GarinLev/Theseus_Maze/Firmware-rpi/YOLOmazeMINSK/test/images/photoMINSK2_20_jpg.rf.ec6164137c1f17c64afc8318696b5939.jpg

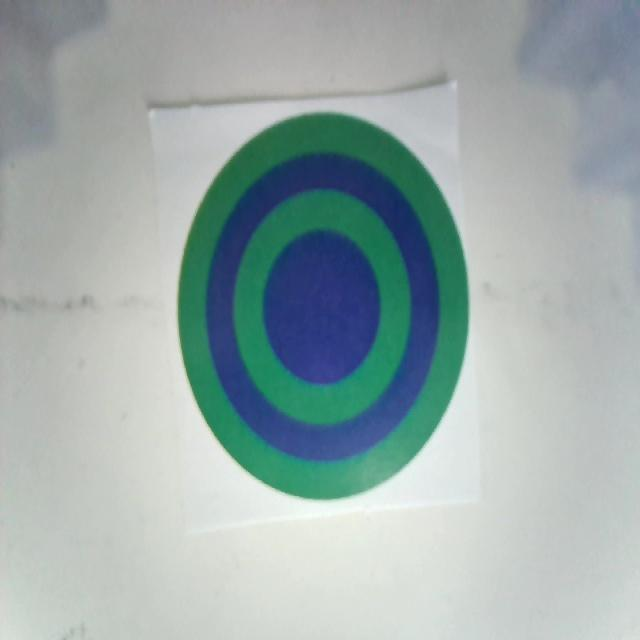
Firmware-rpi/YOLOmazeMINSK/test/images/photoMINSK2_20_jpg.rf.ec6164137c1f17c64afc8318696b5939.jpg
