GarinLev/Theseus_Maze/Firmware-rpi/YOLOmazeMINSK/test/images/photoMINSK2_60_jpg.rf.fc768a8888b5f13d683e1431a5816689.jpg

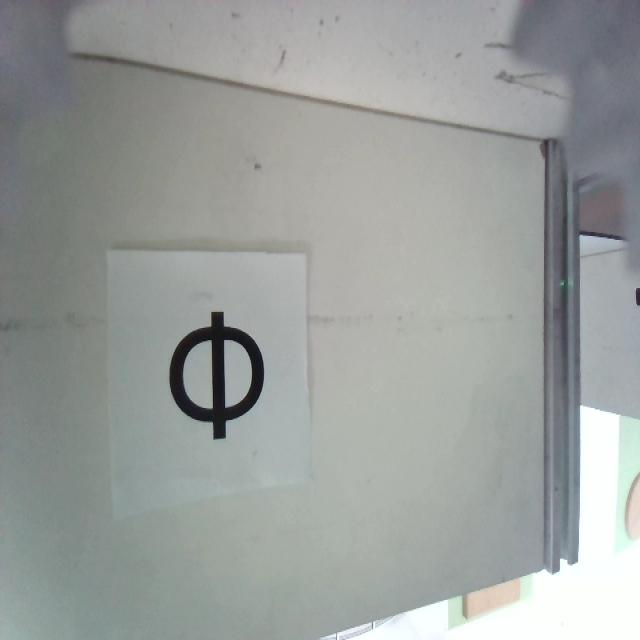
Firmware-rpi/YOLOmazeMINSK/test/images/photoMINSK2_60_jpg.rf.fc768a8888b5f13d683e1431a5816689.jpg
