GarinLev/Theseus_Maze/Documention/maze_konf.pdf.pptx

## Создание робота для исследования лабиринта с препятствиями и маркерами

Команда “Тесей”
RoboCup Runior rescue maze

## Актуальность – роботы для спасания людей

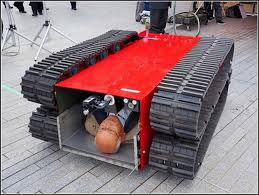
[picture p3: figure]
Марш спасателей: ТОП-10 роботов, которые спешат на помощь
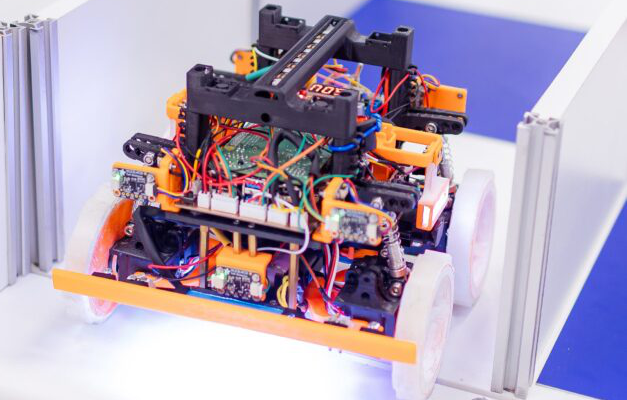
[picture p4: figure]
RCJ Rescue Maze - RoboCupJunior

спасение людей с помощью
роботов это актуальная тема
современного мира

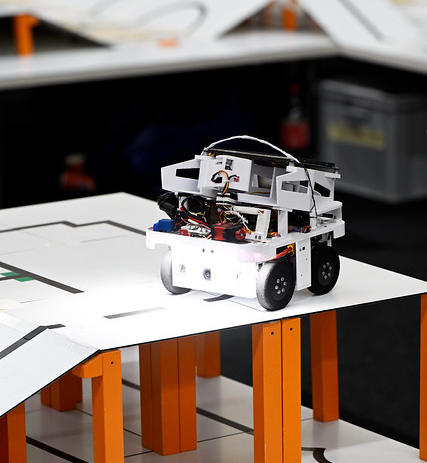
[picture p5: figure]
Rescue Leagues - RoboCupJunior
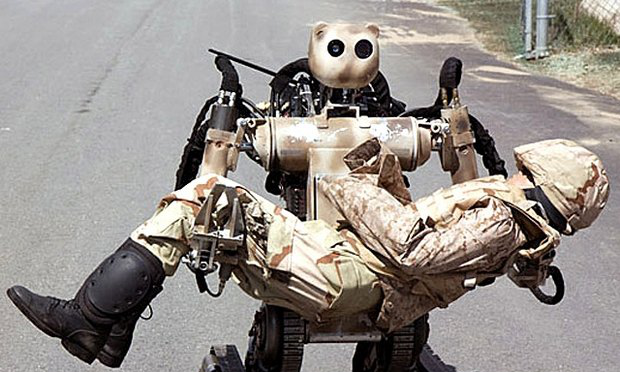
[picture p6: figure]
Как роботы спасают людей / Хабр

## Схожесть с реальной ситуацией

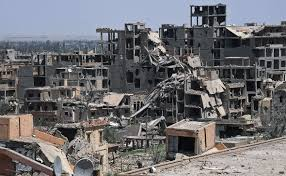
[picture p7: figure]
Силы тигра» разблокировали Дейр-эз-Зор :: Политика :: Газета РБК
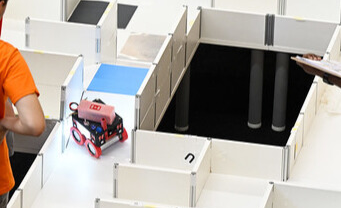
[picture p8: figure]
Rescue Leagues - RoboCupJunior
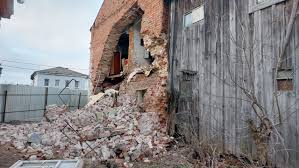
[picture p9: figure]
Если здание рухнет, то заделанные окна никак не помогут»: жительница Судогды рассказала про разрушенный дом | 31.01.2025 | Владимир - БезФормата
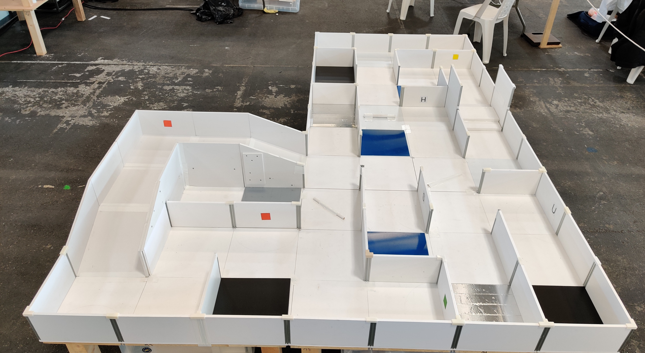
[picture p10: figure]
Competition Fields | 2023 Maze Competition

## Slide 4

Цель - создать робота, для прохождения лабиринта

Анализ аналогов

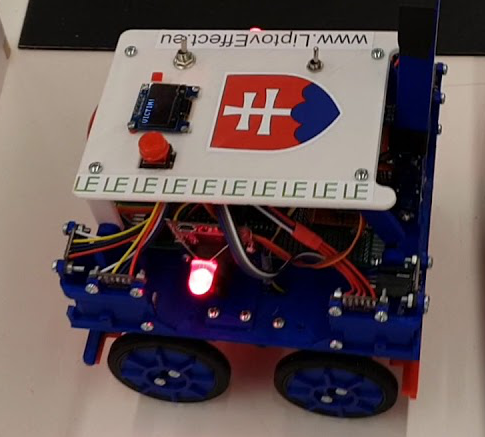
[picture p11: figure]
Robocup Junior 2018 Montreal Rescue Maze | Team liptoveffect.eu
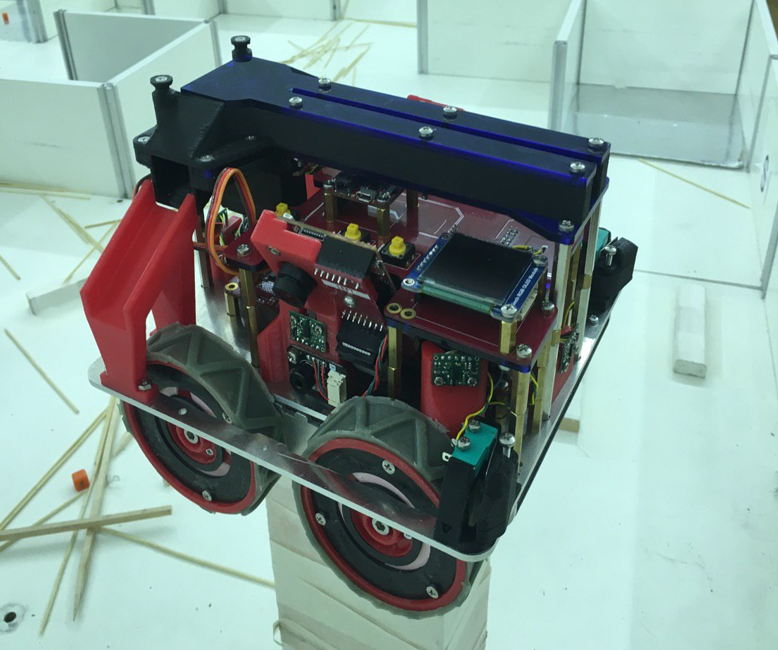
[picture p12: figure]
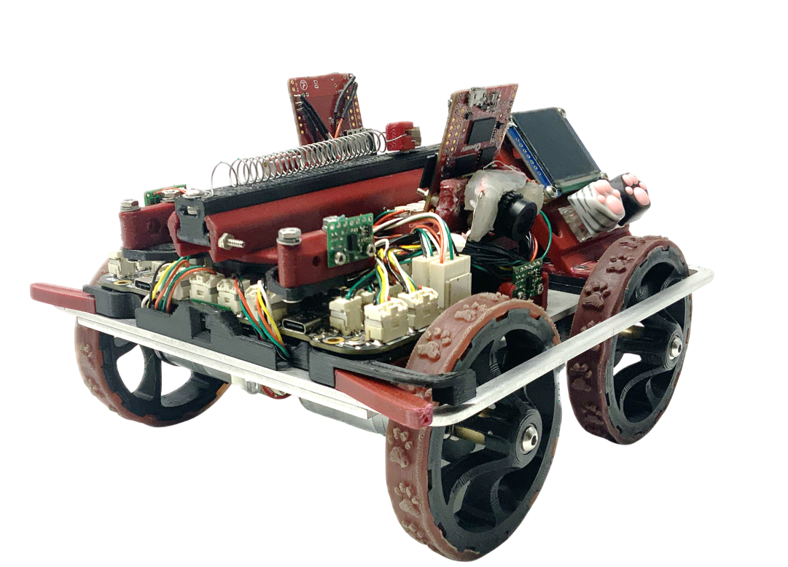
[picture p13: figure]
Изображение выглядит как колесо, автокомпонент, шина, Масштабная модель Контент, сгенерированный ИИ, может содержать ошибки.

Создание концепции своего робота

## Задача

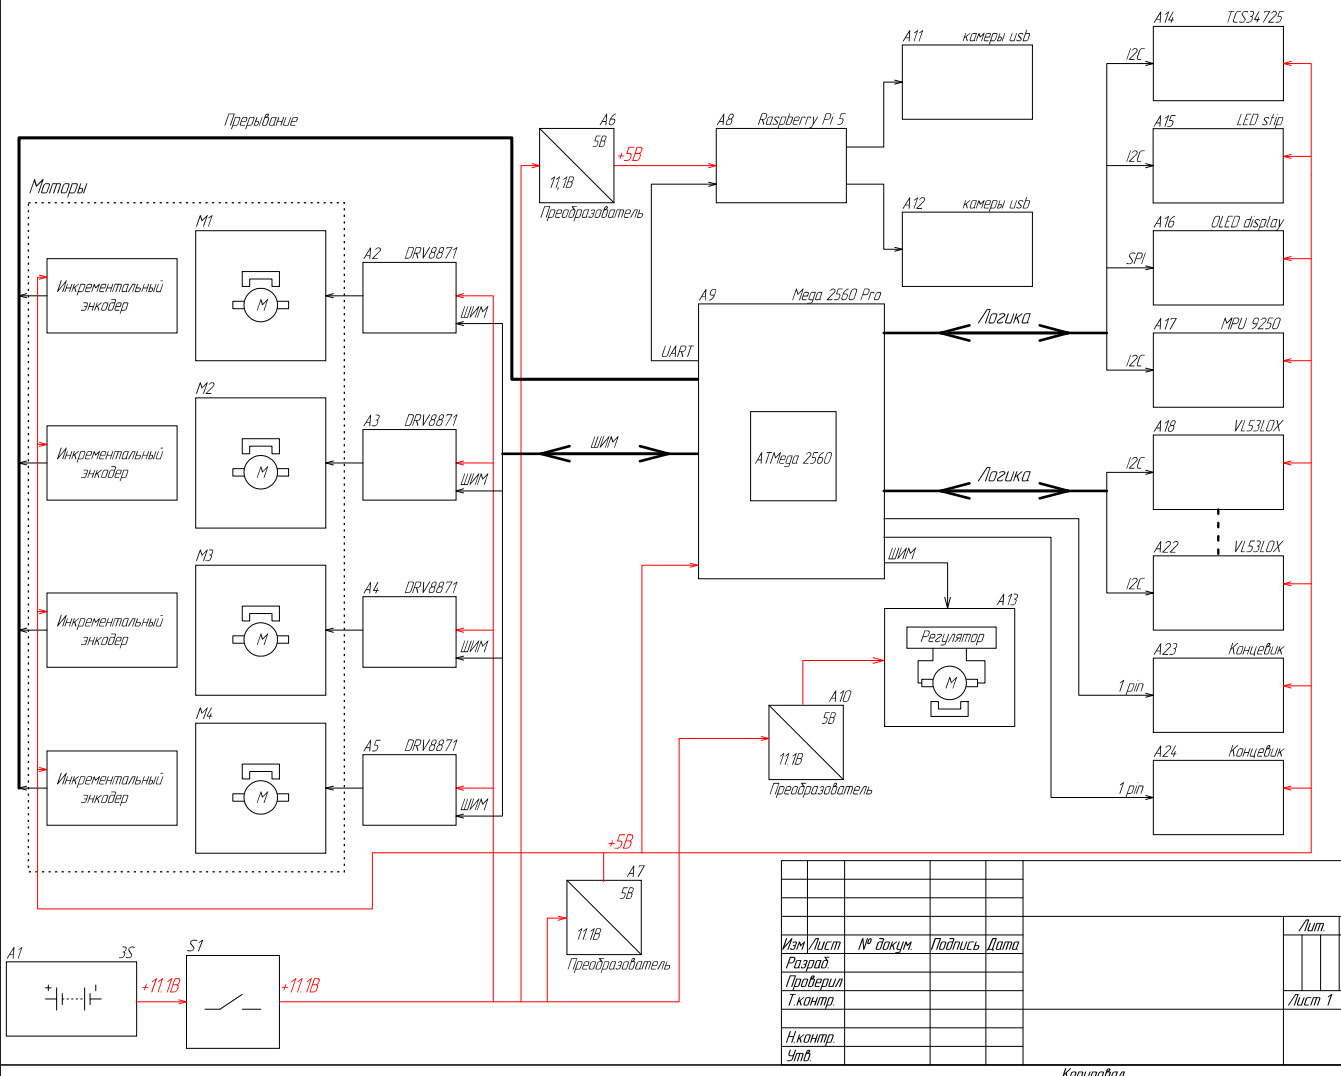
[picture p14: figure]

Схема

Notes: В качестве основного контролера используются Raspberry Pi 5. Он используется для камер и алгоритма поиска путей. Для управления электроникой, считывания значений с датчиков Arduino Mega 2560 Pro. Связь между ними осуществлена с помощью UART и логического преобразователя.
Для передвижения по лабиринту мы используем моторы. Для распознавания положения робота в клетке лазерные датчики VL53L0X.

## Разработка конструкции

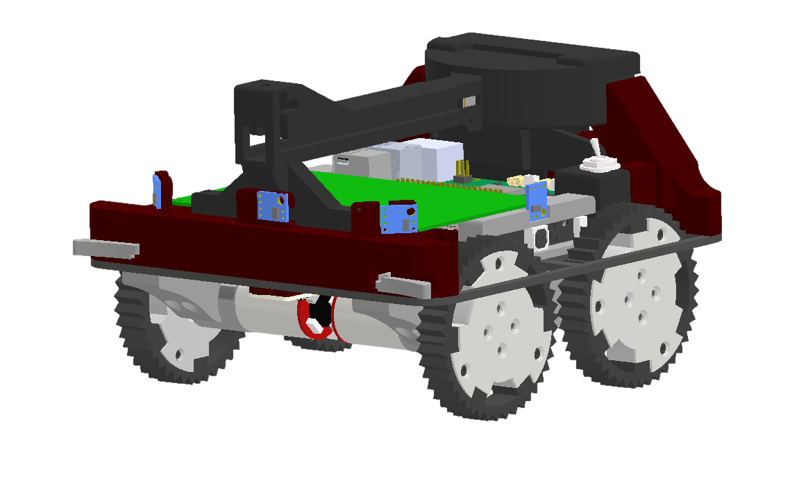
[picture p15: figure]
Изображение выглядит как колесо, Масштабная модель, игрушка, транспортное средство Контент, сгенерированный ИИ, может содержать ошибки.

Передняя часть

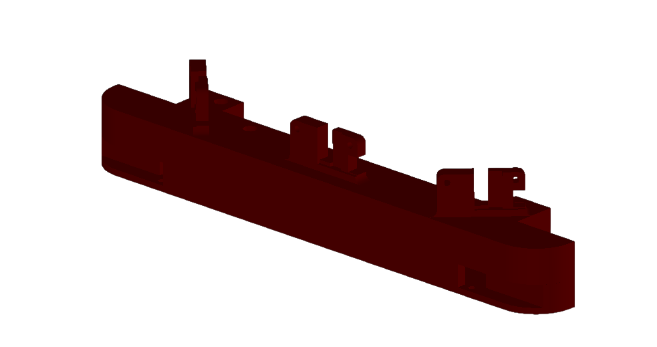
[picture p16: figure]
Изображение выглядит как снимок экрана Контент, сгенерированный ИИ, может содержать ошибки.

Задняя часть

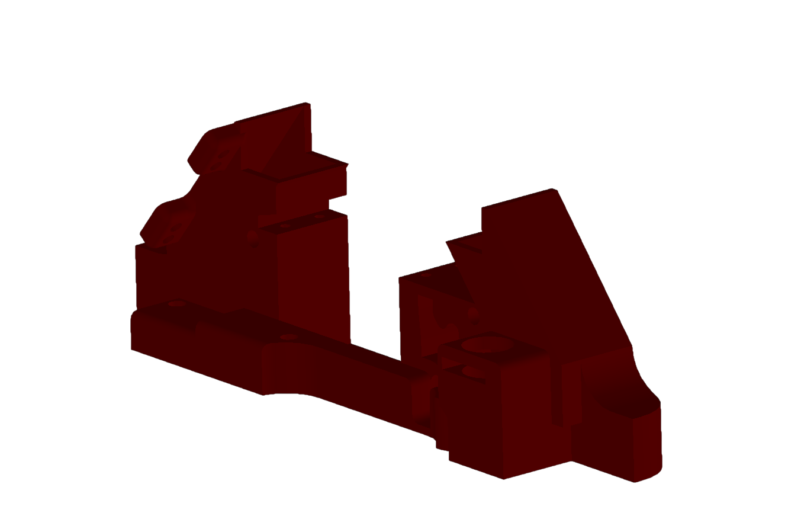
[picture p17: figure]
Изображение выглядит как красный Контент, сгенерированный ИИ, может содержать ошибки.

Система выдачи

Ходовая часть

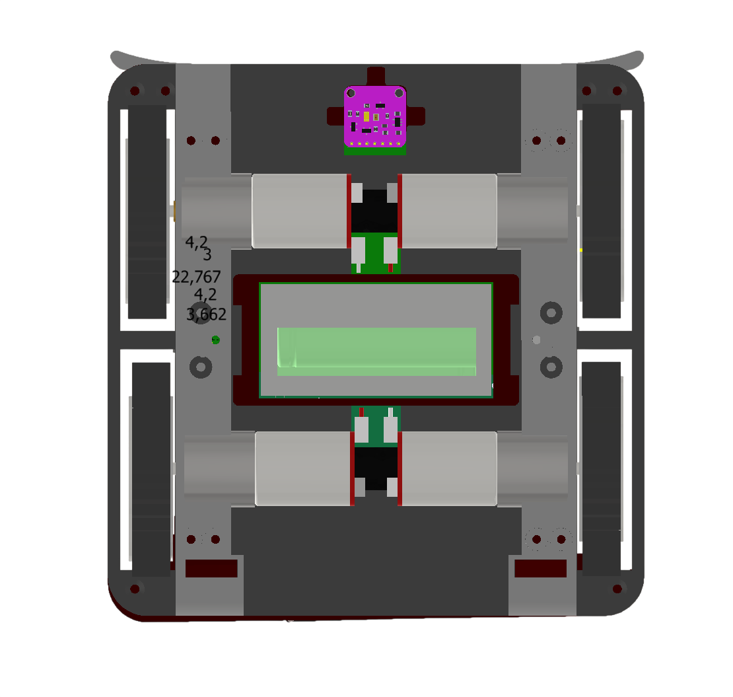
[picture p18: figure]
Изображение выглядит как снимок экрана Контент, сгенерированный ИИ, может содержать ошибки.
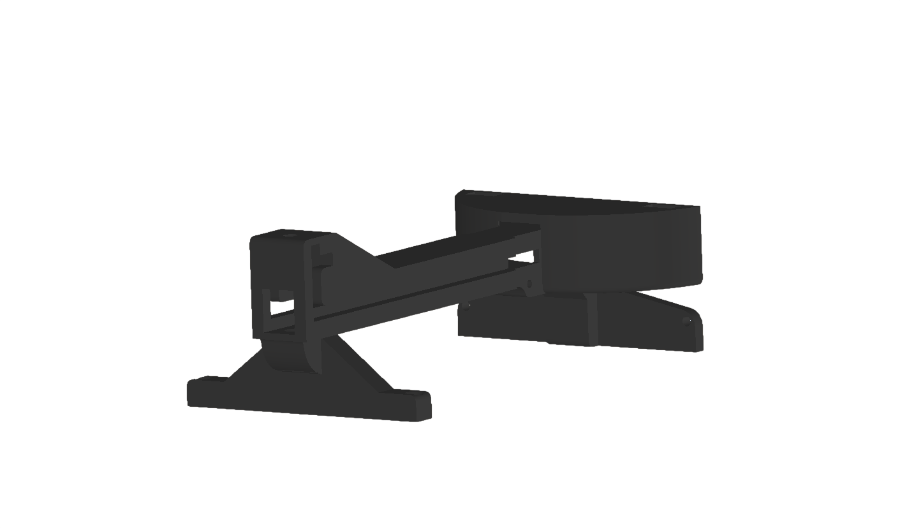
[picture p19: figure]

Notes: Наш робот смоделирован в программном обеспечении Autodesk inventor. Робот напечатан на 3D принтере PETG или PLA пластиком.

Для рамы мы использовали стеклонаполненный пластик для улучшения прочности робота. Что бы максимально уменьшить робота для проходимости в лабиринте, был спроектирован и сварен свой аккумулятор из ячеек Li-ion 18650 в конфигурации 3S1P. Корпус аккумулятора обеспечивает его быстросъёмность, так как фиксация в корпусе происходит посредством отгибающихся лепестков.

Модель робота для печати была разбита на переднюю и заднюю часть, ходовую часть и систему выдачи. В передней части расположены 3 датчика, концевики и место под крепления макетной платы. В задней части находится сервопривод, один датчик и барабан, который при вращение сортирует наборы по разным сторонам. Система выдачи толкает наборы по горизонтальному каналу системы выдачи, после чего наборы попадают в барабан
для выдачи их к жертве.



Были спроектированы собственные колеса робота. Имеющие переменную жесткость за счет своей формы. Диски колеса распечатаны на 3D принтере, а шины отлиты из двухкомпонентного полиуретана в распечатанные формы.

## Способ преодоления препятствий До После

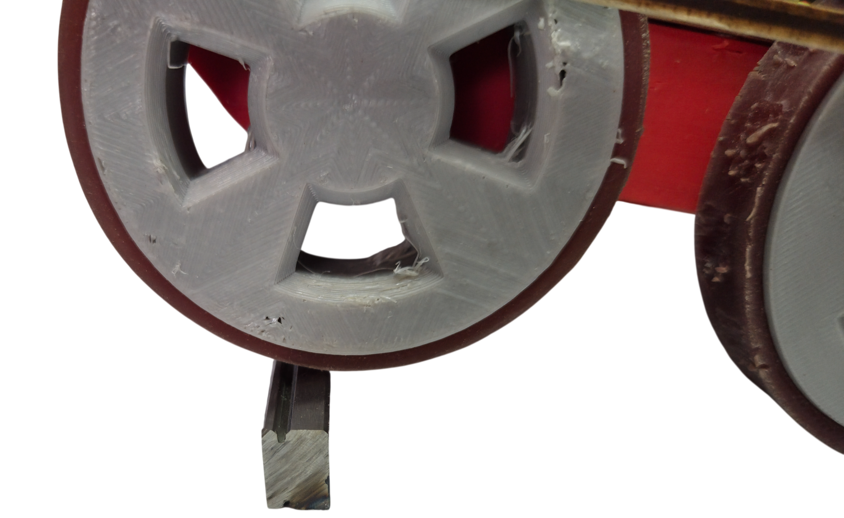
[picture p20: figure]
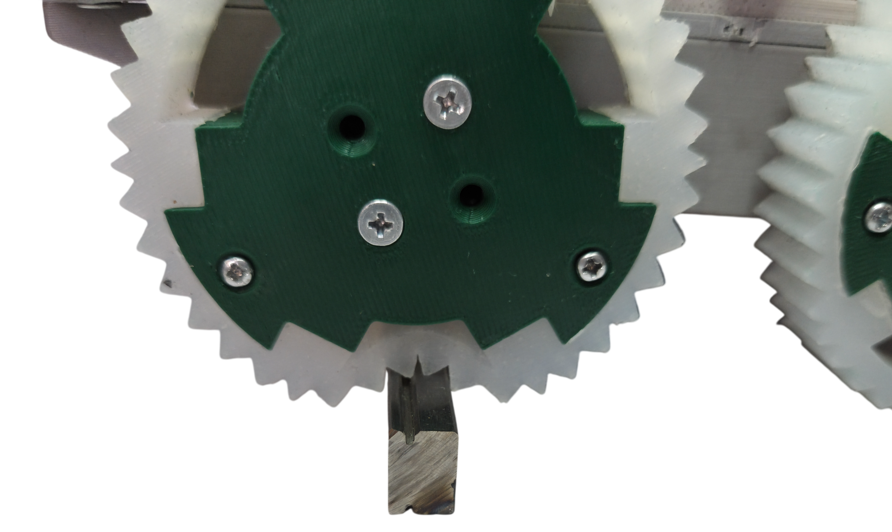
[picture p21: figure]
Изображение выглядит как шестерня, металлоизделия, колесо, транспорт Контент, сгенерированный ИИ, может содержать ошибки.

Notes: Основным способом у нас считаются особенные колёса.
Для этого были спроектированы собственные колеса робота. Диски колеса распечатаны на 3D принтере, а шины отлиты из двухкомпонентного полиуретана в распечатанные формы.

Колёса имеют переменную жесткость за счет своей формы, в отличии от обычных

## Программное обеспечение для Arduino

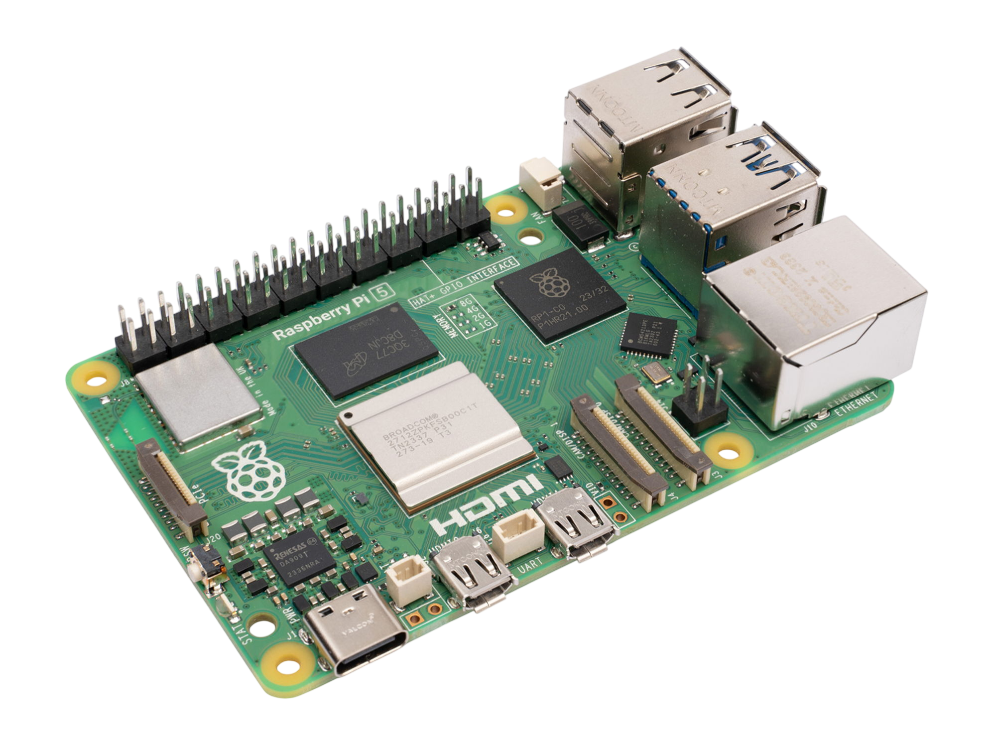
[picture p22: figure]
Изображение выглядит как электроника, Электронный компонент, Компонент схемы, Электронная техника Контент, сгенерированный ИИ, может содержать ошибки.
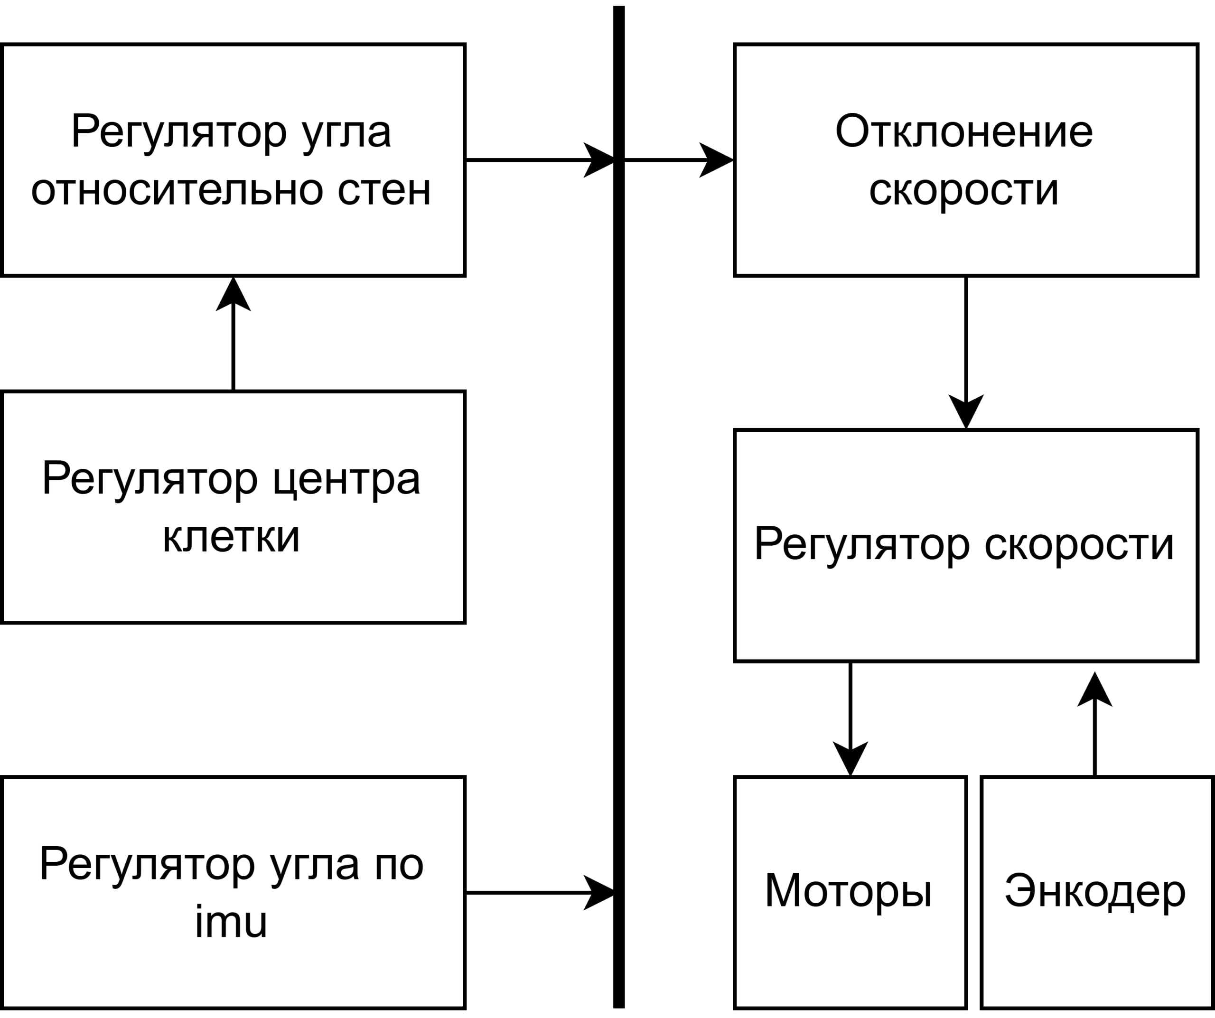
[picture p23: figure]
Изображение выглядит как текст, снимок экрана, диаграмма, Шрифт Контент, сгенерированный ИИ, может содержать ошибки.
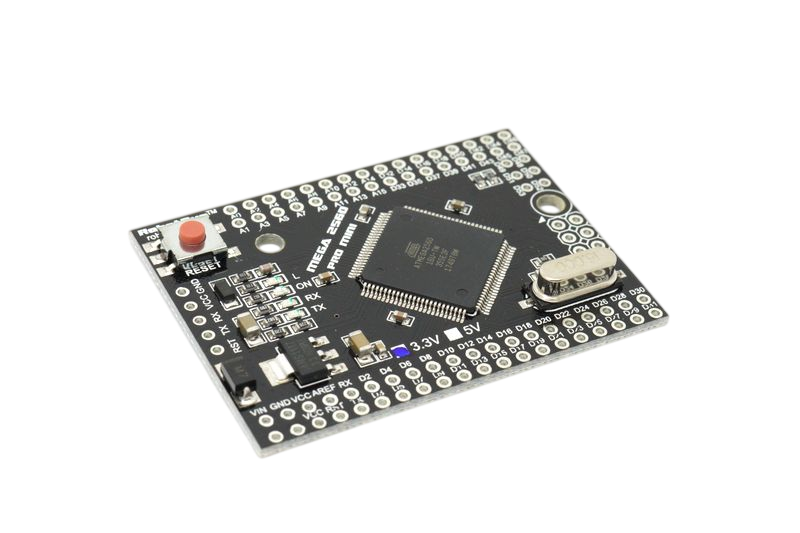
[picture p24: figure]
Изображение выглядит как электроника, Электронная техника, Электронный компонент, Компонент схемы Контент, сгенерированный ИИ, может содержать ошибки.

Notes: Робот принимает пакеты данных с Raspberry Pi по протоколу UART, проверяет контрольную сумму CRC8 и выполняет действие, после чего отправляет значения всех датчиков. Для поддержания заданной скорости колёс используется ПИ-регулятор.
Программа для Arduino Mega предназначена для управления четырьмя колёсами, сервоприводом для выдачи наборов и RGB-лентой для цветового оповещения. Код разделен на обособленные части для каждого компонента; для управления ими используется кооперативная многозадачность.
Для проезда на клетку вперёд проверяется наличие стен вокруг. При их обнаружении задействуется регулятор выравнивания угла относительно стены и центрирования положения между ними. Если во время движения приходит команда выдачи набора, программа прерывает выполнение задачи проезда и переходит в состояние выдачи. Если стены найти не удалось, используется проезд по инерциальному датчику

## Slide 9

Программное обеспечение для Raspberry

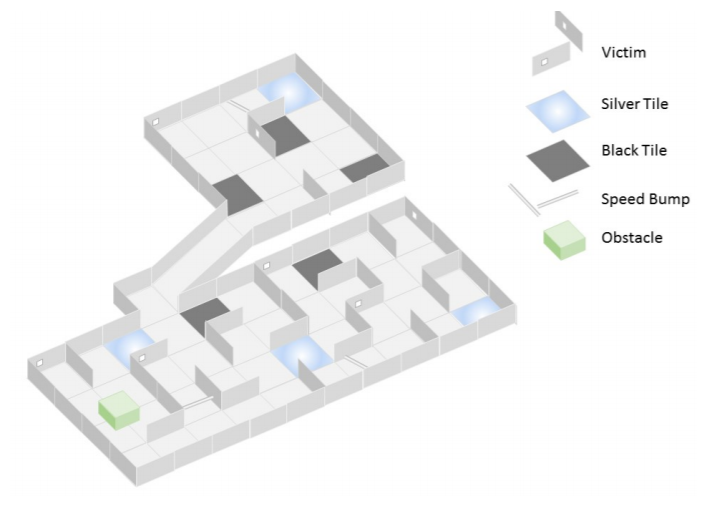
[picture p25: figure]
Robocup Junior Maze
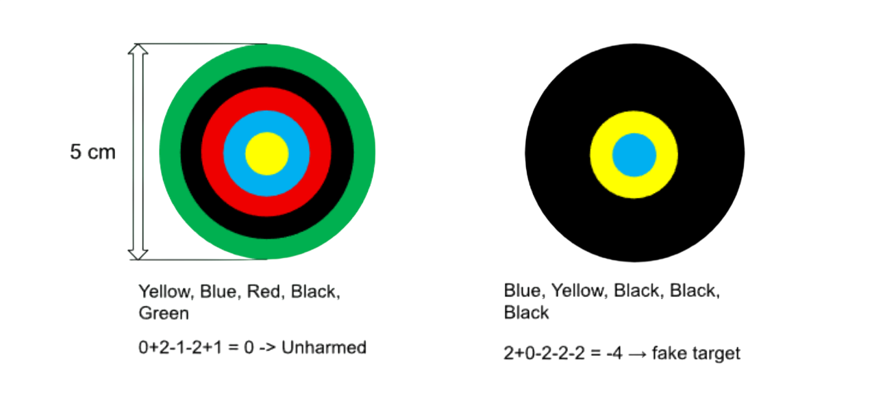
[picture p26: figure]
Изображение выглядит как круг, снимок экрана, Красочность, Графика Контент, сгенерированный ИИ, может содержать ошибки.
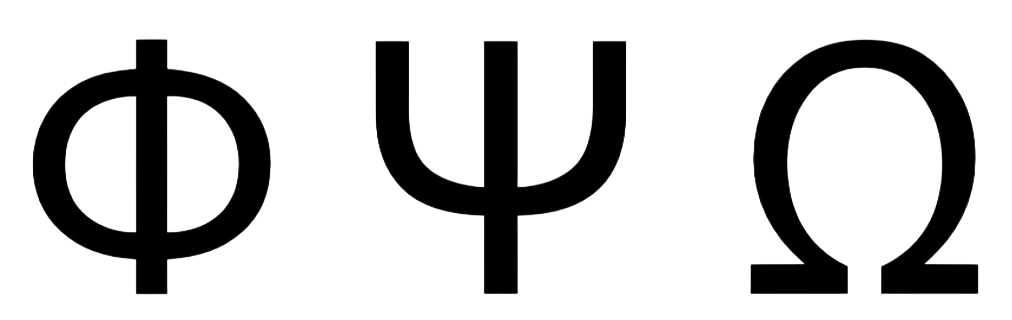
[picture p27: figure]
Изображение выглядит как черный, темнота, пространство, снимок экрана Контент, сгенерированный ИИ, может содержать ошибки.

Notes: Raspberry Pi 5 мы используем для разработки алгоритма езды и поиска путей. Мы едем по правой руке по лабиринту картографируя его. Когда мы попадем в замкнутый круг мы начинаем искать те клетки в которых ещё не были, а когда таких нету мы начинаем поиск проезда до начала лабиринта

Для когнитивных целей используется компьютерное зрение, программируемое на языке python с помощью библиотеки cv2.


Для распознания буквенных жертв используется нейронная сеть YOLO. Мы обучаем её на основе уже сделанных фото жертв в полигоне с камер на роботе.

Для распознания буквенных жертв используется нейронная сеть YOLO. Мы обучаем её на основе уже сделанных фото жертв в полигоне с камер на роботе.

## Спасибо за внимание

Участники:
Лев Гарин, Каверзнев Дмитрий
Преподаватели:
Мерзлякова Юлия Игоревна,
Викторов Борис Викторевич
