GarinLev/Theseus_Maze/Firmware-rpi/0009_critical_-2.png

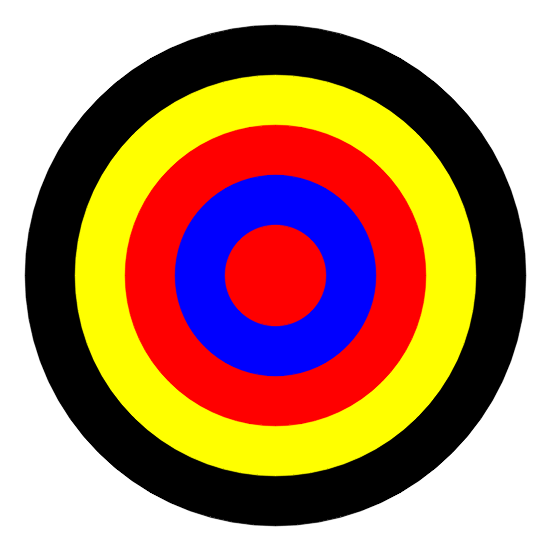
Firmware-rpi/0009_critical_-2.png
