GarinLev/Theseus_Maze/Firmware-rpi/0013_unharmed_0.png

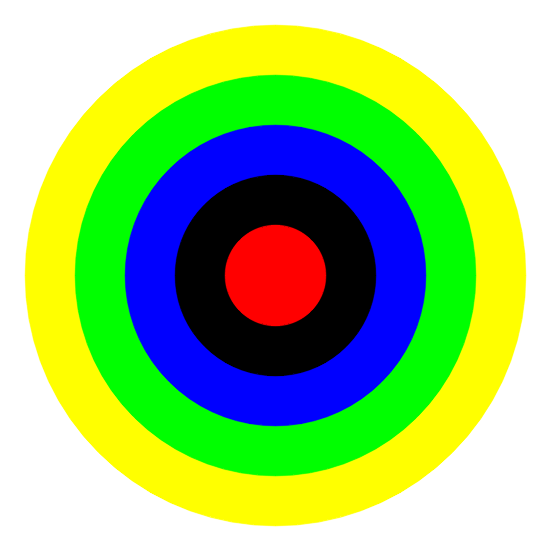
Firmware-rpi/0013_unharmed_0.png
