GarinLev/Theseus_Maze/Firmware-rpi/photo_12.jpg

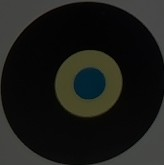
Firmware-rpi/photo_12.jpg
