GarinLev/Theseus_Maze/Firmware-rpi/photo_14.jpg

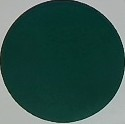
Firmware-rpi/photo_14.jpg
