GarinLev/Theseus_Maze/Firmware-rpi/photo_37.jpg

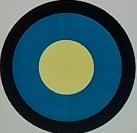
Firmware-rpi/photo_37.jpg
