GarinLev/Theseus_Maze/Firmware-rpi/photo_41.jpg

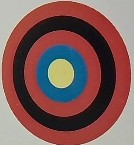
Firmware-rpi/photo_41.jpg
