GarinLev/Theseus_Maze/Firmware-rpi/photo_43.jpg

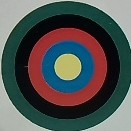
Firmware-rpi/photo_43.jpg
