GarinLev/Theseus_Maze/Firmware-rpi/YOLOmazeMINSK/runs/detect/train2/BoxF1_curve.png

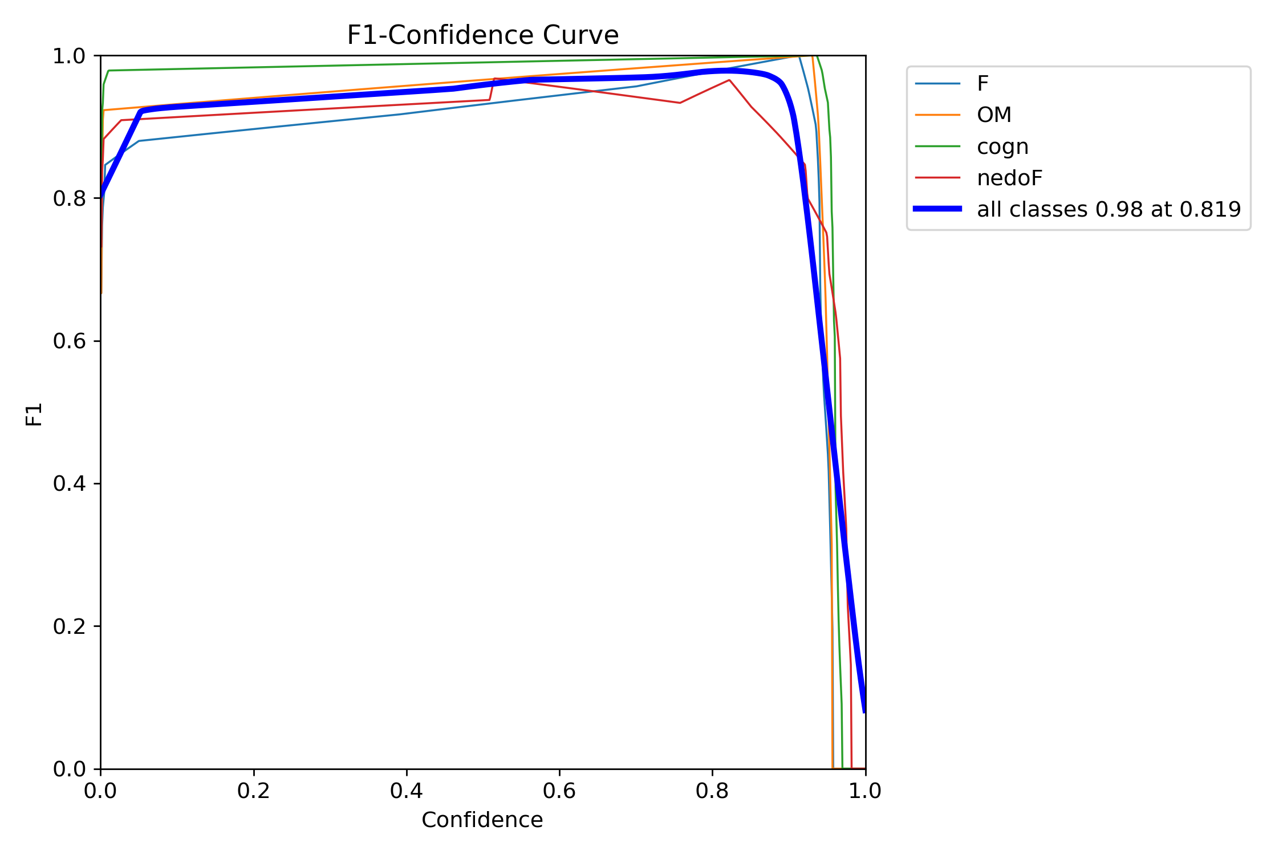
Firmware-rpi/YOLOmazeMINSK/runs/detect/train2/BoxF1_curve.png
