GarinLev/Theseus_Maze/Firmware-rpi/YOLOmazeMINSK/runs/detect/train2/BoxPR_curve.png

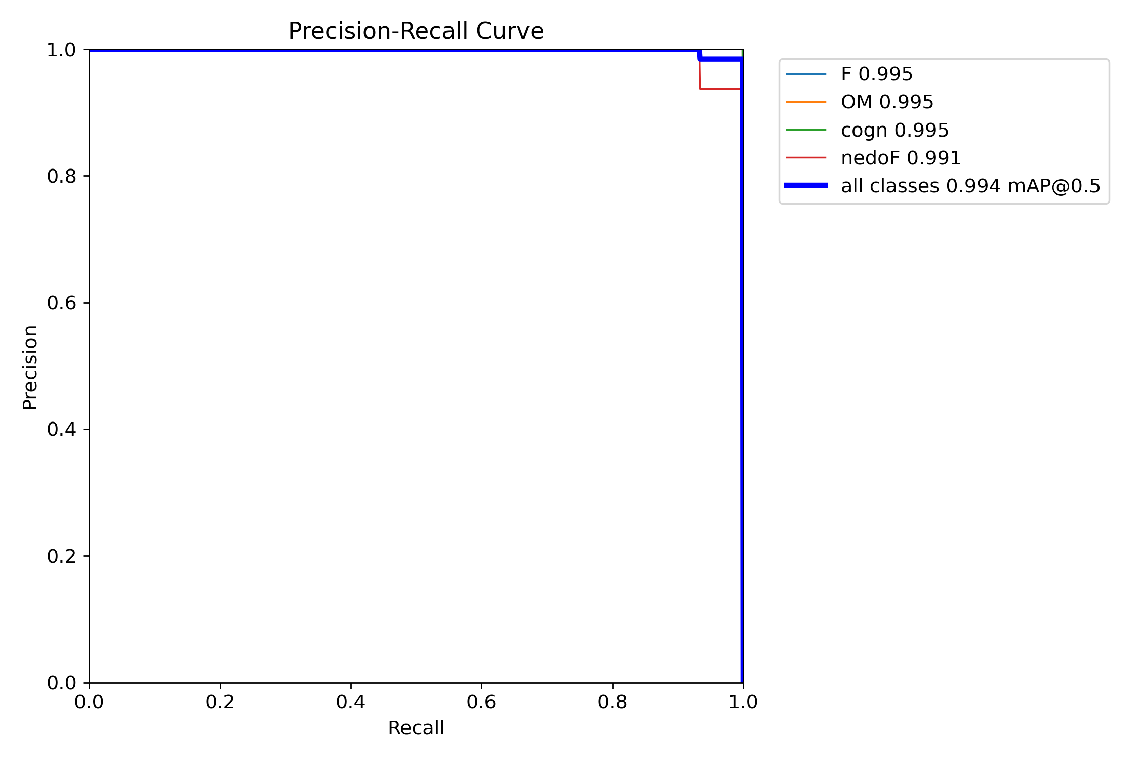
Firmware-rpi/YOLOmazeMINSK/runs/detect/train2/BoxPR_curve.png
