GarinLev/Theseus_Maze/Firmware-rpi/YOLOmazeMINSK/runs/detect/train2/confusion_matrix_normalized.png

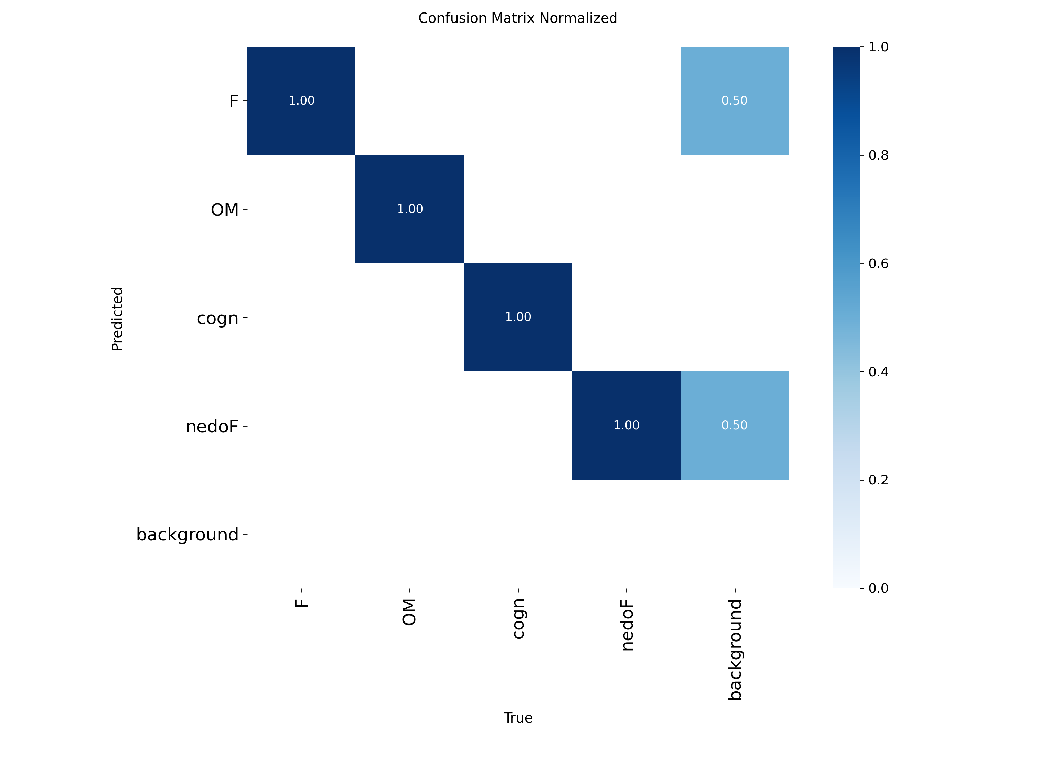
Firmware-rpi/YOLOmazeMINSK/runs/detect/train2/confusion_matrix_normalized.png
