GarinLev/Theseus_Maze/Firmware-rpi/YOLOmazeMINSK/runs/detect/train2/labels.jpg

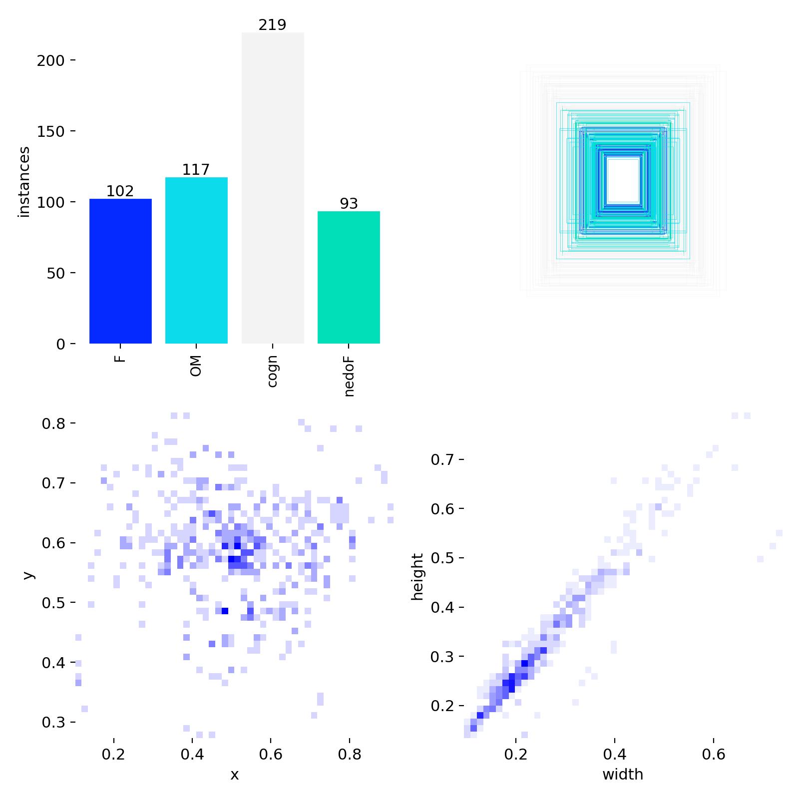
Firmware-rpi/YOLOmazeMINSK/runs/detect/train2/labels.jpg
