GarinLev/Theseus_Maze/Firmware-rpi/YOLOmazeMINSK/runs/detect/train2/train_batch0.jpg

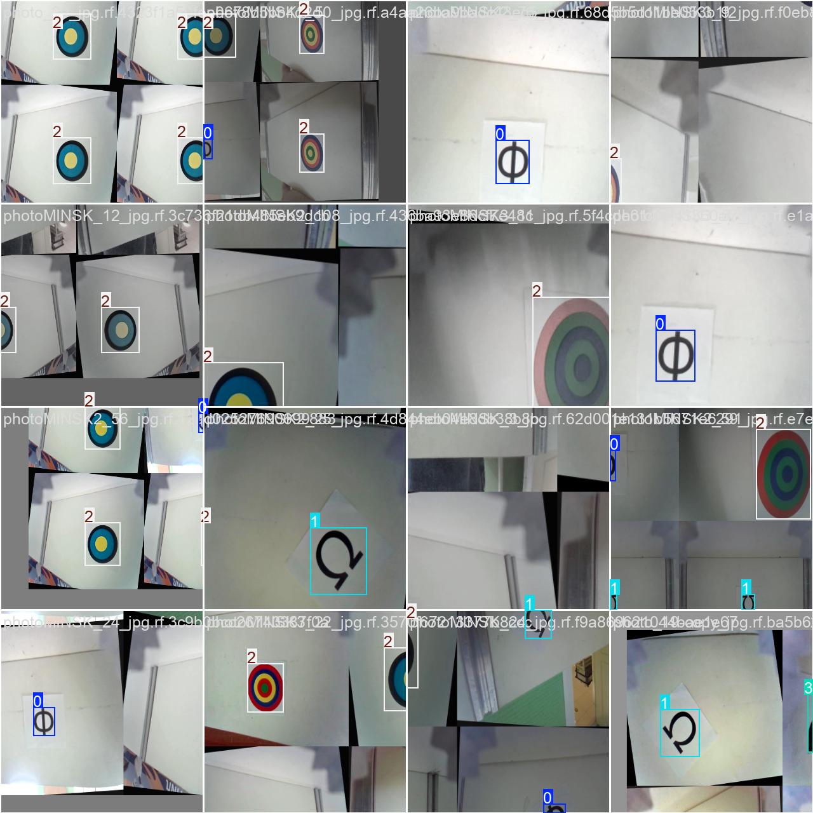
Firmware-rpi/YOLOmazeMINSK/runs/detect/train2/train_batch0.jpg
