GarinLev/Theseus_Maze/Firmware-rpi/YOLOmazeMINSK/runs/detect/train2/train_batch2.jpg

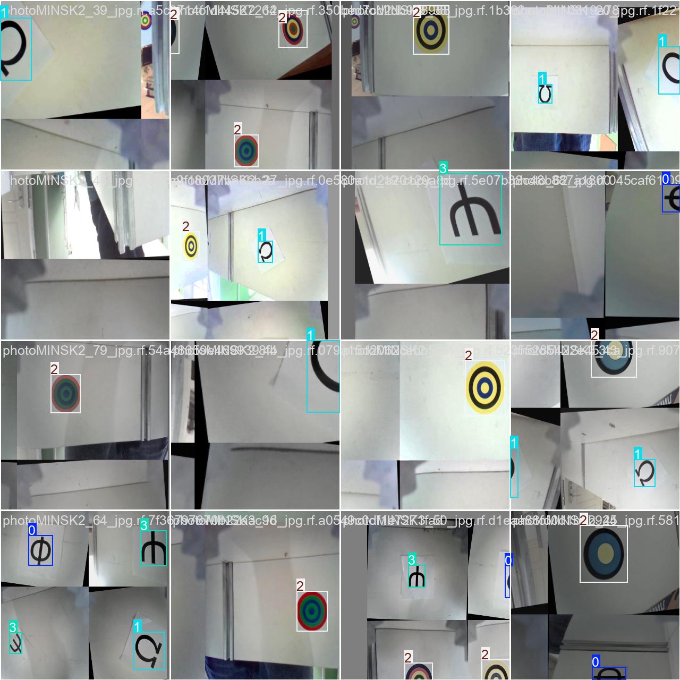
Firmware-rpi/YOLOmazeMINSK/runs/detect/train2/train_batch2.jpg
