GarinLev/Theseus_Maze/Firmware-rpi/YOLOmazeMINSK/runs/detect/train2/train_batch3060.jpg

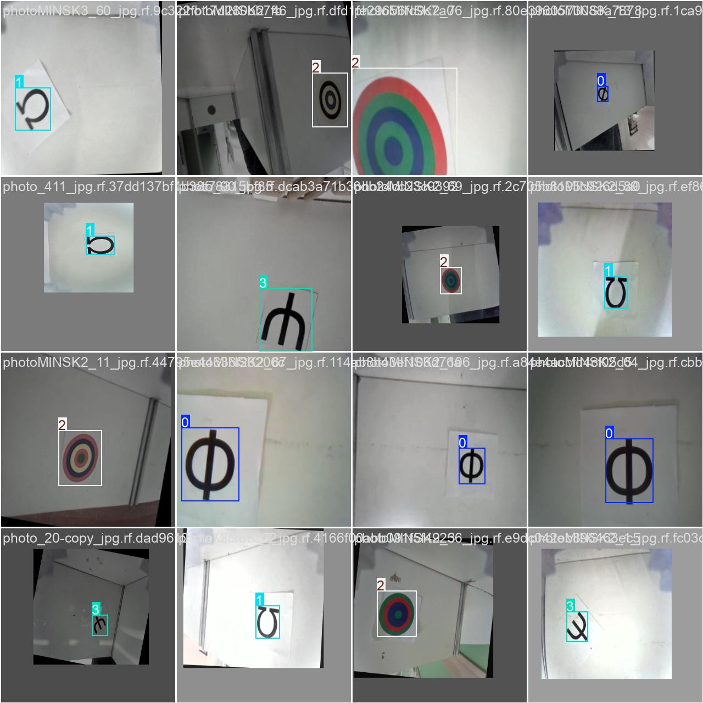
Firmware-rpi/YOLOmazeMINSK/runs/detect/train2/train_batch3060.jpg
