GarinLev/Theseus_Maze/Firmware-rpi/YOLOmazeMINSK/runs/detect/train2/val_batch0_labels.jpg

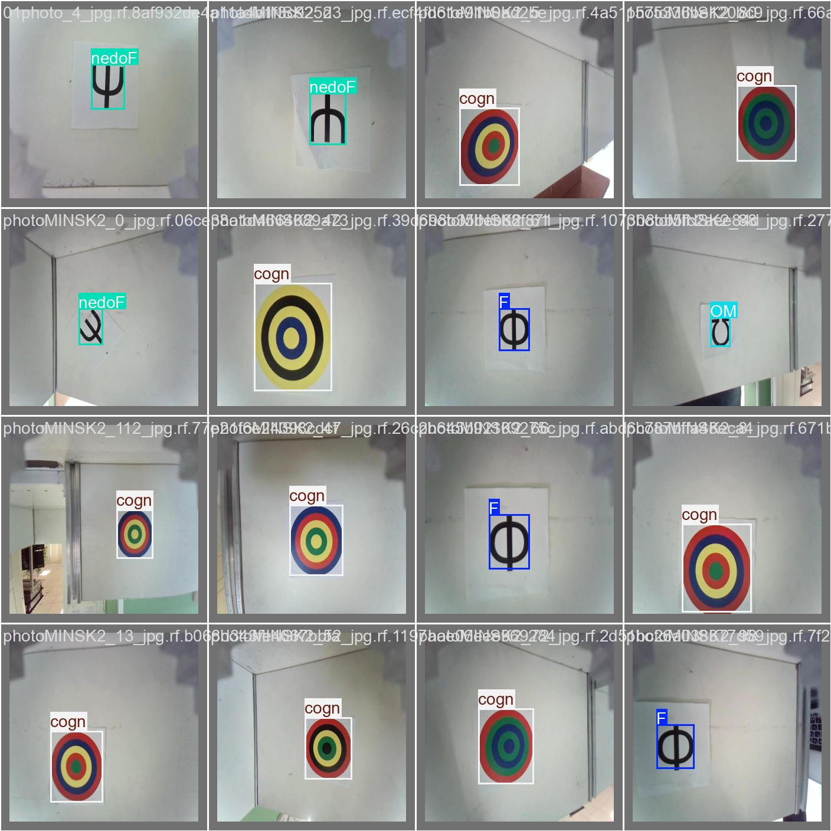
Firmware-rpi/YOLOmazeMINSK/runs/detect/train2/val_batch0_labels.jpg
