GarinLev/Theseus_Maze/Firmware-rpi/YOLOmazeMINSK/runs/detect/train/BoxP_curve.png

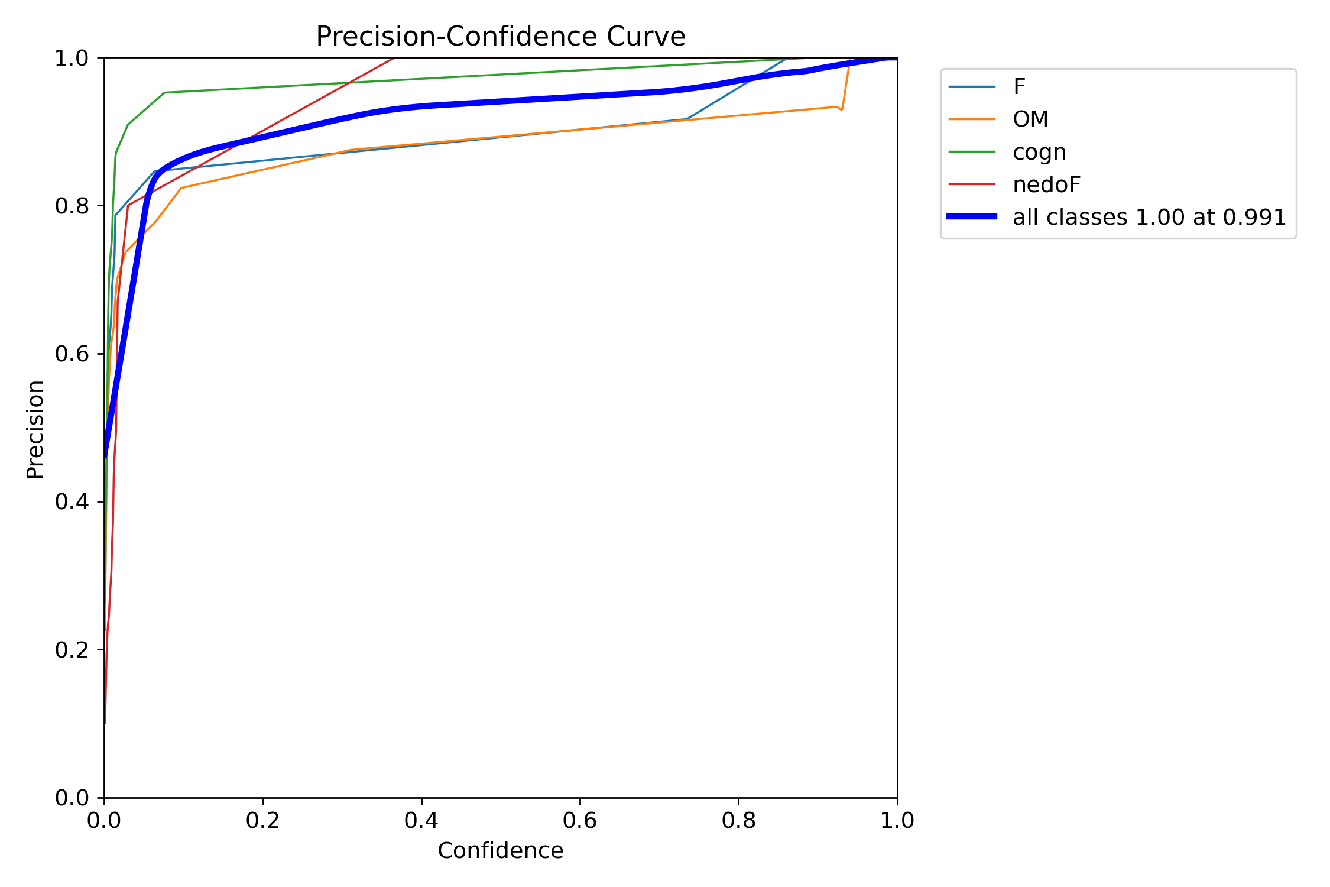
Firmware-rpi/YOLOmazeMINSK/runs/detect/train/BoxP_curve.png
