GarinLev/Theseus_Maze/Firmware-rpi/YOLOmazeMINSK/runs/detect/train/confusion_matrix.png

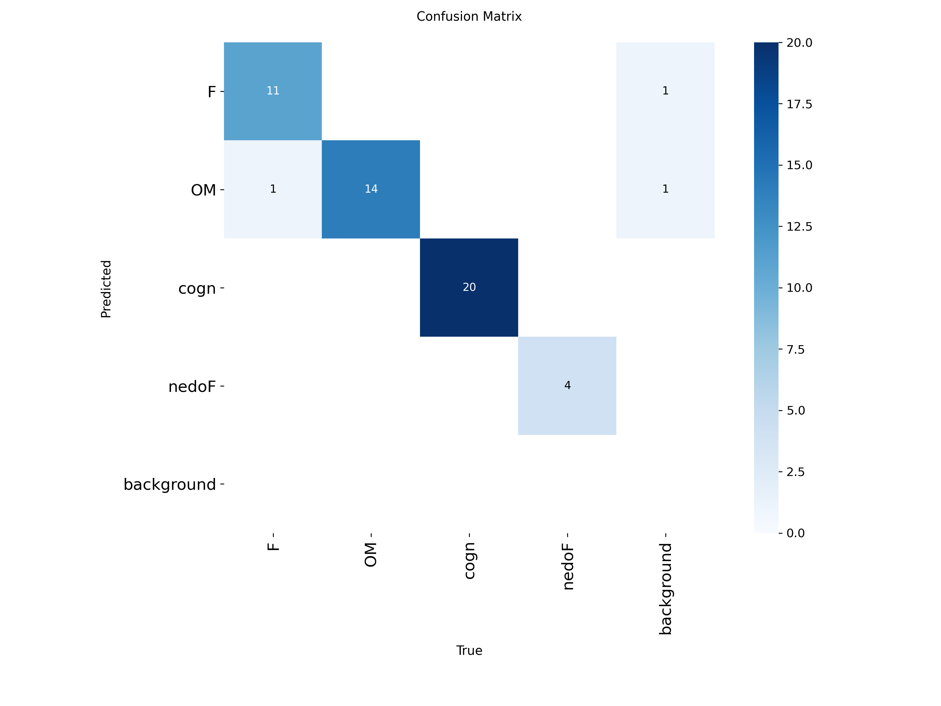
Firmware-rpi/YOLOmazeMINSK/runs/detect/train/confusion_matrix.png
