GarinLev/Theseus_Maze/Firmware-rpi/YOLOmazeMINSK/runs/detect/train/labels.jpg

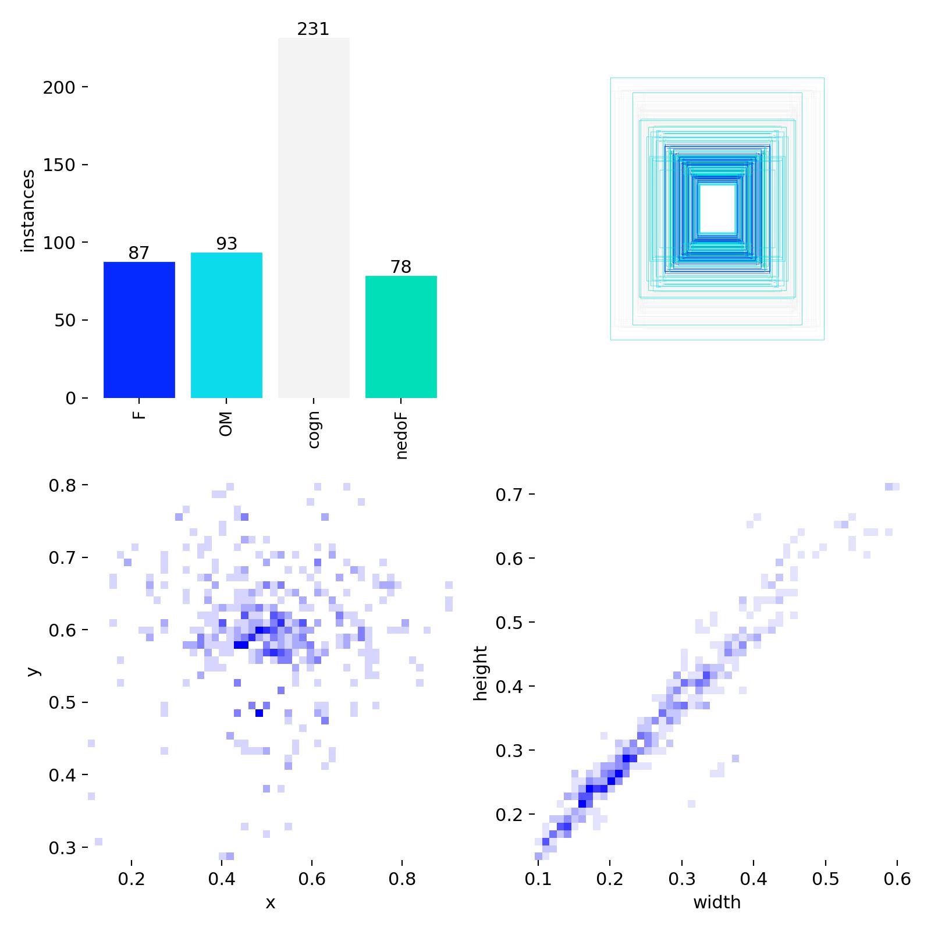
Firmware-rpi/YOLOmazeMINSK/runs/detect/train/labels.jpg
