GarinLev/Theseus_Maze/Firmware-rpi/YOLOmazeMINSK/runs/detect/train/train_batch2.jpg

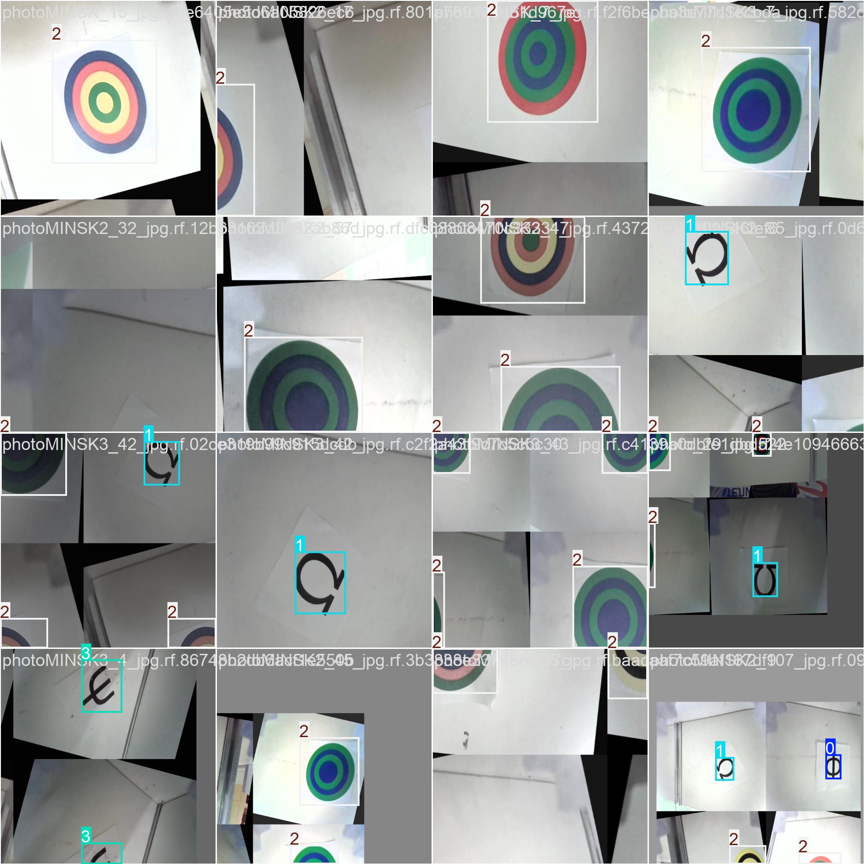
Firmware-rpi/YOLOmazeMINSK/runs/detect/train/train_batch2.jpg
