GarinLev/Theseus_Maze/Firmware-rpi/YOLOmazeMINSK/runs/detect/train/train_batch1550.jpg

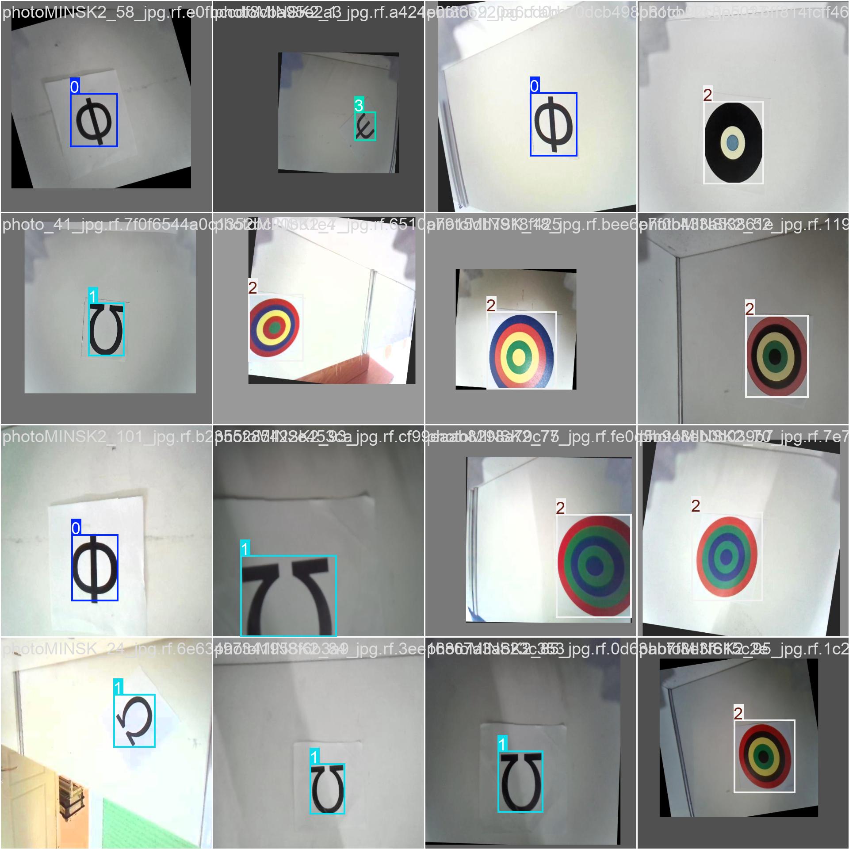
Firmware-rpi/YOLOmazeMINSK/runs/detect/train/train_batch1550.jpg
