GarinLev/Theseus_Maze/Firmware-rpi/YOLOmazeMINSK/runs/detect/train/train_batch1552.jpg

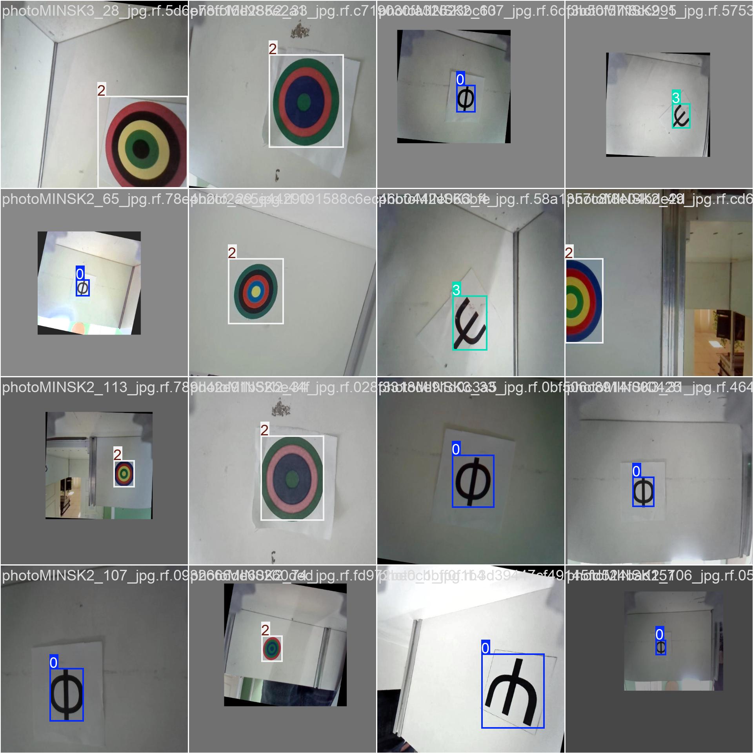
Firmware-rpi/YOLOmazeMINSK/runs/detect/train/train_batch1552.jpg
