GarinLev/Theseus_Maze/Firmware-rpi/YOLOmazeMINSK/valid/images/photo_2_jpg.rf.d231389361c17eb98d468609f3844cb6.jpg

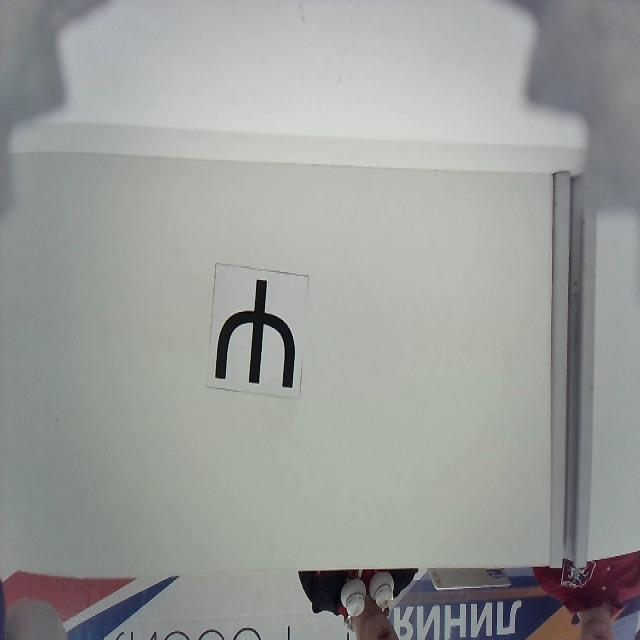
Firmware-rpi/YOLOmazeMINSK/valid/images/photo_2_jpg.rf.d231389361c17eb98d468609f3844cb6.jpg
