GarinLev/Theseus_Maze/Firmware-rpi/YOLOmazeMINSK/valid/images/photo_8_jpg.rf.9a8f130c2fd47f7036db581c19f1b032.jpg

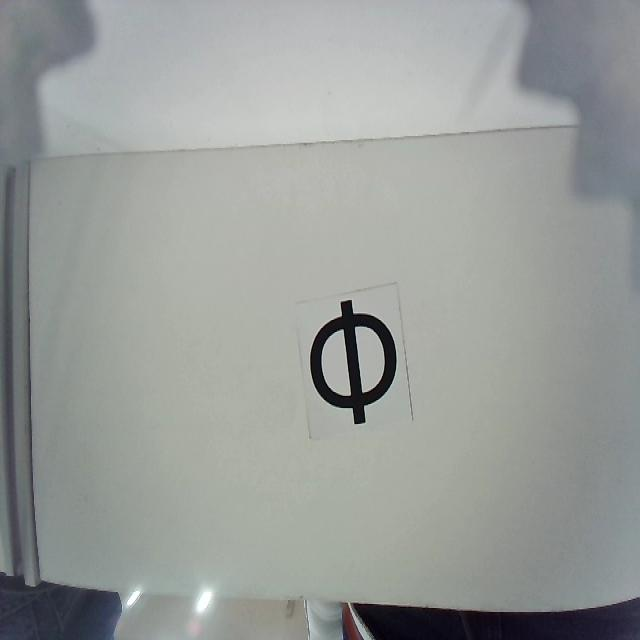
Firmware-rpi/YOLOmazeMINSK/valid/images/photo_8_jpg.rf.9a8f130c2fd47f7036db581c19f1b032.jpg
