GarinLev/Theseus_Maze/Firmware-rpi/YOLOmazeMINSK/valid/images/photo_23_jpg.rf.431b37f80fdaf00b54d127120dc3ab56.jpg

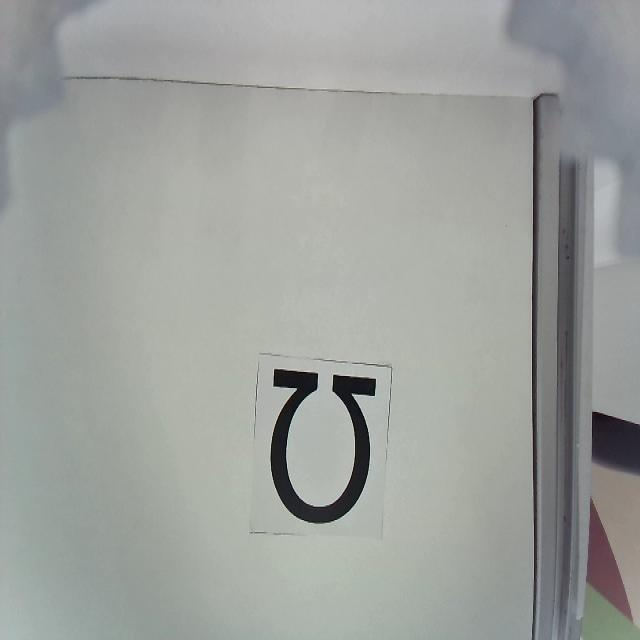
Firmware-rpi/YOLOmazeMINSK/valid/images/photo_23_jpg.rf.431b37f80fdaf00b54d127120dc3ab56.jpg
