GarinLev/Theseus_Maze/Firmware-rpi/YOLOmazeMINSK/valid/images/photo_25_jpg.rf.424e68be355fe93c4aea49201ae01b50.jpg

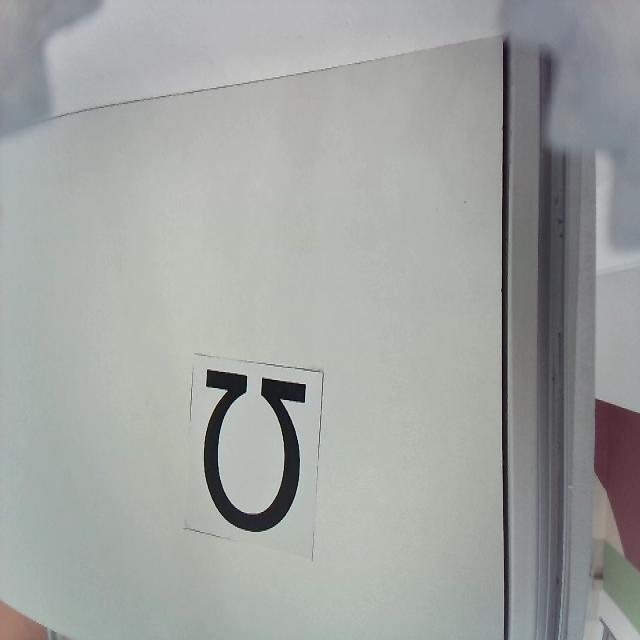
Firmware-rpi/YOLOmazeMINSK/valid/images/photo_25_jpg.rf.424e68be355fe93c4aea49201ae01b50.jpg
