GarinLev/Theseus_Maze/Firmware-rpi/YOLOmazeMINSK/valid/images/photo_35_jpg.rf.38aa4155de912e12c1f1f9ac93a501c3.jpg

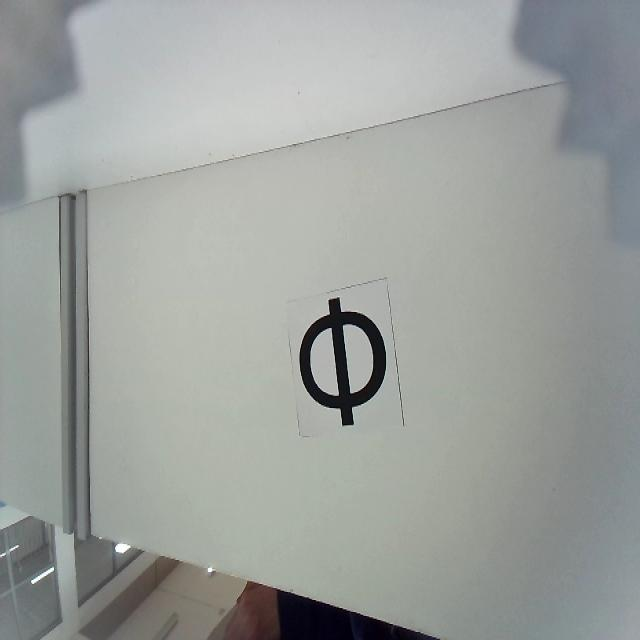
Firmware-rpi/YOLOmazeMINSK/valid/images/photo_35_jpg.rf.38aa4155de912e12c1f1f9ac93a501c3.jpg
