GarinLev/Theseus_Maze/Firmware-rpi/YOLOmazeMINSK/valid/images/photo_37_jpg.rf.5798d28824521689e4e56326ce15f14a.jpg

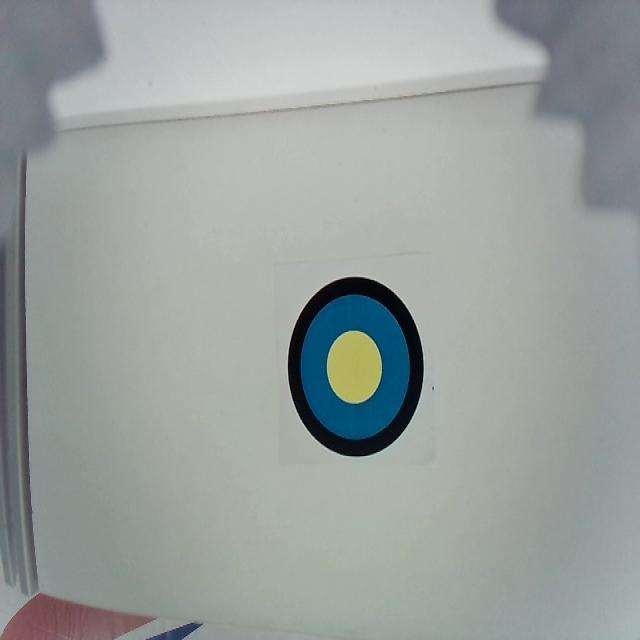
Firmware-rpi/YOLOmazeMINSK/valid/images/photo_37_jpg.rf.5798d28824521689e4e56326ce15f14a.jpg
