GarinLev/Theseus_Maze/Firmware-rpi/YOLOmazeMINSK/valid/images/photo_38_jpg.rf.67c268e312a70e2e9a9d1eaaa8585dbd.jpg

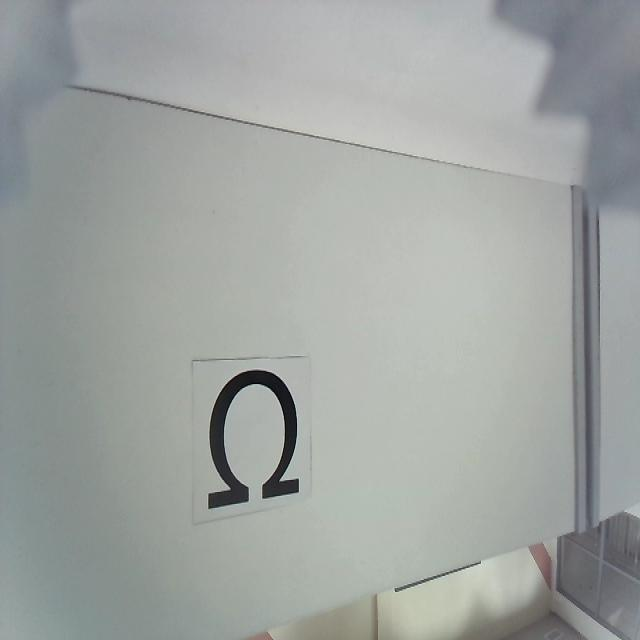
Firmware-rpi/YOLOmazeMINSK/valid/images/photo_38_jpg.rf.67c268e312a70e2e9a9d1eaaa8585dbd.jpg
