GarinLev/Theseus_Maze/Firmware-rpi/YOLOmazeMINSK/valid/images/photo_40_jpg.rf.25876b04db469f665f66d0922bac243a.jpg

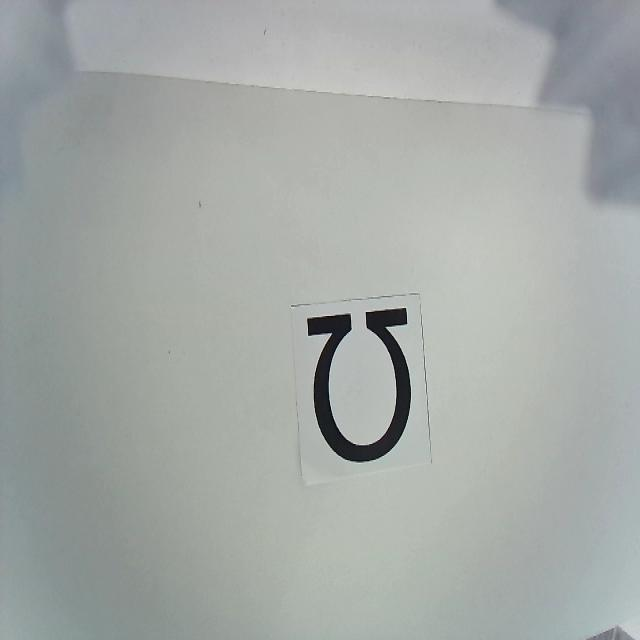
Firmware-rpi/YOLOmazeMINSK/valid/images/photo_40_jpg.rf.25876b04db469f665f66d0922bac243a.jpg
