GarinLev/Theseus_Maze/Firmware-rpi/YOLOmazeMINSK/valid/images/photo_61_jpg.rf.487324a0c7c61724d0280a7fe8aa8b09.jpg

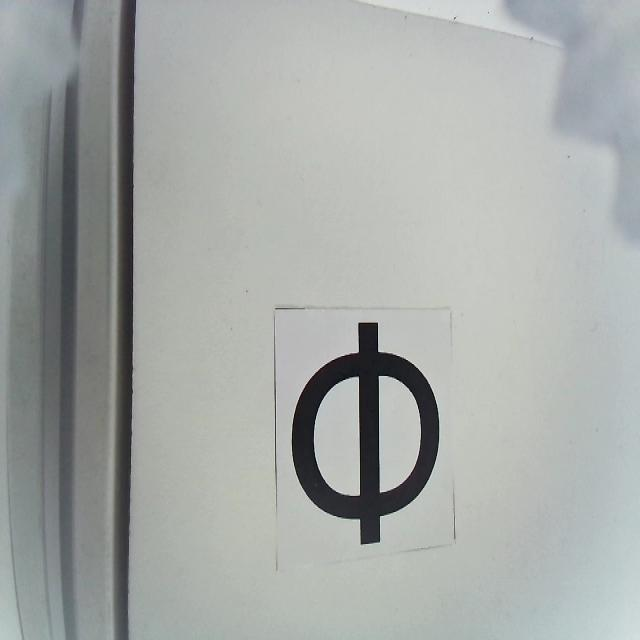
Firmware-rpi/YOLOmazeMINSK/valid/images/photo_61_jpg.rf.487324a0c7c61724d0280a7fe8aa8b09.jpg
