GarinLev/Theseus_Maze/Firmware-rpi/YOLOmazeMINSK/valid/images/photo_62_jpg.rf.d462a5341da273b37e98f73d5386eb85.jpg

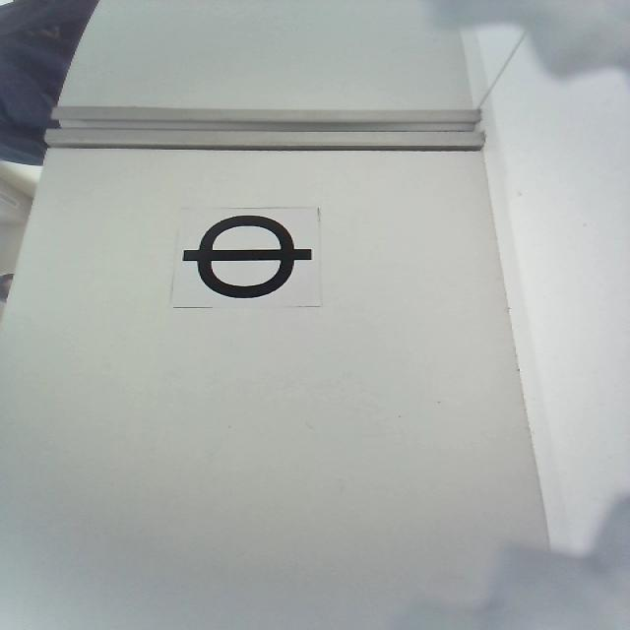
Firmware-rpi/YOLOmazeMINSK/valid/images/photo_62_jpg.rf.d462a5341da273b37e98f73d5386eb85.jpg
