GarinLev/Theseus_Maze/Firmware-rpi/YOLOmazeMINSK/valid/images/photoMINSK2_5_jpg.rf.4a511575336be120bc9023f43c1ee158.jpg

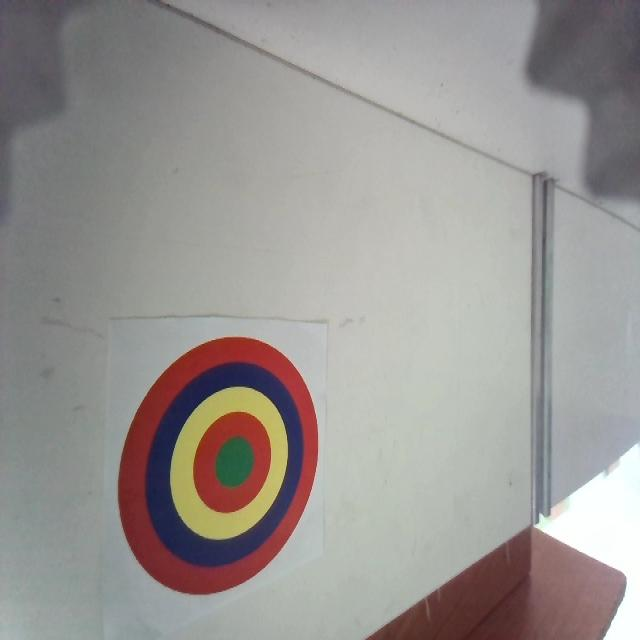
Firmware-rpi/YOLOmazeMINSK/valid/images/photoMINSK2_5_jpg.rf.4a511575336be120bc9023f43c1ee158.jpg
