GarinLev/Theseus_Maze/Firmware-rpi/YOLOmazeMINSK/valid/images/photoMINSK2_12_jpg.rf.efe4584688df54cb0ad6cdaab3504829.jpg

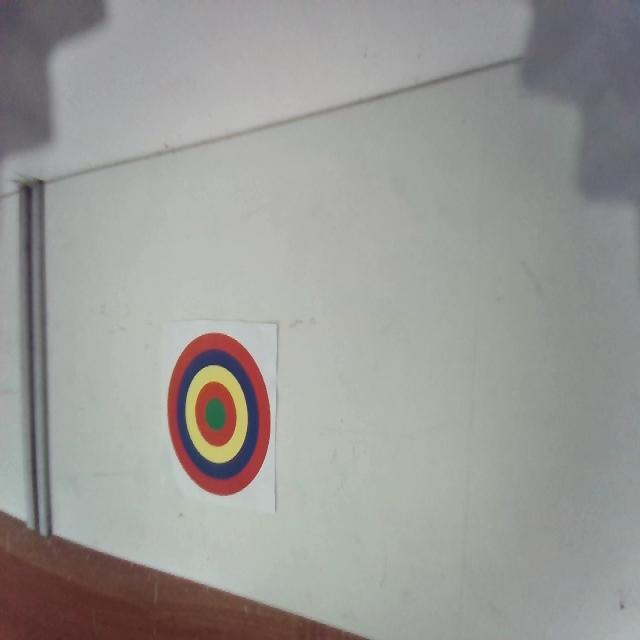
Firmware-rpi/YOLOmazeMINSK/valid/images/photoMINSK2_12_jpg.rf.efe4584688df54cb0ad6cdaab3504829.jpg
