GarinLev/Theseus_Maze/Firmware-rpi/YOLOmazeMINSK/valid/images/photoMINSK2_15_jpg.rf.d42b9faf1058bd21d5f9f15b459c619f.jpg

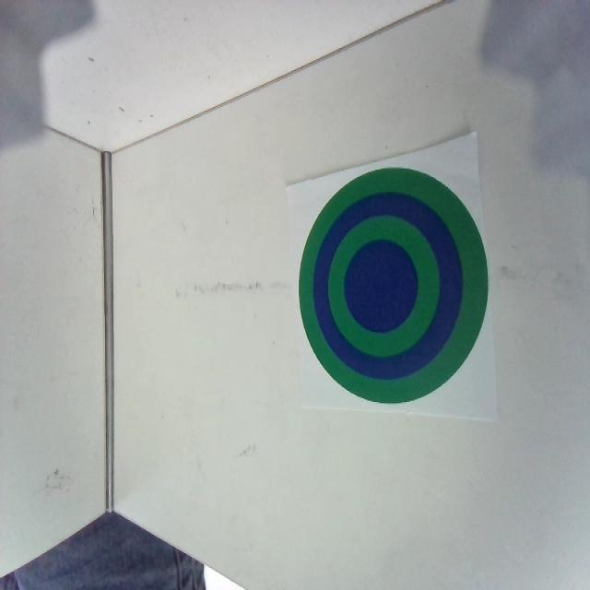
Firmware-rpi/YOLOmazeMINSK/valid/images/photoMINSK2_15_jpg.rf.d42b9faf1058bd21d5f9f15b459c619f.jpg
