GarinLev/Theseus_Maze/Firmware-rpi/YOLOmazeMINSK/valid/images/photoMINSK2_26_jpg.rf.cc9993a7ba5d3e5f2a16f9c1e9e3d562.jpg

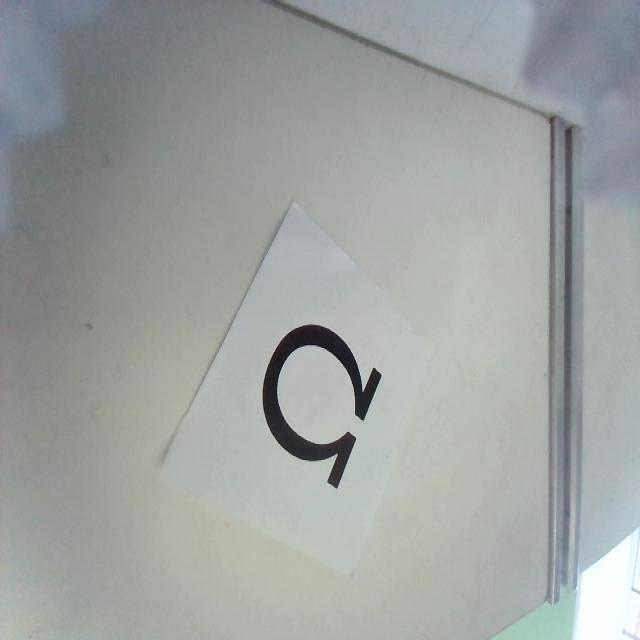
Firmware-rpi/YOLOmazeMINSK/valid/images/photoMINSK2_26_jpg.rf.cc9993a7ba5d3e5f2a16f9c1e9e3d562.jpg
