GarinLev/Theseus_Maze/Firmware-rpi/YOLOmazeMINSK/valid/images/photoMINSK2_27_jpg.rf.0e580a1d2a20129a8d5b7cf6493947de.jpg

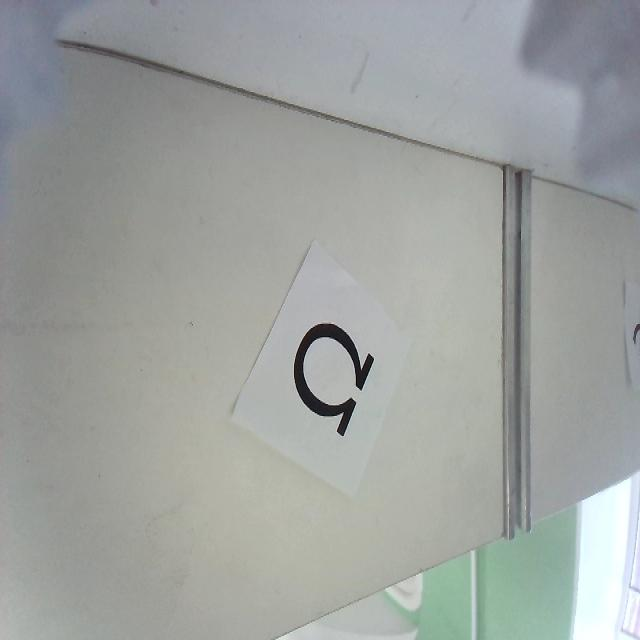
Firmware-rpi/YOLOmazeMINSK/valid/images/photoMINSK2_27_jpg.rf.0e580a1d2a20129a8d5b7cf6493947de.jpg
