GarinLev/Theseus_Maze/Firmware-rpi/YOLOmazeMINSK/valid/images/photoMINSK2_30_jpg.rf.99003f61a87ce4c41ef99937e16a8fad.jpg

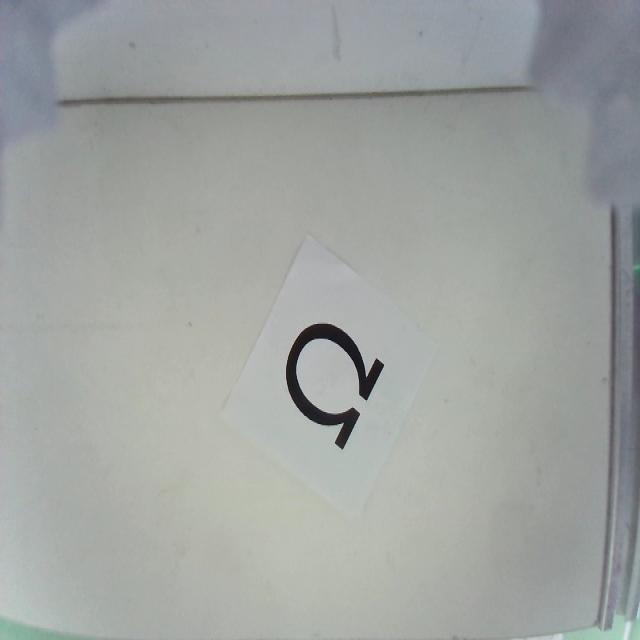
Firmware-rpi/YOLOmazeMINSK/valid/images/photoMINSK2_30_jpg.rf.99003f61a87ce4c41ef99937e16a8fad.jpg
