GarinLev/Theseus_Maze/Firmware-rpi/YOLOmazeMINSK/valid/images/photoMINSK2_31_jpg.rf.a6d30e84491521d2ec3d6eb6bf052d40.jpg

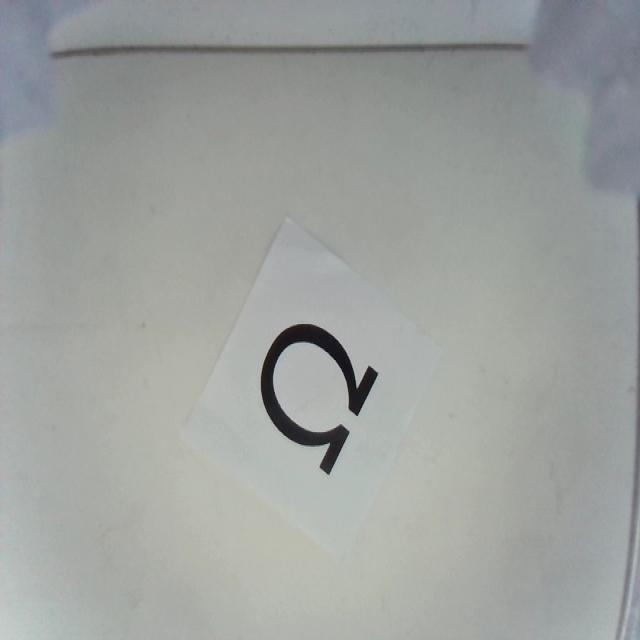
Firmware-rpi/YOLOmazeMINSK/valid/images/photoMINSK2_31_jpg.rf.a6d30e84491521d2ec3d6eb6bf052d40.jpg
