GarinLev/Theseus_Maze/Firmware-rpi/YOLOmazeMINSK/valid/images/photoMINSK2_37_jpg.rf.b4ade3511d52e05aaa85c309f136dddf.jpg

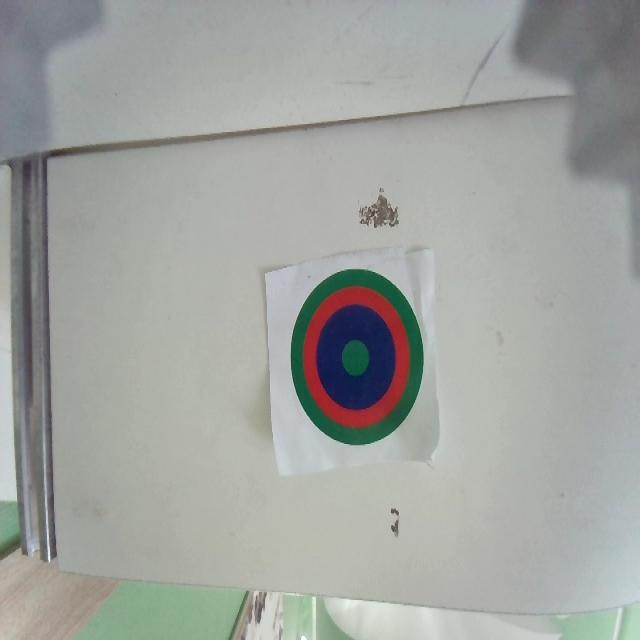
Firmware-rpi/YOLOmazeMINSK/valid/images/photoMINSK2_37_jpg.rf.b4ade3511d52e05aaa85c309f136dddf.jpg
