GarinLev/Theseus_Maze/Firmware-rpi/YOLOmazeMINSK/valid/images/photoMINSK2_38_jpg.rf.80a9453f03b5175e8d4036839f2ea041.jpg

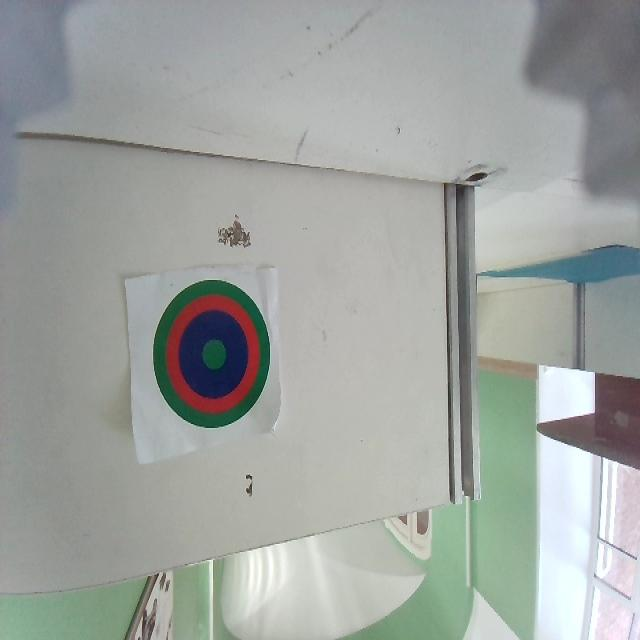
Firmware-rpi/YOLOmazeMINSK/valid/images/photoMINSK2_38_jpg.rf.80a9453f03b5175e8d4036839f2ea041.jpg
