GarinLev/Theseus_Maze/Firmware-rpi/YOLOmazeMINSK/valid/images/photoMINSK2_46_jpg.rf.0294ac9488a0058aa2098d76e95b3a7d.jpg

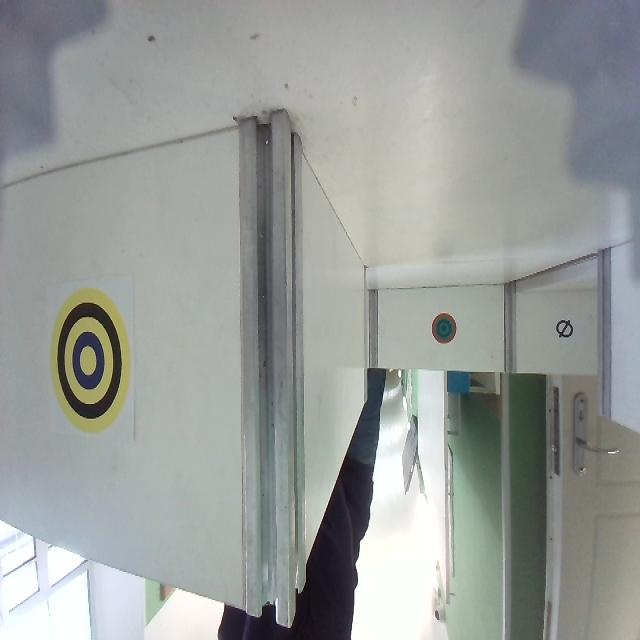
Firmware-rpi/YOLOmazeMINSK/valid/images/photoMINSK2_46_jpg.rf.0294ac9488a0058aa2098d76e95b3a7d.jpg
