GarinLev/Theseus_Maze/Firmware-rpi/YOLOmazeMINSK/valid/images/photoMINSK2_51_jpg.rf.8a704af45149b44f6c3d4ef1d8739a24.jpg

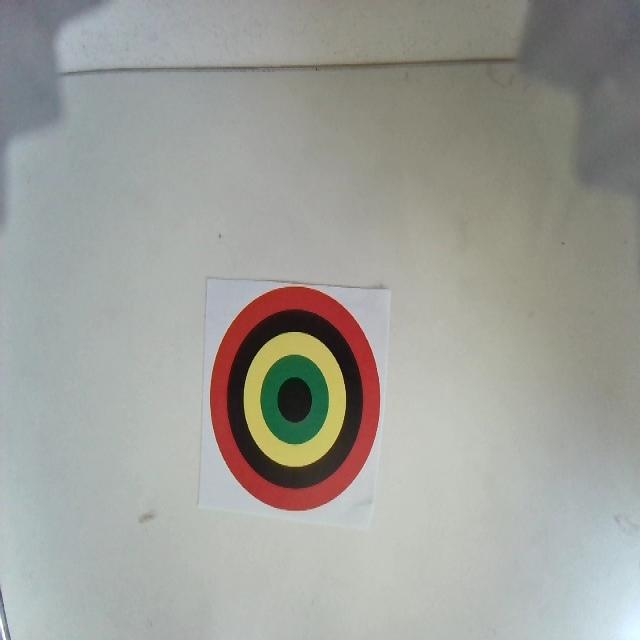
Firmware-rpi/YOLOmazeMINSK/valid/images/photoMINSK2_51_jpg.rf.8a704af45149b44f6c3d4ef1d8739a24.jpg
