GarinLev/Theseus_Maze/Firmware-rpi/YOLOmazeMINSK/valid/images/photoMINSK2_53_jpg.rf.cc4d5a47d890712f5352db3af01266a9.jpg

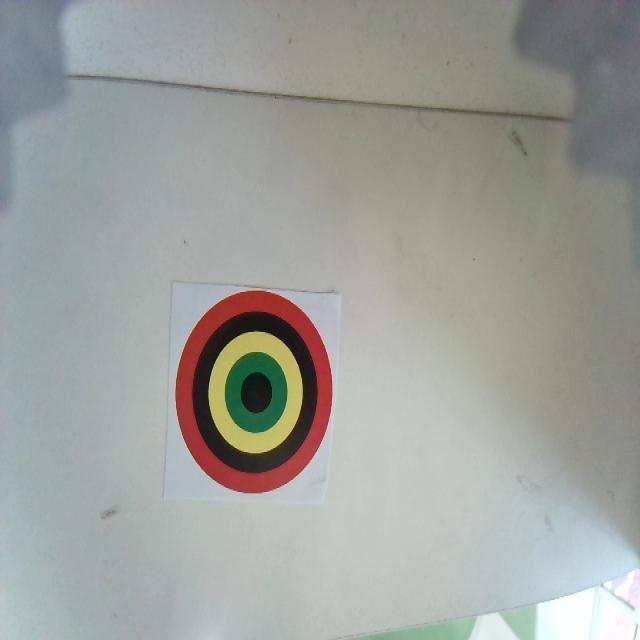
Firmware-rpi/YOLOmazeMINSK/valid/images/photoMINSK2_53_jpg.rf.cc4d5a47d890712f5352db3af01266a9.jpg
