GarinLev/Theseus_Maze/Firmware-rpi/YOLOmazeMINSK/valid/images/photoMINSK2_54_jpg.rf.8a47478e84906ed5f7ffff5e22637b66.jpg

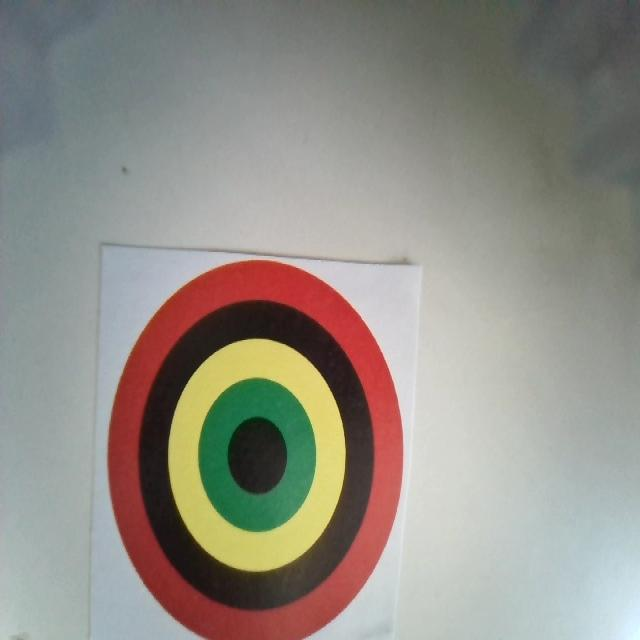
Firmware-rpi/YOLOmazeMINSK/valid/images/photoMINSK2_54_jpg.rf.8a47478e84906ed5f7ffff5e22637b66.jpg
