GarinLev/Theseus_Maze/Firmware-rpi/YOLOmazeMINSK/valid/images/photoMINSK2_55_jpg.rf.678ec17e172034af236bb6c6d4ef7e52.jpg

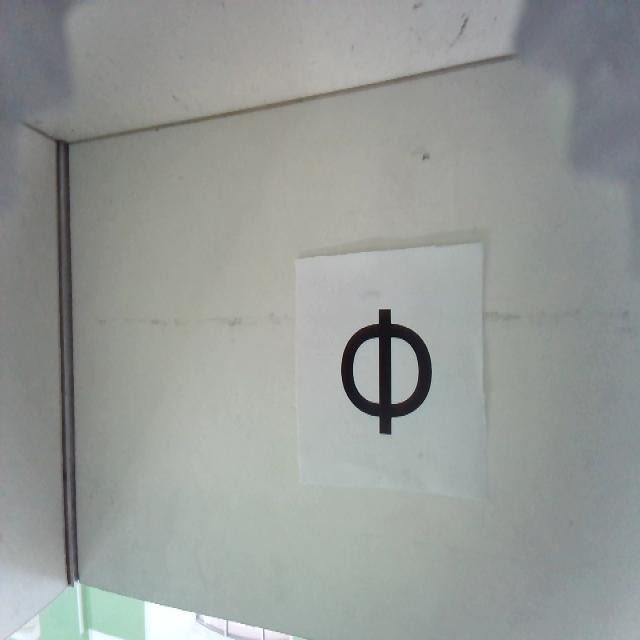
Firmware-rpi/YOLOmazeMINSK/valid/images/photoMINSK2_55_jpg.rf.678ec17e172034af236bb6c6d4ef7e52.jpg
