GarinLev/Theseus_Maze/Firmware-rpi/YOLOmazeMINSK/valid/images/photoMINSK2_62_jpg.rf.456ec9394c07e1a890b8ddb0d6903132.jpg

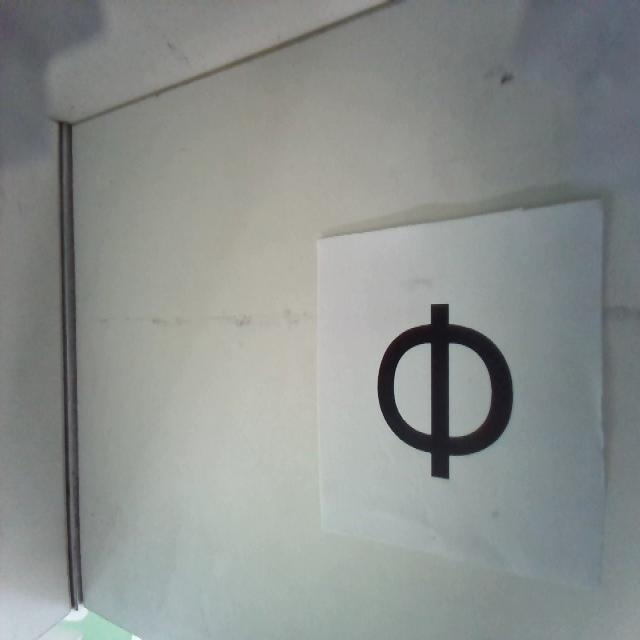
Firmware-rpi/YOLOmazeMINSK/valid/images/photoMINSK2_62_jpg.rf.456ec9394c07e1a890b8ddb0d6903132.jpg
