GarinLev/Theseus_Maze/Firmware-rpi/YOLOmazeMINSK/valid/images/photoMINSK2_63_jpg.rf.afff28997798a237790503194c3b092e.jpg

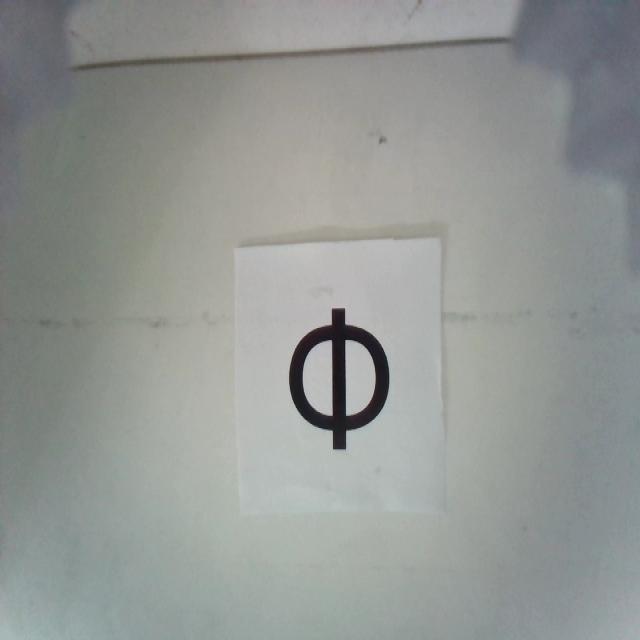
Firmware-rpi/YOLOmazeMINSK/valid/images/photoMINSK2_63_jpg.rf.afff28997798a237790503194c3b092e.jpg
