GarinLev/Theseus_Maze/Firmware-rpi/YOLOmazeMINSK/valid/images/photoMINSK2_68_jpg.rf.37a3e3d709dc23b38774b21ce3e10a8a.jpg

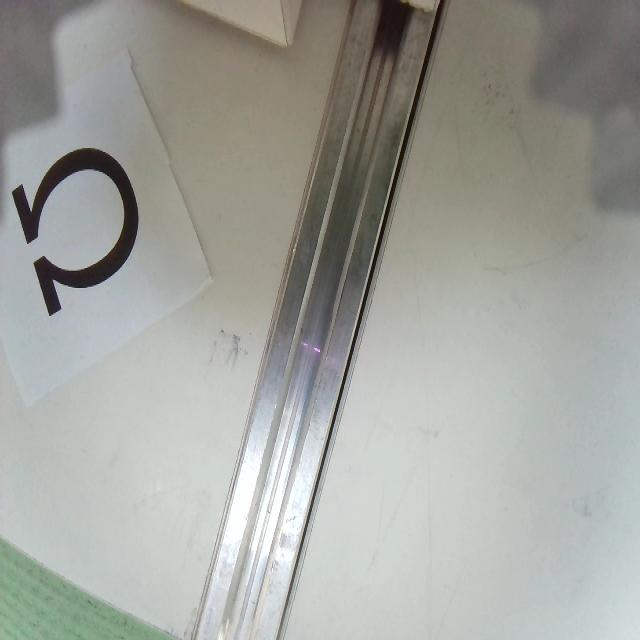
Firmware-rpi/YOLOmazeMINSK/valid/images/photoMINSK2_68_jpg.rf.37a3e3d709dc23b38774b21ce3e10a8a.jpg
