GarinLev/Theseus_Maze/Firmware-rpi/YOLOmazeMINSK/valid/images/photoMINSK2_75_jpg.rf.e108ee82954fab8af8aeb1d7ce43c519.jpg

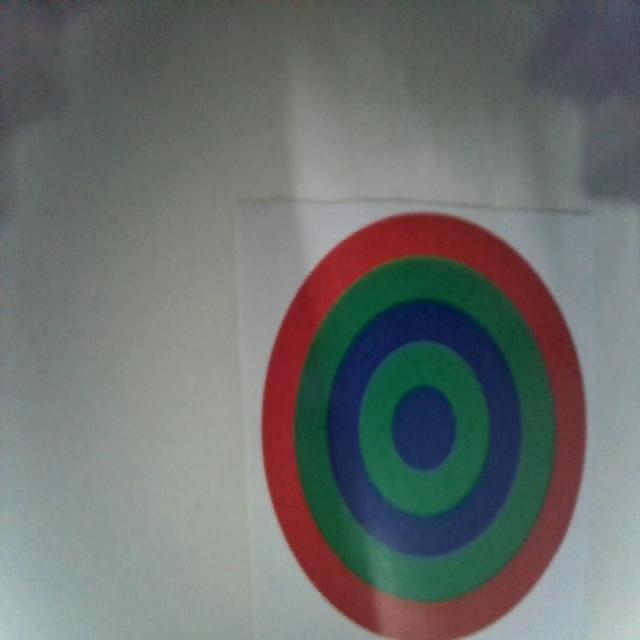
Firmware-rpi/YOLOmazeMINSK/valid/images/photoMINSK2_75_jpg.rf.e108ee82954fab8af8aeb1d7ce43c519.jpg
