GarinLev/Theseus_Maze/Firmware-rpi/YOLOmazeMINSK/valid/images/photoMINSK2_78_jpg.rf.3e6fe46e6d06496c87064faf77eb001b.jpg

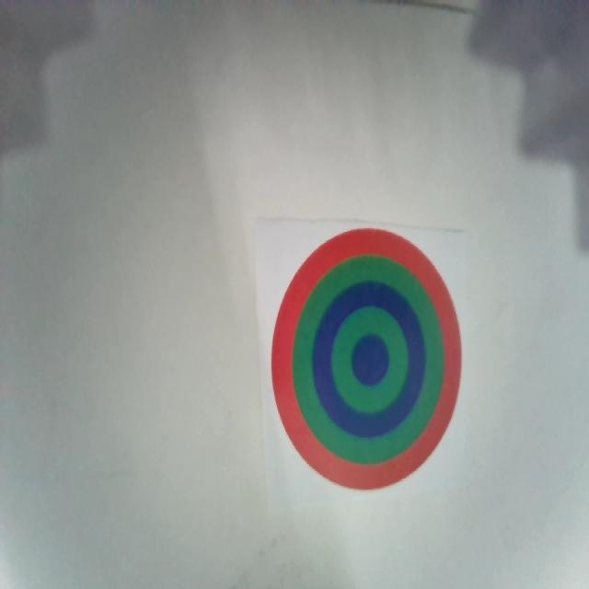
Firmware-rpi/YOLOmazeMINSK/valid/images/photoMINSK2_78_jpg.rf.3e6fe46e6d06496c87064faf77eb001b.jpg
