GarinLev/Theseus_Maze/Firmware-rpi/YOLOmazeMINSK/valid/images/photoMINSK2_82_jpg.rf.dd16101429efe3082e4965ed4460c984.jpg

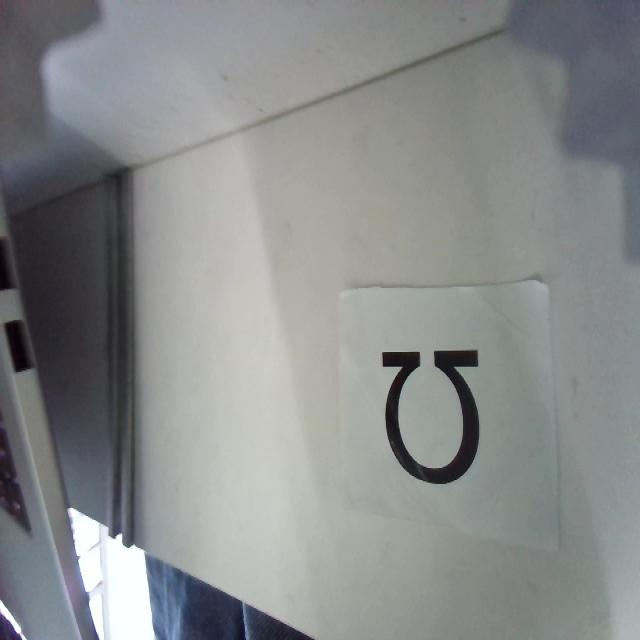
Firmware-rpi/YOLOmazeMINSK/valid/images/photoMINSK2_82_jpg.rf.dd16101429efe3082e4965ed4460c984.jpg
