GarinLev/Theseus_Maze/Firmware-rpi/YOLOmazeMINSK/valid/images/photoMINSK2_86_jpg.rf.111eed295dc2c602d78ea66ad3e234cb.jpg

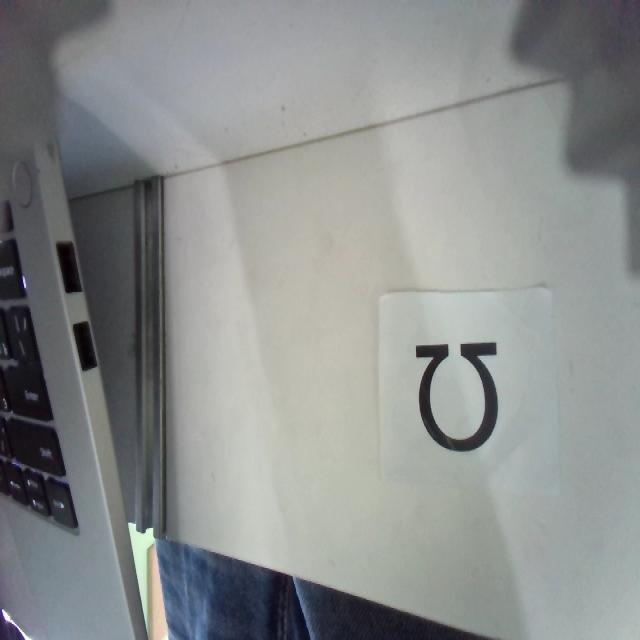
Firmware-rpi/YOLOmazeMINSK/valid/images/photoMINSK2_86_jpg.rf.111eed295dc2c602d78ea66ad3e234cb.jpg
