GarinLev/Theseus_Maze/Firmware-rpi/YOLOmazeMINSK/valid/images/photoMINSK2_87_jpg.rf.7c86371987d8f93c7c13b791fbec12de.jpg

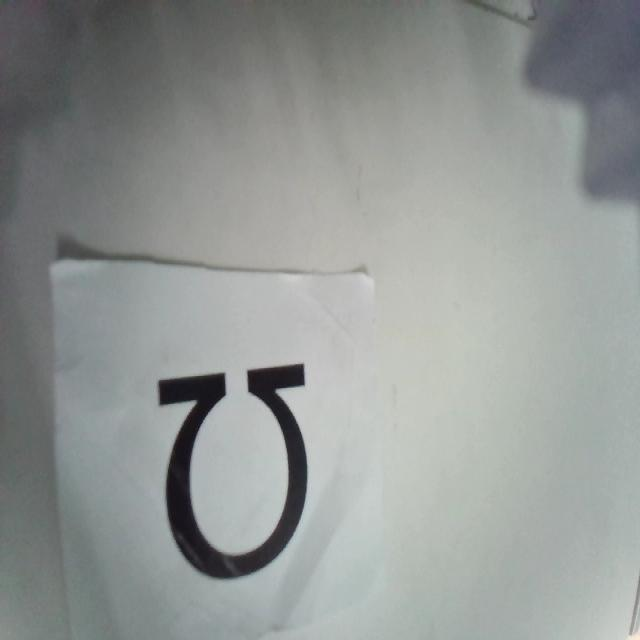
Firmware-rpi/YOLOmazeMINSK/valid/images/photoMINSK2_87_jpg.rf.7c86371987d8f93c7c13b791fbec12de.jpg
