GarinLev/Theseus_Maze/Firmware-rpi/YOLOmazeMINSK/valid/images/photoMINSK2_98_jpg.rf.7f2b0349d7dab642f452c48bc2879376.jpg

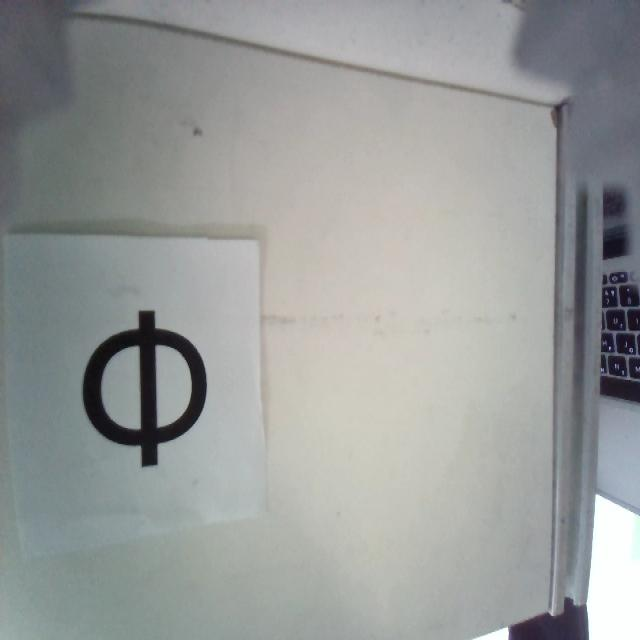
Firmware-rpi/YOLOmazeMINSK/valid/images/photoMINSK2_98_jpg.rf.7f2b0349d7dab642f452c48bc2879376.jpg
