GarinLev/Theseus_Maze/Firmware-rpi/YOLOmazeMINSK/valid/images/photoMINSK2_100_jpg.rf.0f657611c0018f76765ca6e00f5f083e.jpg

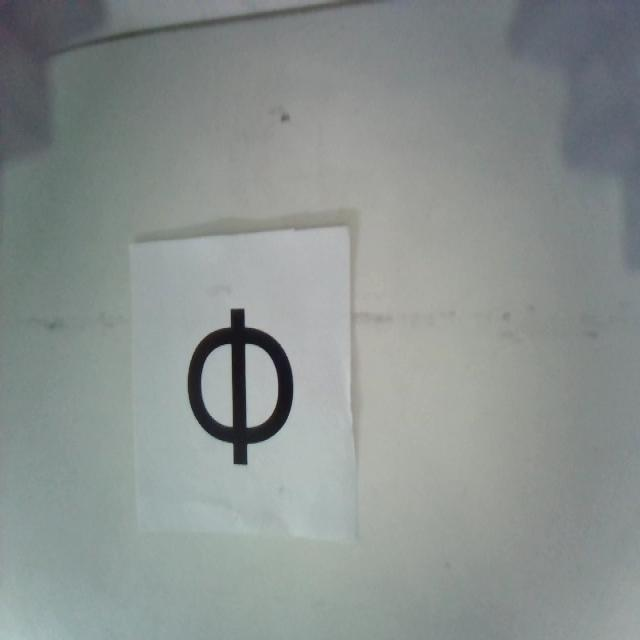
Firmware-rpi/YOLOmazeMINSK/valid/images/photoMINSK2_100_jpg.rf.0f657611c0018f76765ca6e00f5f083e.jpg
