GarinLev/Theseus_Maze/Firmware-rpi/YOLOmazeMINSK/valid/images/photoMINSK2_104_jpg.rf.4a3faae0ef65a12e60af3f23882c47c8.jpg

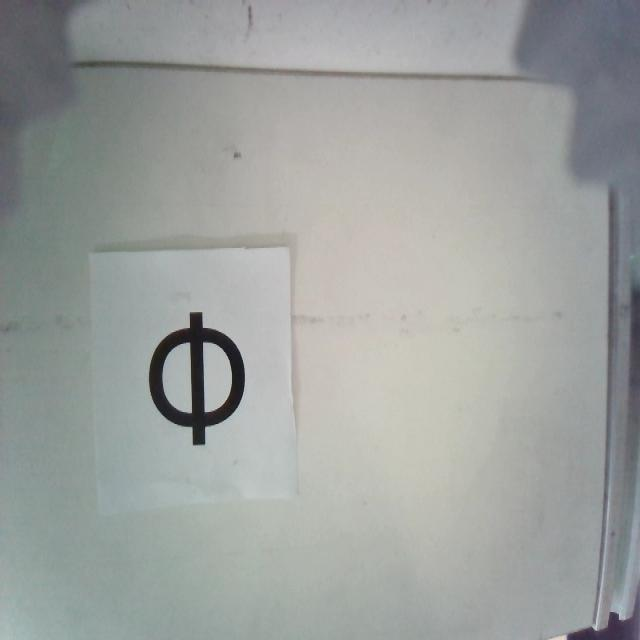
Firmware-rpi/YOLOmazeMINSK/valid/images/photoMINSK2_104_jpg.rf.4a3faae0ef65a12e60af3f23882c47c8.jpg
