GarinLev/Theseus_Maze/Firmware-rpi/YOLOmazeMINSK/valid/images/photoMINSK2_105_jpg.rf.152a6a9f0cc76e5a695fc62cc2528568.jpg

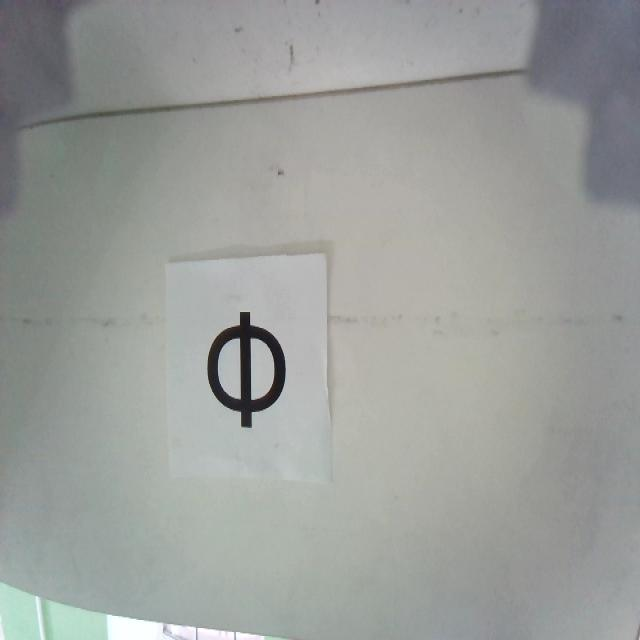
Firmware-rpi/YOLOmazeMINSK/valid/images/photoMINSK2_105_jpg.rf.152a6a9f0cc76e5a695fc62cc2528568.jpg
