GarinLev/Theseus_Maze/Firmware-rpi/YOLOmazeMINSK/valid/images/photoMINSK2_111_jpg.rf.25fc278a134a493b73af98bcb5b8874f.jpg

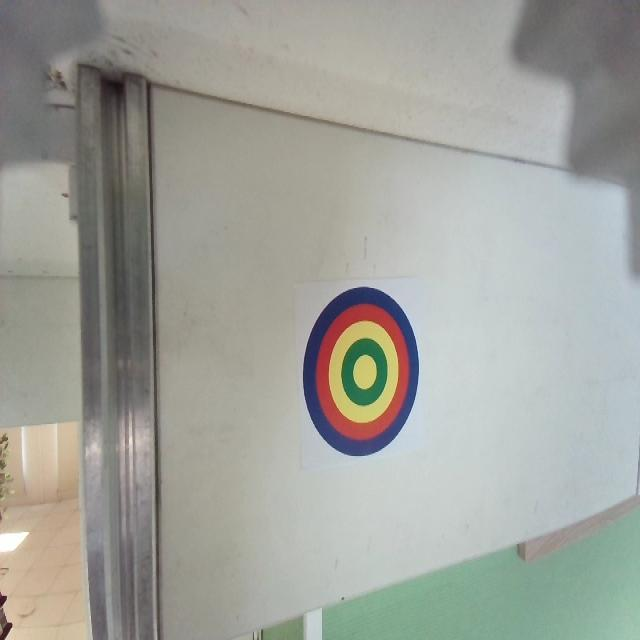
Firmware-rpi/YOLOmazeMINSK/valid/images/photoMINSK2_111_jpg.rf.25fc278a134a493b73af98bcb5b8874f.jpg
