GarinLev/Theseus_Maze/Firmware-rpi/YOLOmazeMINSK/valid/images/photoMINSK3_3_jpg.rf.23b34c83fc833d607e6f967694700da1.jpg

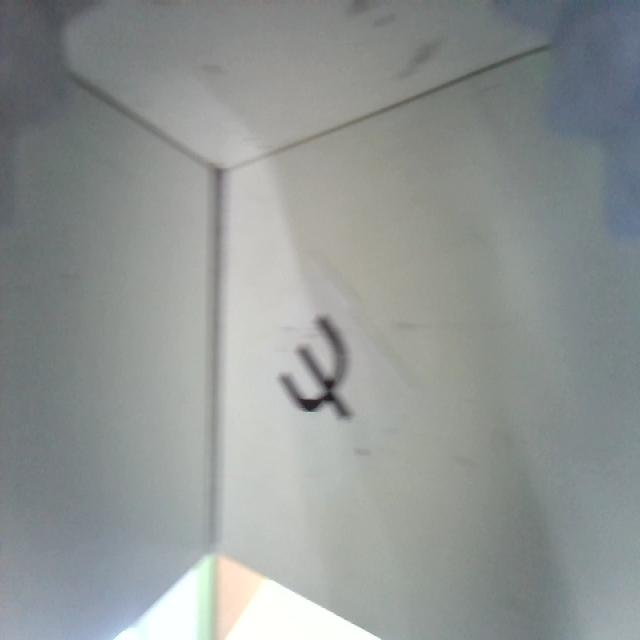
Firmware-rpi/YOLOmazeMINSK/valid/images/photoMINSK3_3_jpg.rf.23b34c83fc833d607e6f967694700da1.jpg
