GarinLev/Theseus_Maze/Firmware-rpi/YOLOmazeMINSK/valid/images/photoMINSK3_6_jpg.rf.8d953e8399ce5eb61860e40254fbb0f4.jpg

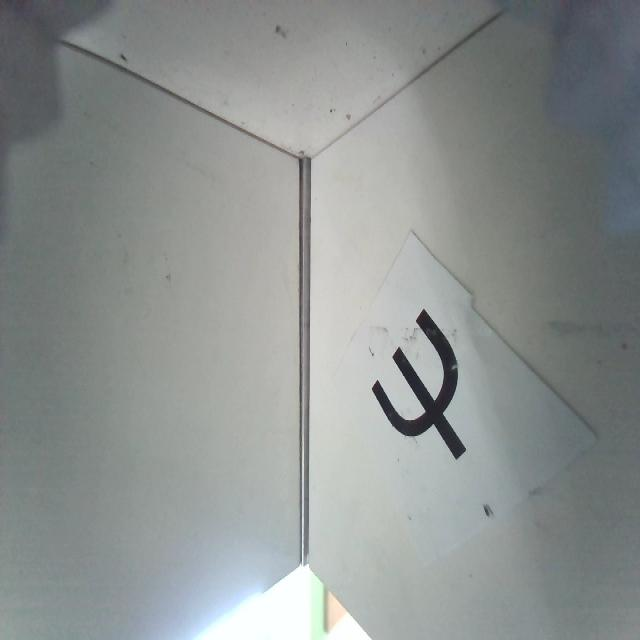
Firmware-rpi/YOLOmazeMINSK/valid/images/photoMINSK3_6_jpg.rf.8d953e8399ce5eb61860e40254fbb0f4.jpg
