GarinLev/Theseus_Maze/Firmware-rpi/YOLOmazeMINSK/valid/images/photoMINSK3_18_jpg.rf.bda7c57aa7ec064dd98ad28d8d279a3a.jpg

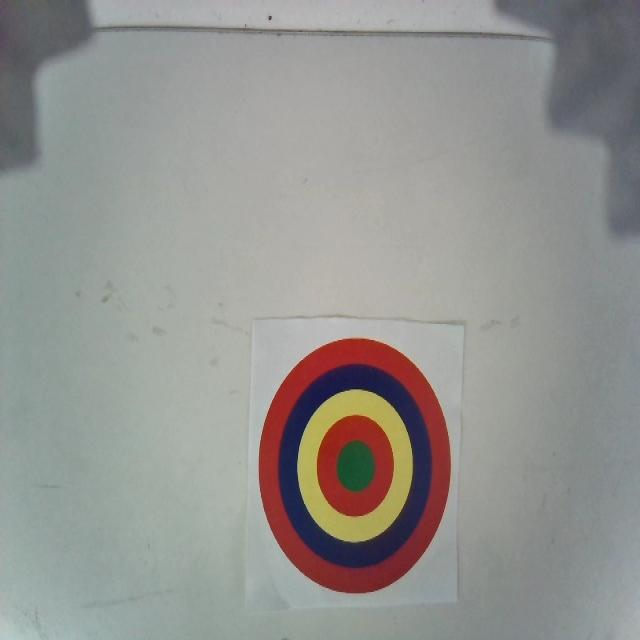
Firmware-rpi/YOLOmazeMINSK/valid/images/photoMINSK3_18_jpg.rf.bda7c57aa7ec064dd98ad28d8d279a3a.jpg
