GarinLev/Theseus_Maze/Firmware-rpi/YOLOmazeMINSK/valid/images/photoMINSK3_20_jpg.rf.9577efbc3d24d0dc7c0da9218b72fe08.jpg

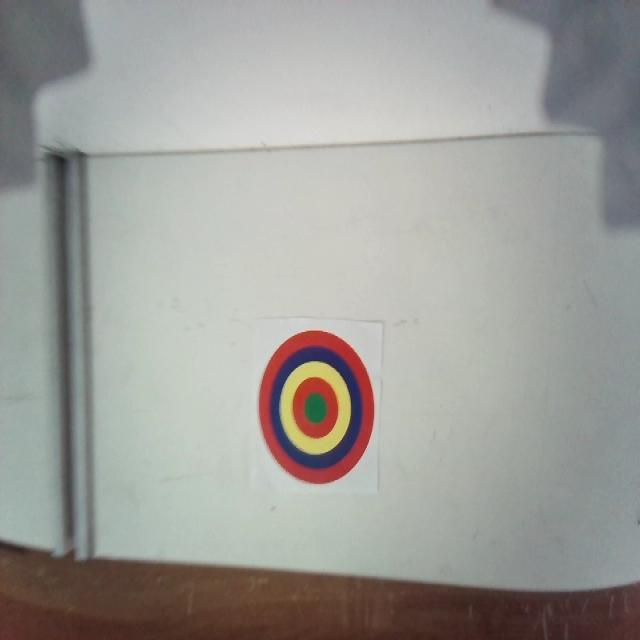
Firmware-rpi/YOLOmazeMINSK/valid/images/photoMINSK3_20_jpg.rf.9577efbc3d24d0dc7c0da9218b72fe08.jpg
