GarinLev/Theseus_Maze/Firmware-rpi/YOLOmazeMINSK/valid/images/photoMINSK3_30_jpg.rf.e8e5365984523114038a2991e35f4c4b.jpg

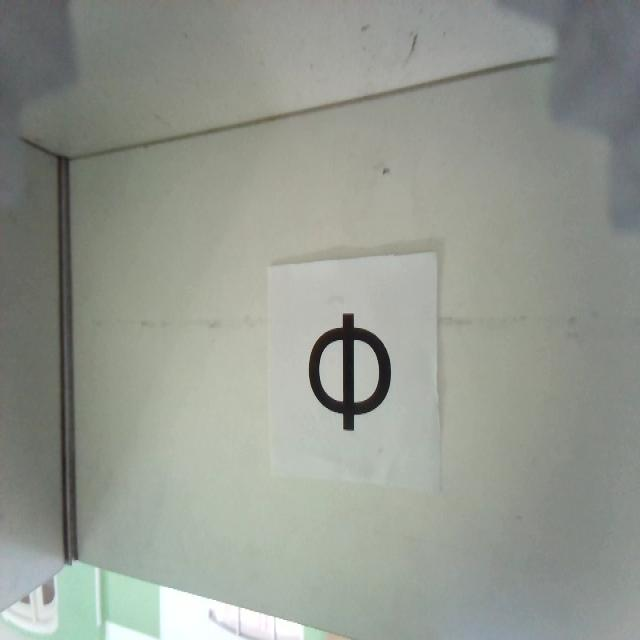
Firmware-rpi/YOLOmazeMINSK/valid/images/photoMINSK3_30_jpg.rf.e8e5365984523114038a2991e35f4c4b.jpg
