GarinLev/Theseus_Maze/Firmware-rpi/YOLOmazeMINSK/valid/images/photoMINSK3_39_jpg.rf.1273a2fc33e390ca8e198b3c6cd52333.jpg

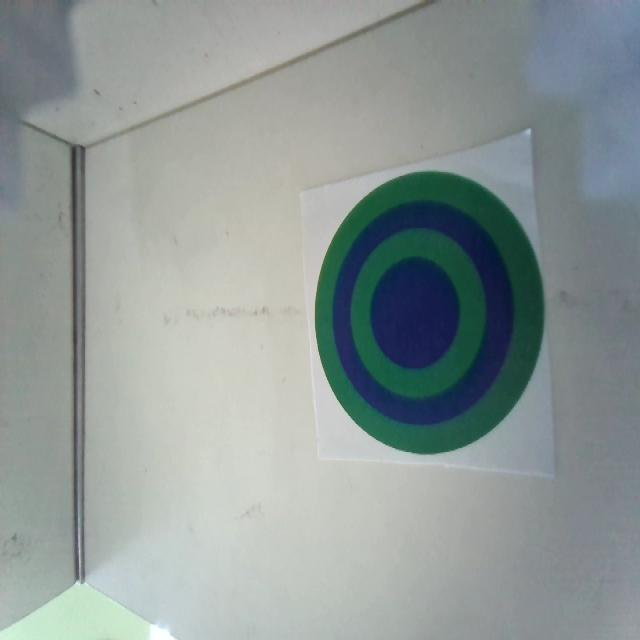
Firmware-rpi/YOLOmazeMINSK/valid/images/photoMINSK3_39_jpg.rf.1273a2fc33e390ca8e198b3c6cd52333.jpg
