GarinLev/Theseus_Maze/Firmware-rpi/YOLOmazeMINSK/valid/images/photoMINSK3_44_jpg.rf.da30c14404f3e295719c80ec66f533f4.jpg

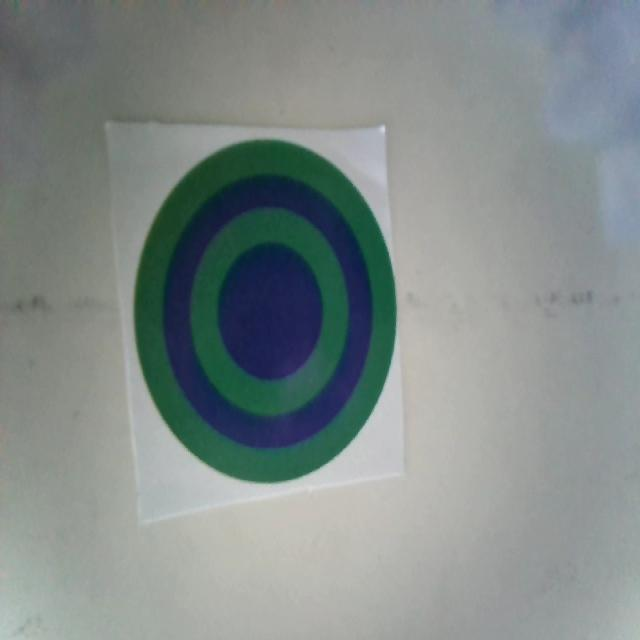
Firmware-rpi/YOLOmazeMINSK/valid/images/photoMINSK3_44_jpg.rf.da30c14404f3e295719c80ec66f533f4.jpg
