GarinLev/Theseus_Maze/Firmware-rpi/YOLOmazeMINSK/valid/images/photoMINSK3_45_jpg.rf.44ac9406e7e2b9bd387f960e62e99cde.jpg

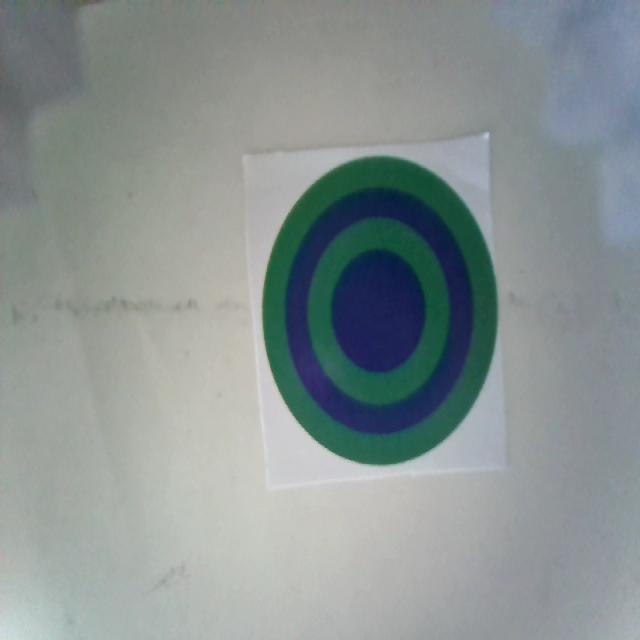
Firmware-rpi/YOLOmazeMINSK/valid/images/photoMINSK3_45_jpg.rf.44ac9406e7e2b9bd387f960e62e99cde.jpg
