GarinLev/Theseus_Maze/Firmware-rpi/YOLOmazeMINSK/valid/images/photoMINSK3_53_jpg.rf.df85f3115e9a4abca16a37bfa215da6f.jpg

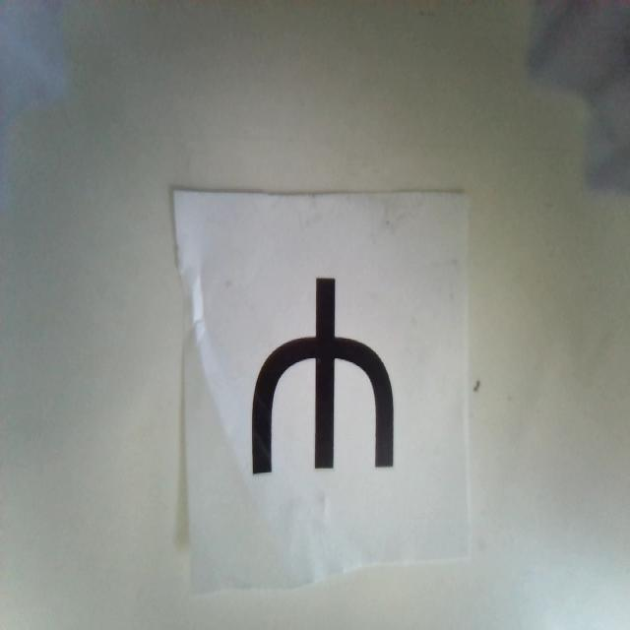
Firmware-rpi/YOLOmazeMINSK/valid/images/photoMINSK3_53_jpg.rf.df85f3115e9a4abca16a37bfa215da6f.jpg
