GarinLev/Theseus_Maze/Firmware-rpi/YOLOmazeMINSK/valid/images/photoMINSK3_64_jpg.rf.f52f47910738a0a51ecd78737645d9ec.jpg

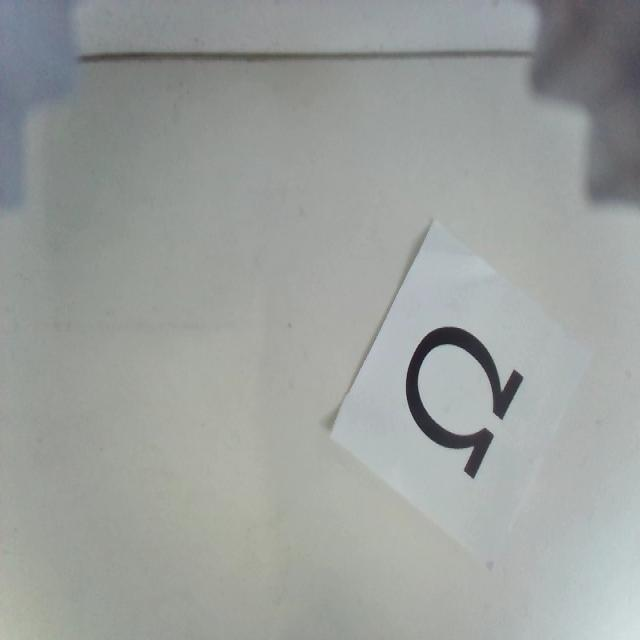
Firmware-rpi/YOLOmazeMINSK/valid/images/photoMINSK3_64_jpg.rf.f52f47910738a0a51ecd78737645d9ec.jpg
