GarinLev/Theseus_Maze/Firmware-rpi/YOLOmazeMINSK/valid/images/photoMINSK_5_jpg.rf.8a737fc474deda56a142e822bfc8a153.jpg

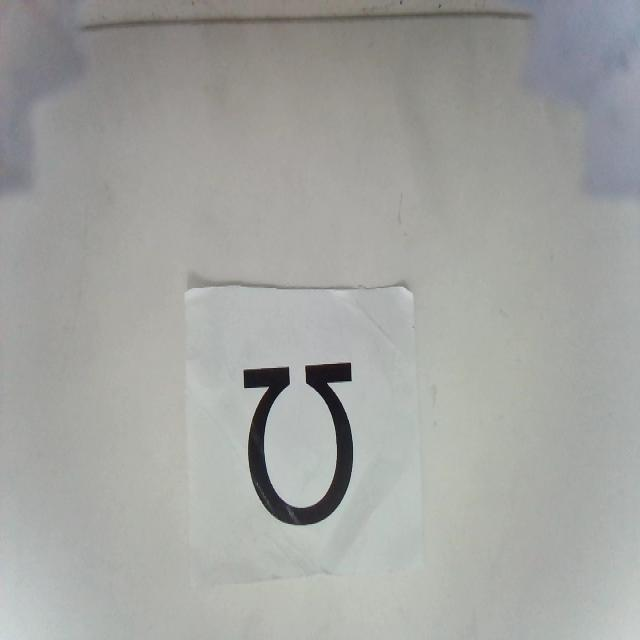
Firmware-rpi/YOLOmazeMINSK/valid/images/photoMINSK_5_jpg.rf.8a737fc474deda56a142e822bfc8a153.jpg
