GarinLev/Theseus_Maze/Firmware-rpi/YOLOmazeMINSK/valid/images/photoMINSK_6_jpg.rf.30c4309eac32e43f101f57a4273a8da0.jpg

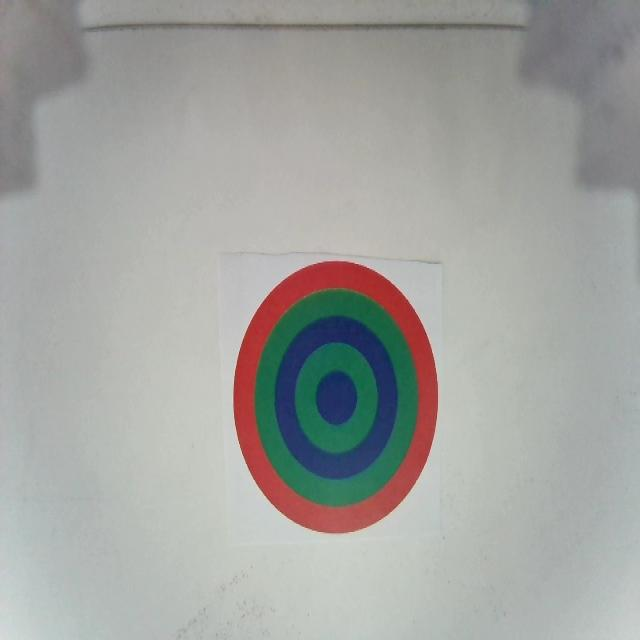
Firmware-rpi/YOLOmazeMINSK/valid/images/photoMINSK_6_jpg.rf.30c4309eac32e43f101f57a4273a8da0.jpg
