GarinLev/Theseus_Maze/construction/prototip/крепл_ЛД.stl

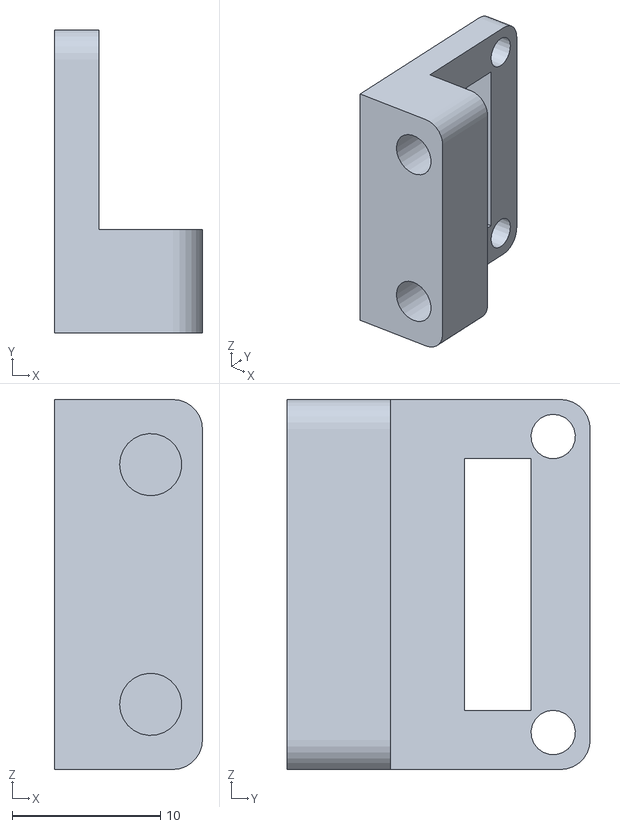
[picture p139: CAD file, 2026-09-08]
construction/prototip/крепл_ЛД.stl
10.0 x 20.5 x 25.0
