GarinLev/Theseus_Maze/construction/version1/3D/Tumbler MT1.stp

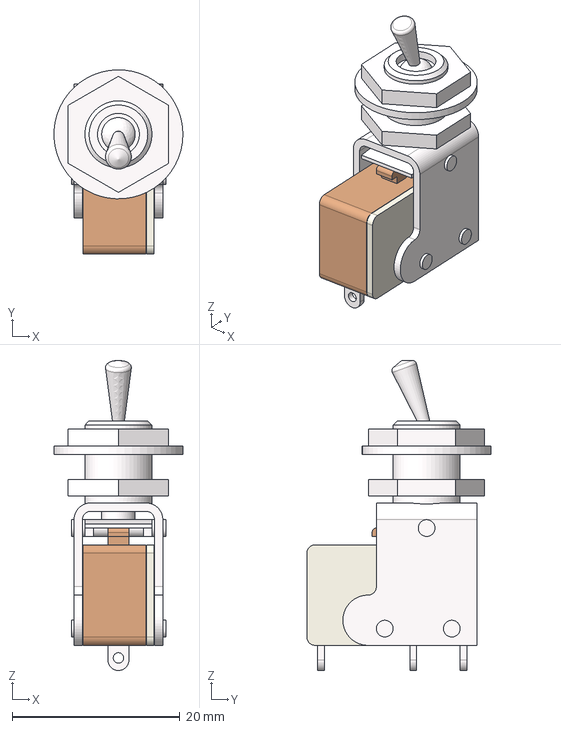
[picture p140: CAD file, 2026-09-08]
construction/version1/3D/Tumbler MT1.stp
15.4 x 22.0 x 37.0 mm
shayba&gayka
Tumbler MT1 OYUO.360.016 TU_1
