GarinLev/Theseus_Maze/construction/prototip/крепёж_для_мотора.step

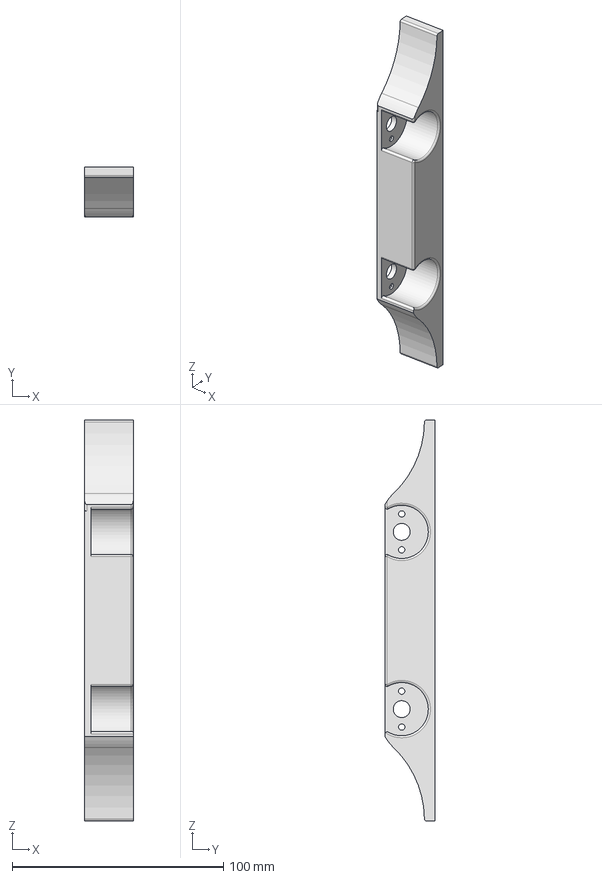
[picture p142: CAD file, 2026-09-08]
construction/prototip/крепёж_для_мотора.step
23.0 x 23.7 x 190.0 mm
