GarinLev/Theseus_Maze/construction/version1/3D/OLED 128 x 64 Display 0.96 Inch.step

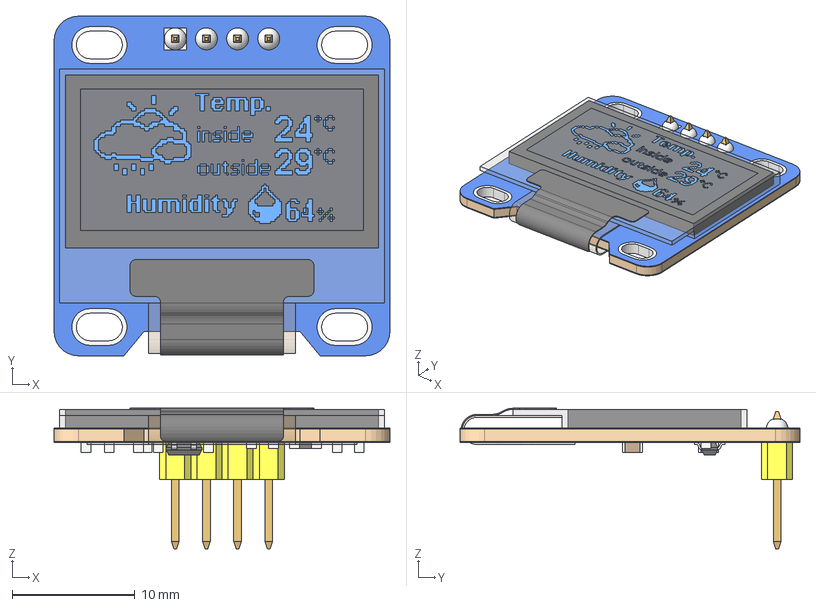
[picture p143: CAD file, 2026-09-08]
construction/version1/3D/OLED 128 x 64 Display 0.96 Inch.step
27.4 x 27.7 x 11.5 mm
