GarinLev/Theseus_Maze/construction/version1/stl/front_part_2_new.stl

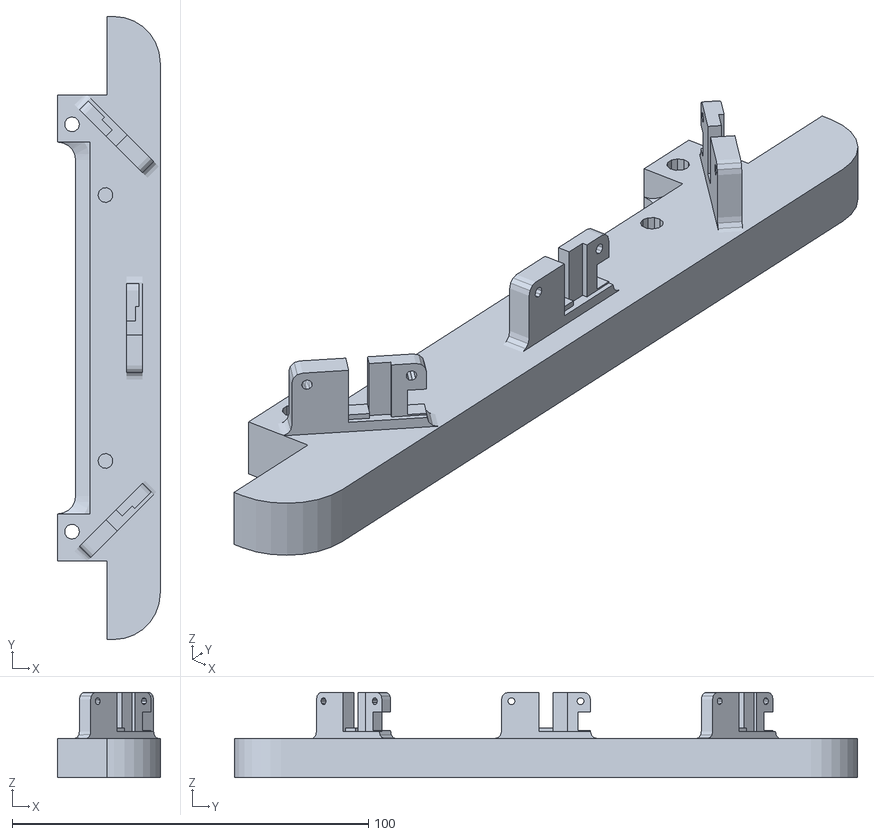
[picture p144: CAD file, 2026-09-08]
construction/version1/stl/front_part_2_new.stl
28.8 x 175.0 x 24.0
