GarinLev/Theseus_Maze/construction/prototip/стойки для драйверов.stl

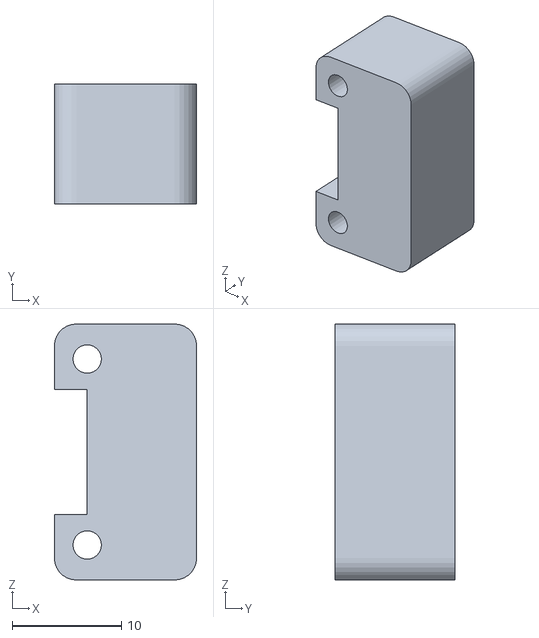
[picture p145: CAD file, 2026-09-08]
construction/prototip/стойки для драйверов.stl
13.0 x 11.0 x 23.4
