GarinLev/Theseus_Maze/construction/version1/3D/fast_akkum.stl

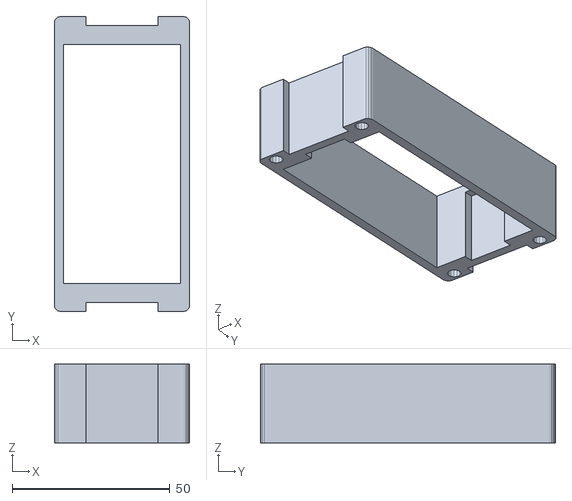
[picture p146: CAD file, 2026-09-08]
construction/version1/3D/fast_akkum.stl
42.9 x 93.4 x 25.0
