GarinLev/Theseus_Maze/construction/version1/stl/cube.stl

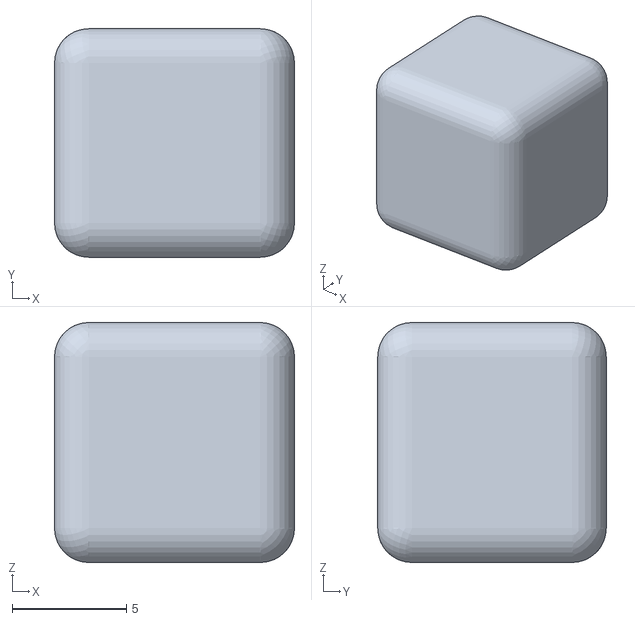
[picture p147: CAD file, 2026-09-08]
construction/version1/stl/cube.stl
10.5 x 10.0 x 10.5
