GarinLev/Theseus_Maze/construction/prototip/крепление_RGB.stl

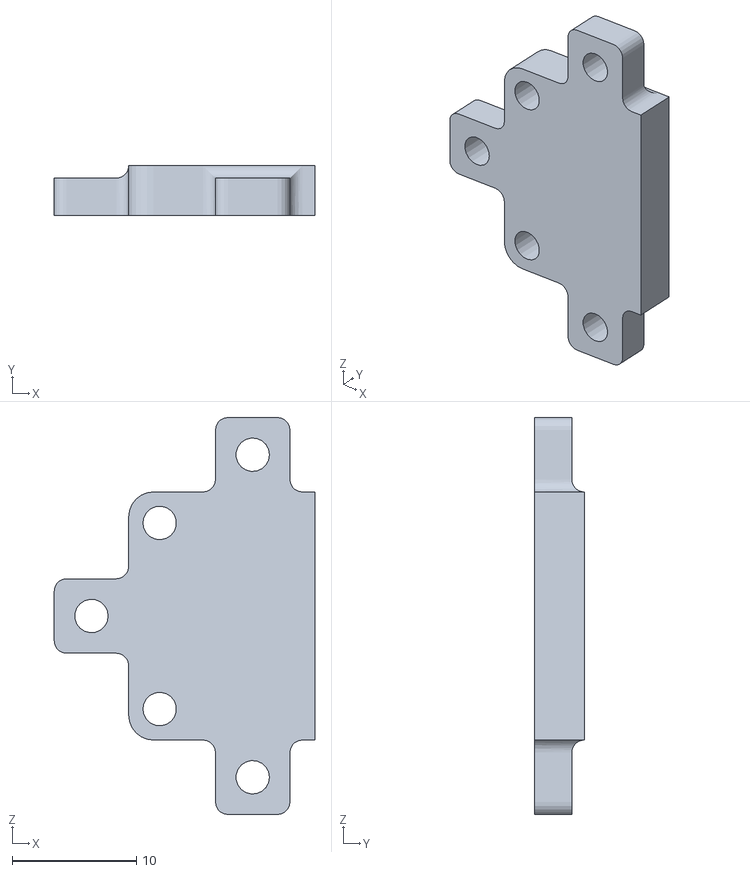
[picture p148: CAD file, 2026-09-08]
construction/prototip/крепление_RGB.stl
21.0 x 4.00 x 32.0
