GarinLev/Theseus_Maze/construction/version1/3D/SSD1327.SLDPRT

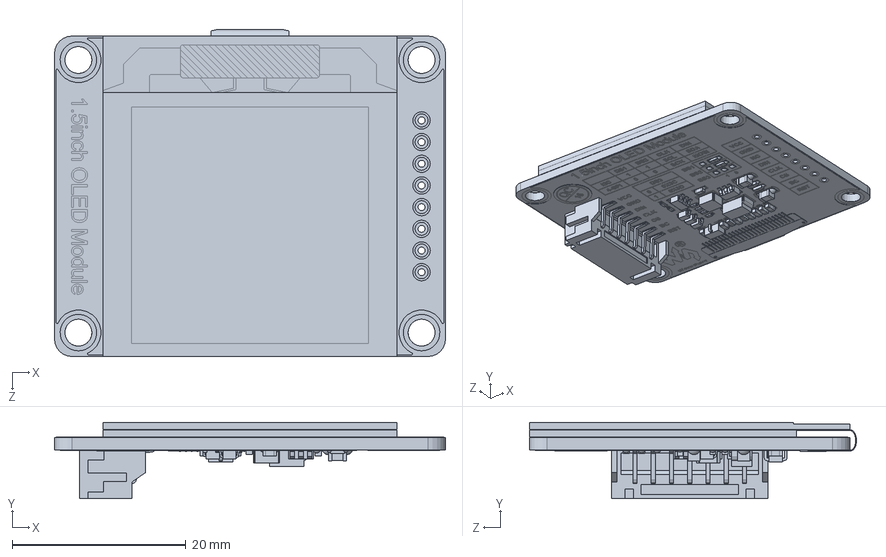
[picture p149: CAD file, 2026-09-08]
construction/version1/3D/SSD1327.SLDPRT
45.0 x 8.78 x 37.6 mm
