GarinLev/Theseus_Maze/construction/version1/stl/back_part_new_ds_butt.stl

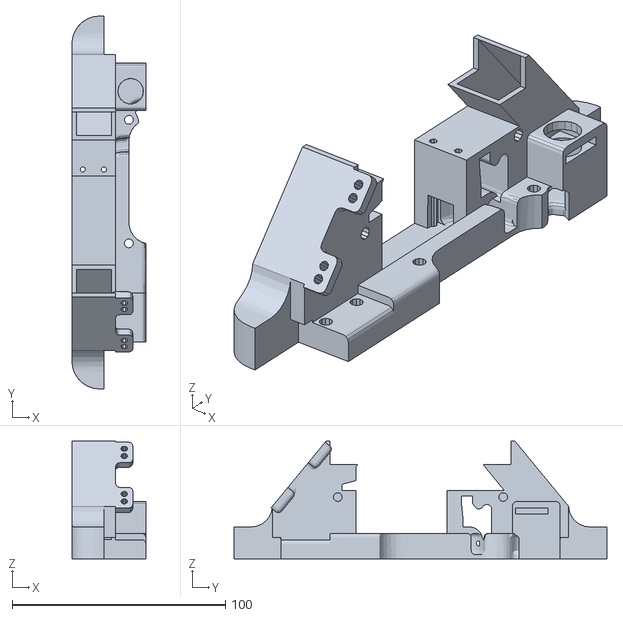
[picture p150: CAD file, 2026-09-08]
construction/version1/stl/back_part_new_ds_butt.stl
34.7 x 175.0 x 55.3
