GarinLev/Theseus_Maze/construction/prototip/крепёж_мотора_2.stl

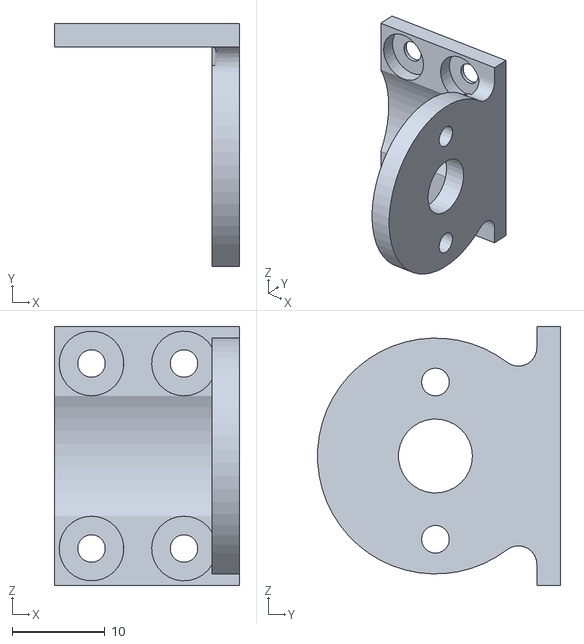
[picture p151: CAD file, 2026-09-08]
construction/prototip/крепёж_мотора_2.stl
20.0 x 26.2 x 28.0
