GarinLev/Theseus_Maze/construction/version1/3D/camera.STEP

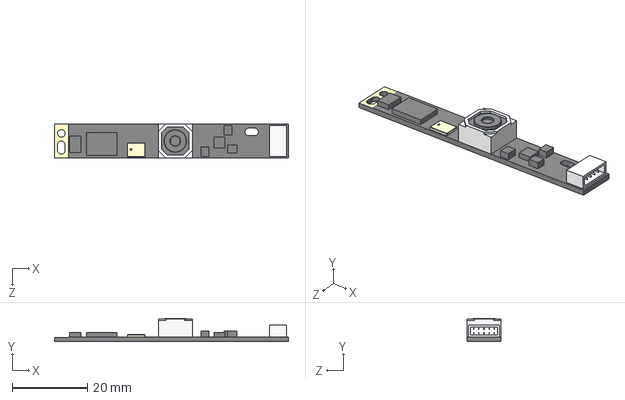
[picture p152: CAD file, 2026-03-02]
construction/version1/3D/camera.STEP
62.0 x 6.15 x 9.00 mm
