GarinLev/Theseus_Maze/construction/version1/stl/left_akkum.stl

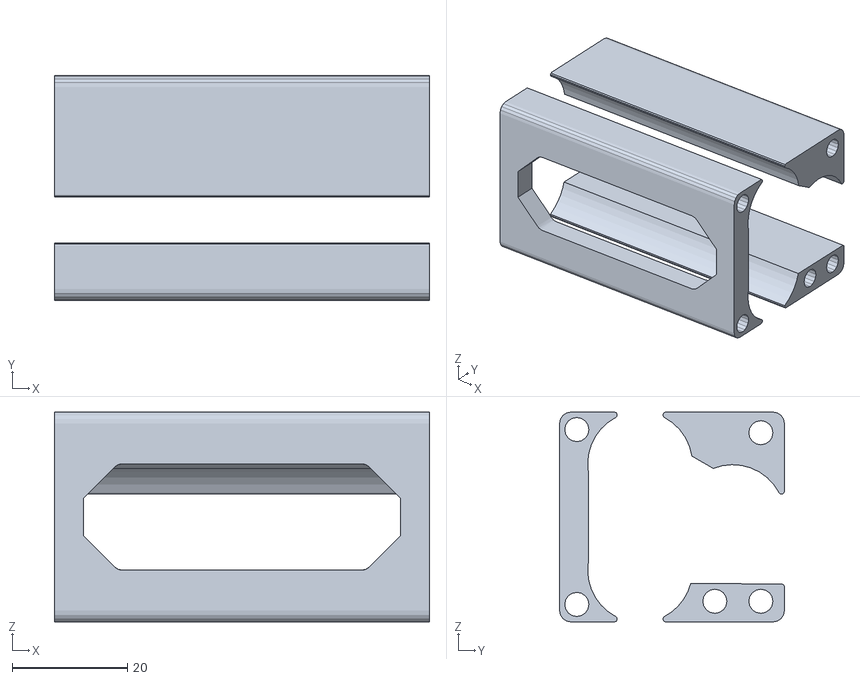
[picture p153: CAD file, 2026-09-08]
construction/version1/stl/left_akkum.stl
65.2 x 39.1 x 36.5
