GarinLev/Theseus_Maze/construction/version1/3D/VL53L0X_TOF.step

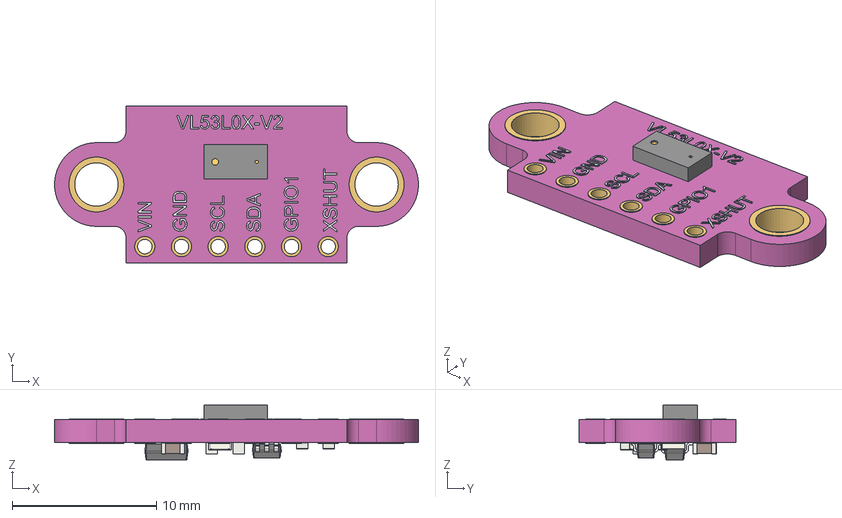
[picture p154: CAD file, 2026-03-02]
construction/version1/3D/VL53L0X_TOF.step
25.2 x 10.9 x 3.80 mm
PCB_pink
Trou1 x 6
TrouFix01 x 2
Text_VIN
Text_GND
Text_SCL
Text_SDA
Text_GPIO1
Text_XSHUT
Text_VL53L0X-V2
VL53L0X
C_0603_1608Metric
R_Array_Convex_4x0603
SOT_23
C_0603_1608Metric001
C_0603_1608Metric002
R_0603_1608Metric
R_0603_1608Metric001
SOT_363_SC_70_6
