GarinLev/Theseus_Maze/construction/version1/stl/fast_akkum2.stl

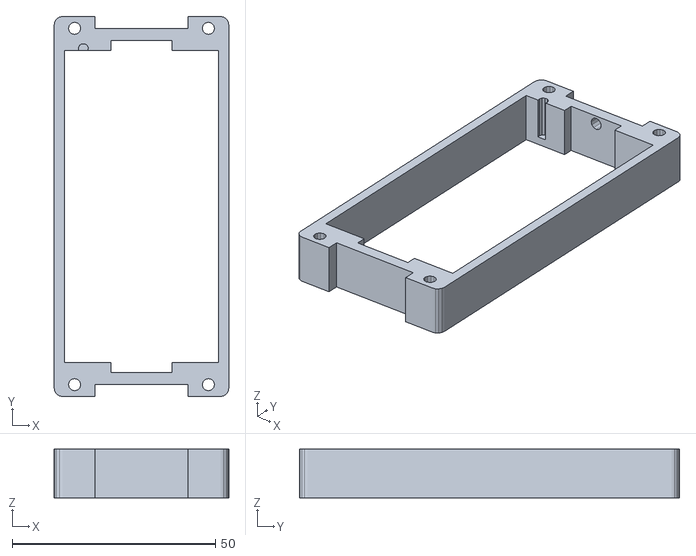
[picture p155: CAD file, 2026-09-08]
construction/version1/stl/fast_akkum2.stl
42.9 x 93.4 x 12.0
