GarinLev/Theseus_Maze/construction/prototip/крепёж_мотора_f.stl

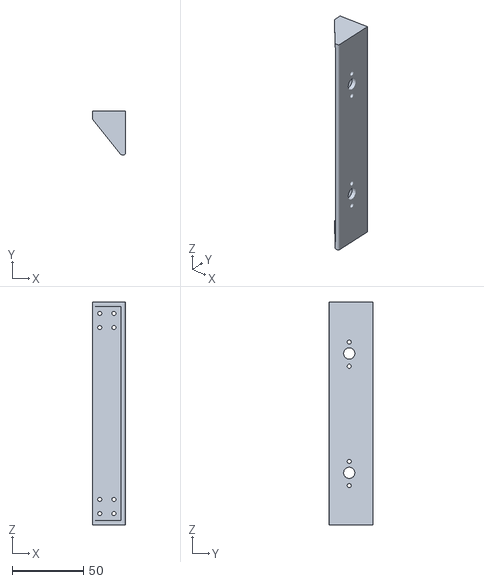
[picture p156: CAD file, 2026-09-08]
construction/prototip/крепёж_мотора_f.stl
23.0 x 31.0 x 157.0
