GarinLev/Theseus_Maze/construction/version1/3D/TOF VL53L0X.stp

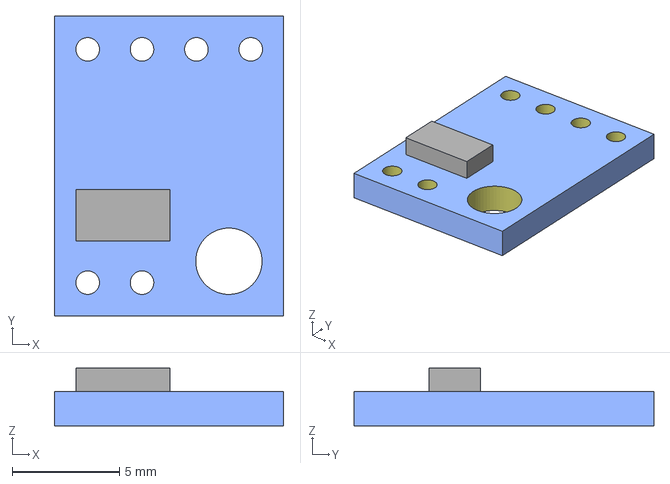
[picture p157: CAD file, 2026-03-02]
construction/version1/3D/TOF VL53L0X.stp
10.7 x 14.0 x 2.70 mm
