GarinLev/Theseus_Maze/construction/version1/3D/system_extrad.stl

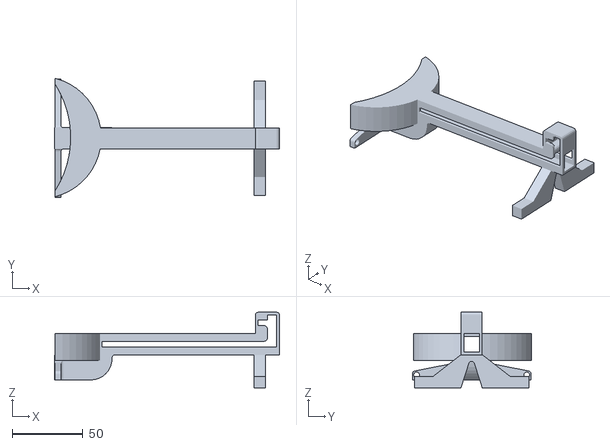
[picture p159: CAD file, 2026-03-02]
construction/version1/3D/system_extrad.stl
158.6 x 84.2 x 53.3
