GarinLev/Theseus_Maze/construction/version1/stl/fast_motors_left.stl

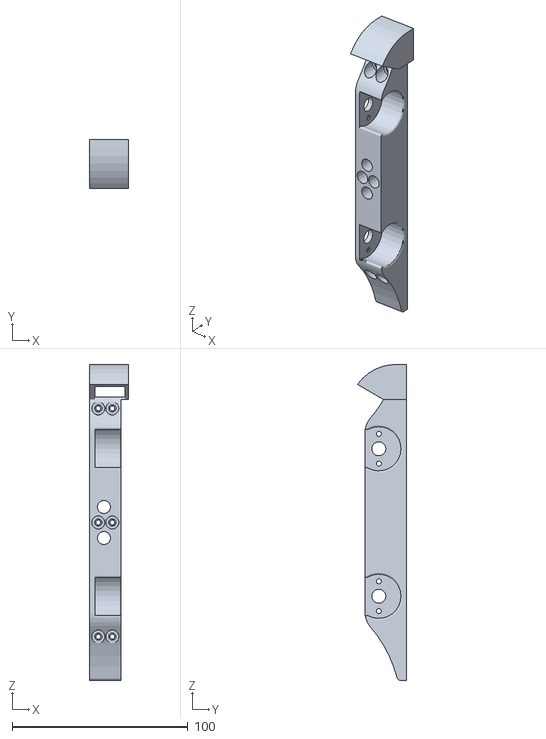
[picture p160: CAD file, 2026-09-08]
construction/version1/stl/fast_motors_left.stl
22.2 x 27.9 x 180.0
