GarinLev/Theseus_Maze/construction/prototip/колеса прототип.stl

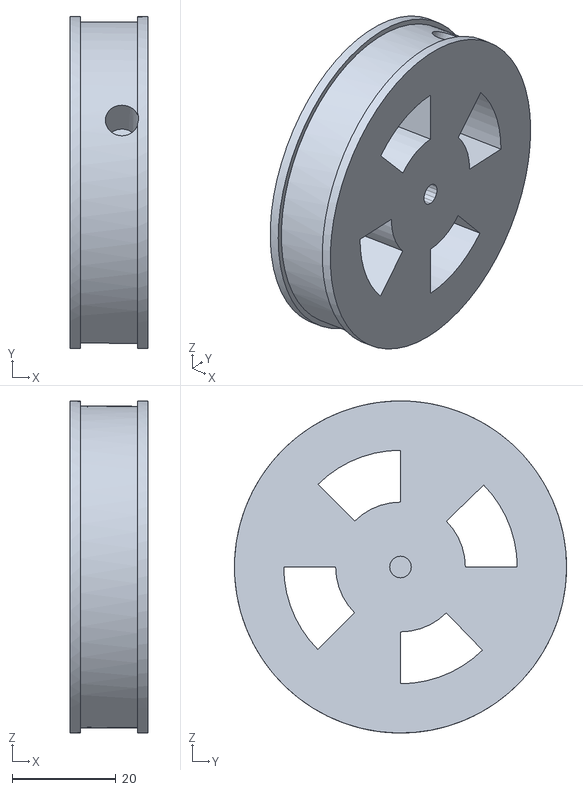
[picture p161: CAD file, 2026-09-08]
construction/prototip/колеса прототип.stl
15.0 x 64.0 x 64.0
