GarinLev/Theseus_Maze/construction/version1/3D/MG996R.step

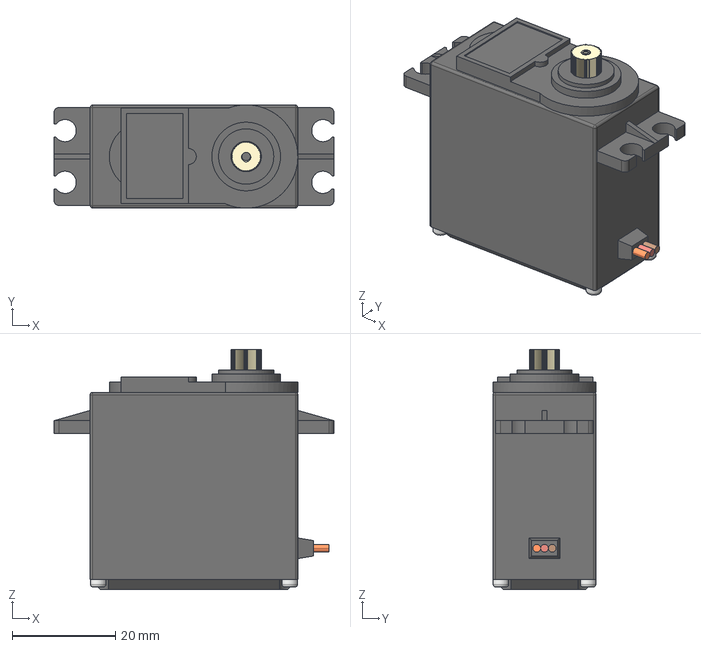
[picture p162: CAD file, 2026-03-02]
construction/version1/3D/MG996R.step
54.2 x 20.0 x 46.5 mm
