GarinLev/Theseus_Maze/construction/version1/stl/system_extrad_new_cap.3mf

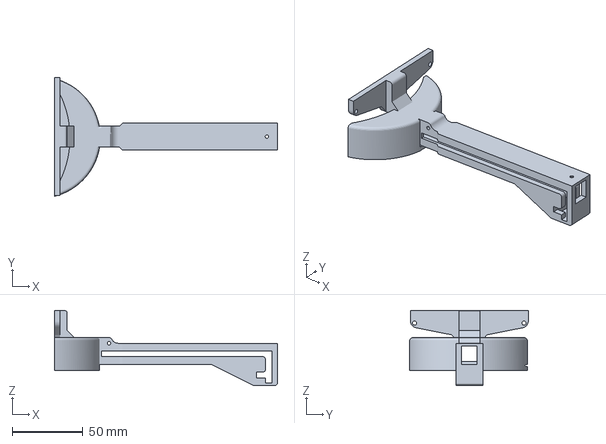
[picture p163: CAD file, 2026-09-08]
construction/version1/stl/system_extrad_new_cap.3mf
158.2 x 84.2 x 53.3 mm
