GarinLev/Theseus_Maze/construction/version1/3D/motor.step

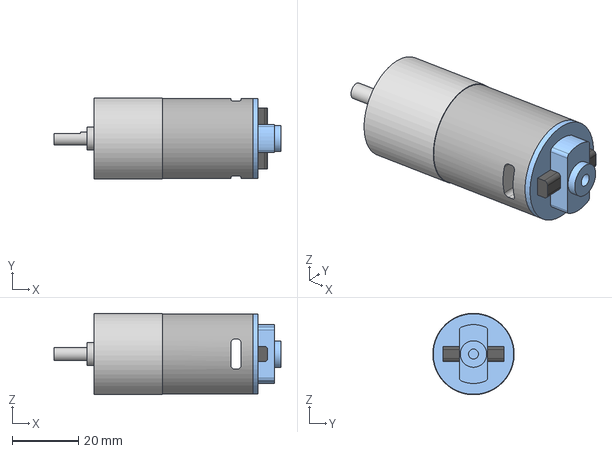
[picture p164: CAD file, 2026-03-02]
construction/version1/3D/motor.step
68.5 x 24.6 x 24.6 mm
