GarinLev/Theseus_Maze/construction/version1/stl/fast_switch.stl

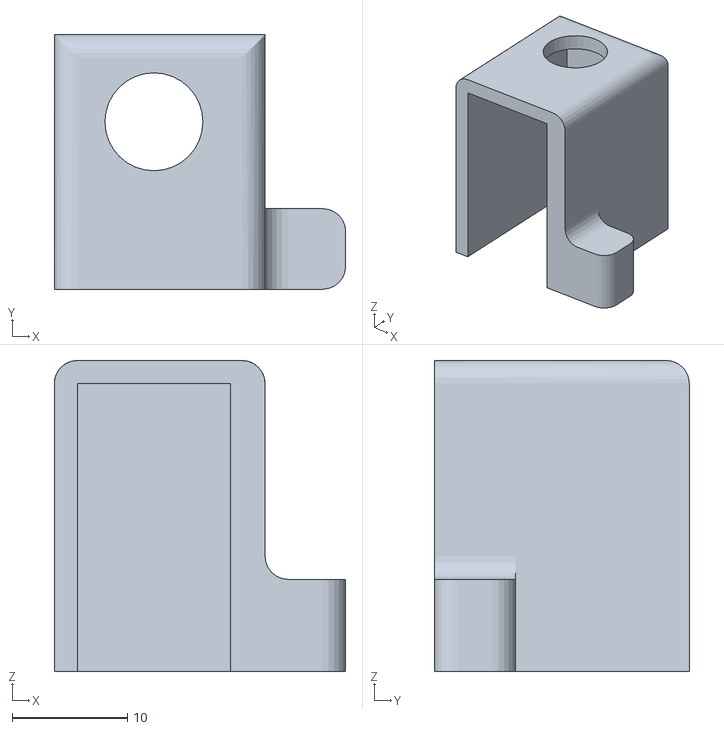
[picture p165: CAD file, 2026-09-08]
construction/version1/stl/fast_switch.stl
25.3 x 22.1 x 27.0
