GarinLev/Theseus_Maze/construction/prototip/крепёж_мотора.stl

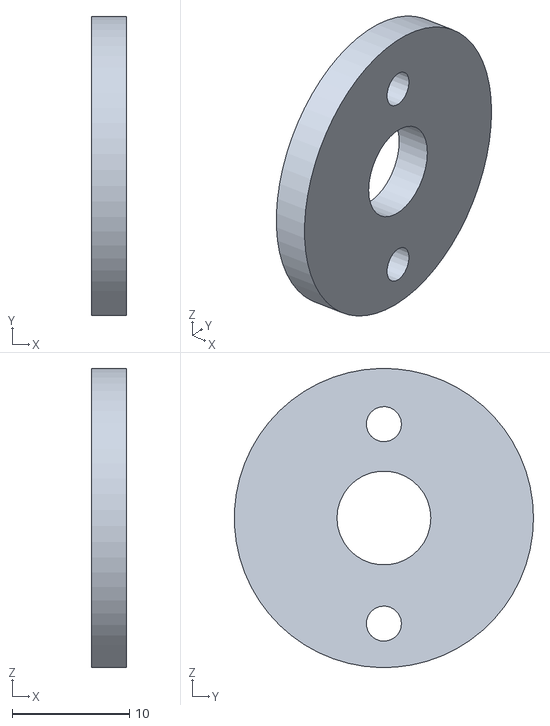
[picture p166: CAD file, 2026-09-08]
construction/prototip/крепёж_мотора.stl
3.00 x 25.5 x 25.5
