GarinLev/Theseus_Maze/construction/prototip/крепл_ЛЗД.stl

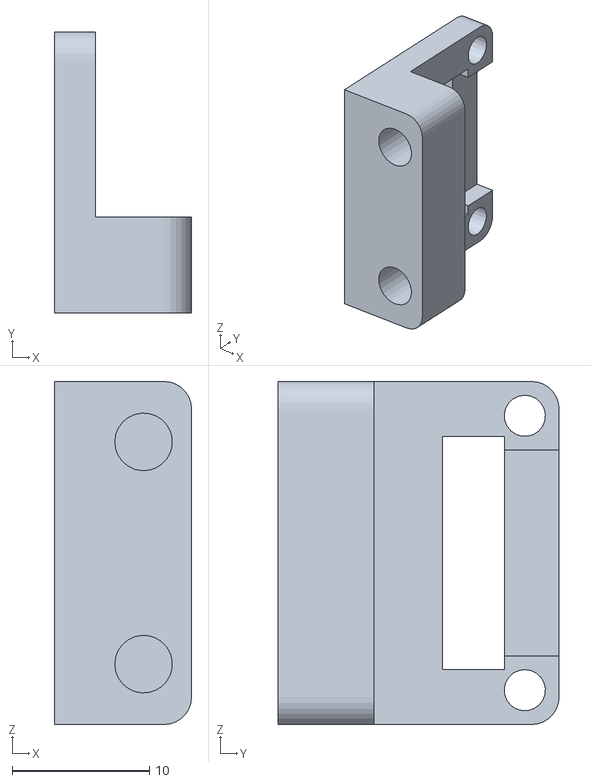
[picture p168: CAD file, 2026-09-08]
construction/prototip/крепл_ЛЗД.stl
10.0 x 20.5 x 25.0
