GarinLev/Theseus_Maze/construction/version1/stl/exstrad.3mf

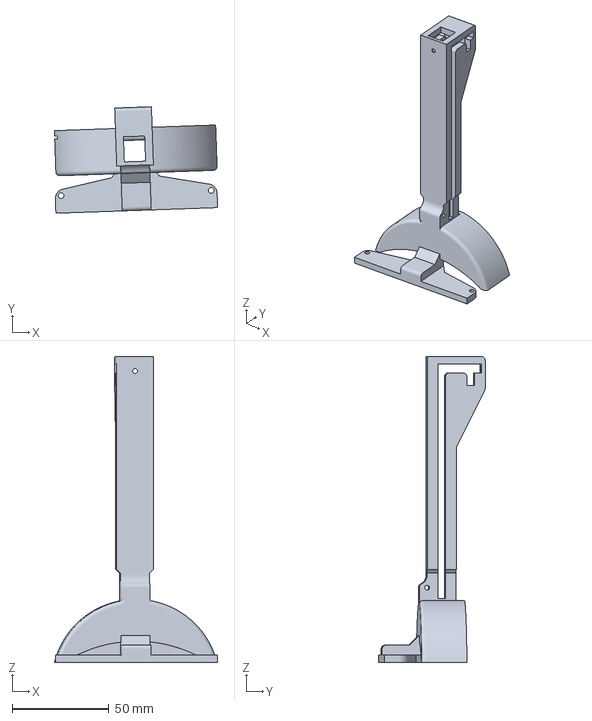
[picture p169: CAD file, 2026-09-08]
construction/version1/stl/exstrad.3mf
84.4 x 55.1 x 158.2 mm
