GarinLev/Theseus_Maze/construction/prototip/крепёж_мотора_3.stl

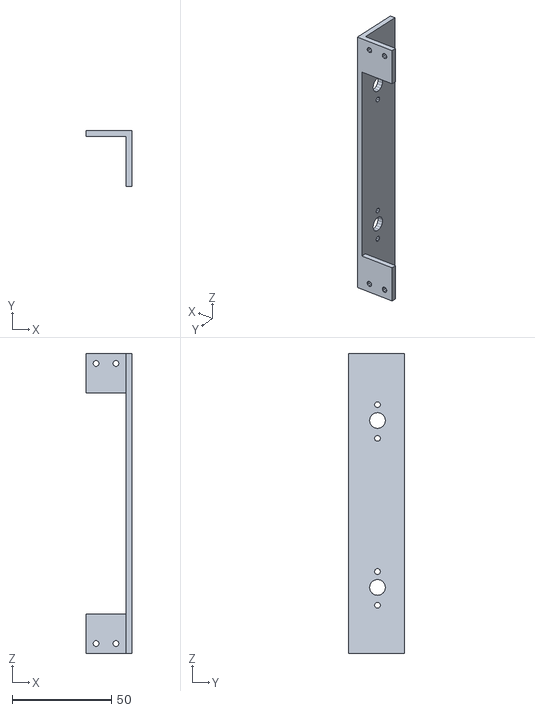
[picture p170: CAD file, 2026-09-08]
construction/prototip/крепёж_мотора_3.stl
23.0 x 28.0 x 151.0
