GarinLev/Theseus_Maze/construction/version1/stl/system_extrad_new.stl

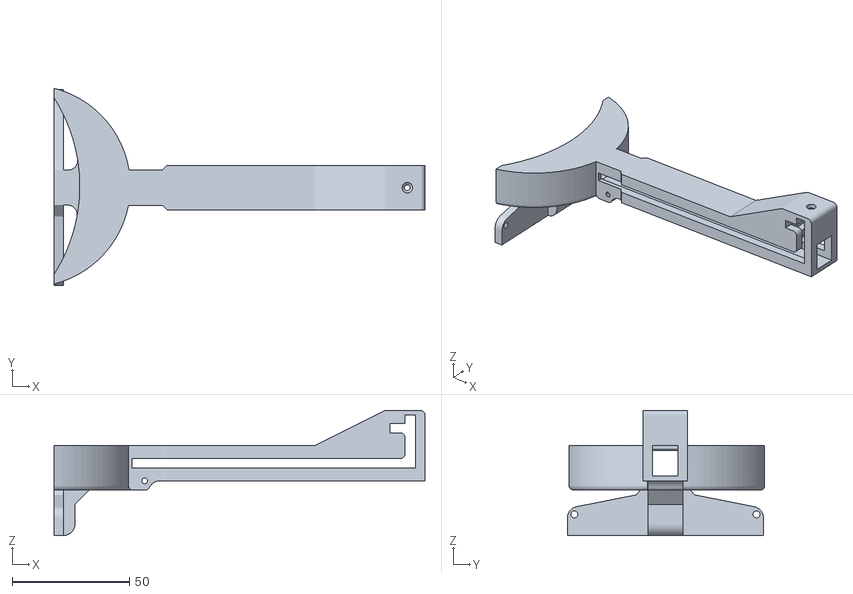
[picture p172: CAD file, 2026-09-08]
construction/version1/stl/system_extrad_new.stl
158.2 x 84.2 x 53.3
