GarinLev/Theseus_Maze/construction/version1/3D/COUPLE FLANGE.stp

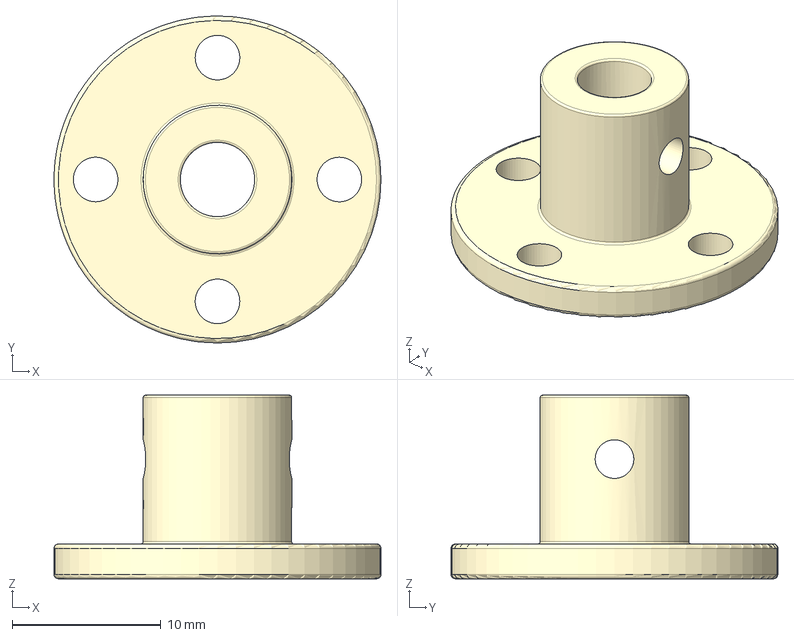
[picture p174: CAD file, 2026-03-02]
construction/version1/3D/COUPLE FLANGE.stp
22.0 x 22.0 x 12.3 mm
