GarinLev/Theseus_Maze/construction/version1/stl/system_extrad_2.stl

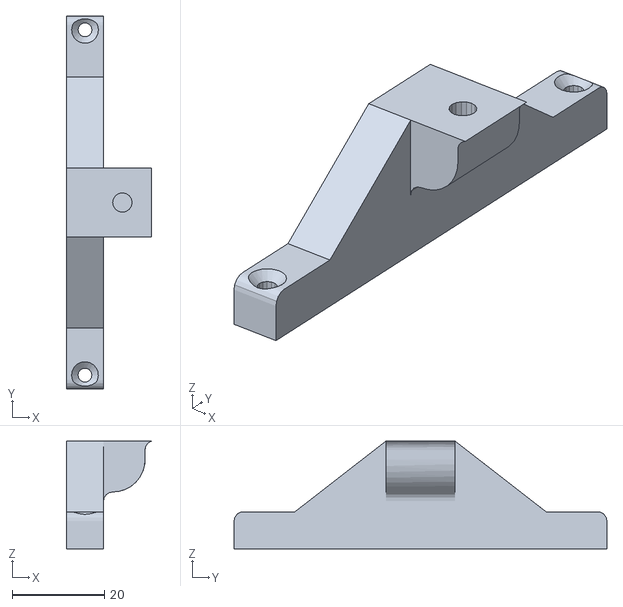
[picture p175: CAD file, 2026-09-08]
construction/version1/stl/system_extrad_2.stl
18.4 x 80.7 x 23.3
