GarinLev/Theseus_Maze/construction/version1/stl/base.stl

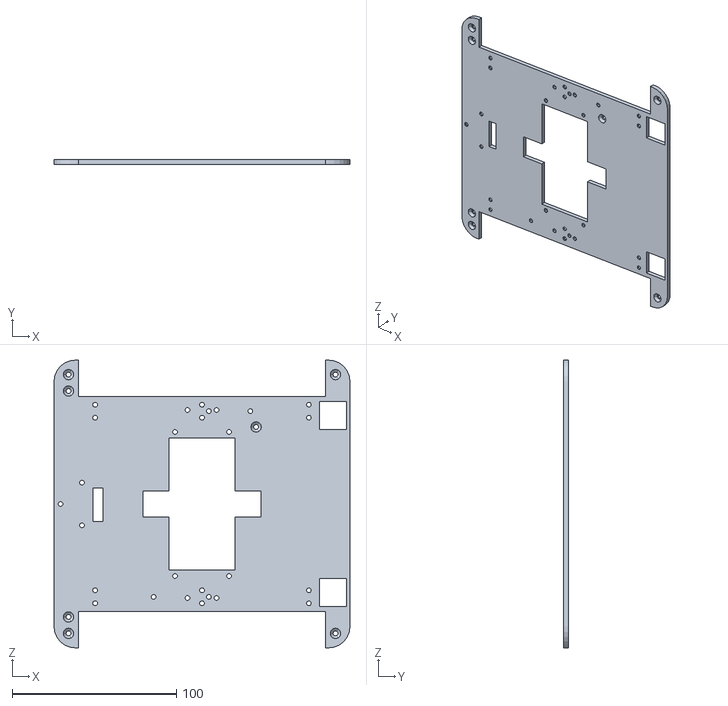
[picture p177: CAD file, 2026-09-08]
construction/version1/stl/base.stl
180.0 x 3.00 x 175.0
