GarinLev/Theseus_Maze/construction/version1/stl/pusher1.stl

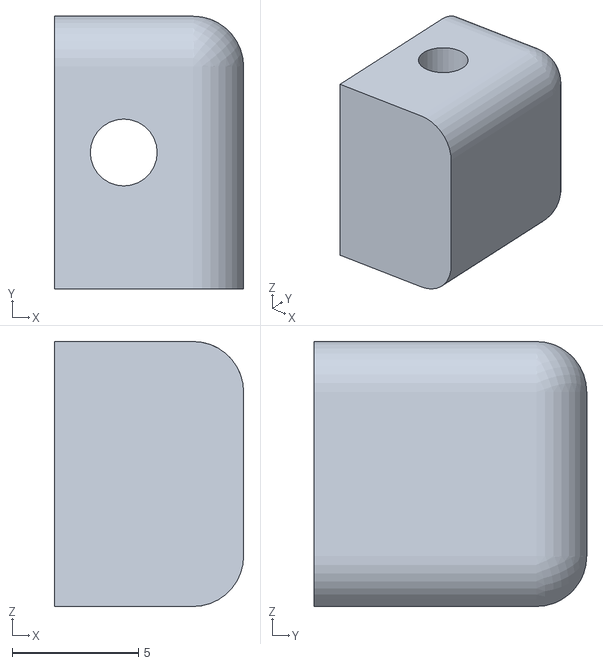
[picture p178: CAD file, 2026-09-08]
construction/version1/stl/pusher1.stl
7.50 x 10.8 x 10.5
