GarinLev/Theseus_Maze/construction/version1/stl/pusher.stl

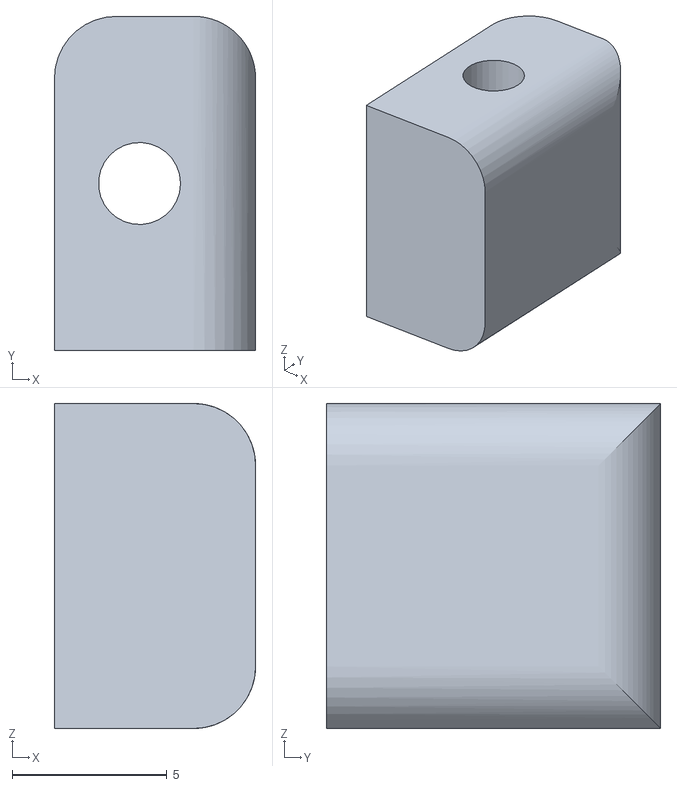
[picture p179: CAD file, 2026-09-08]
construction/version1/stl/pusher.stl
6.50 x 10.8 x 10.5
