GarinLev/Theseus_Maze/construction/version1/stl/low_part_wheel.stl

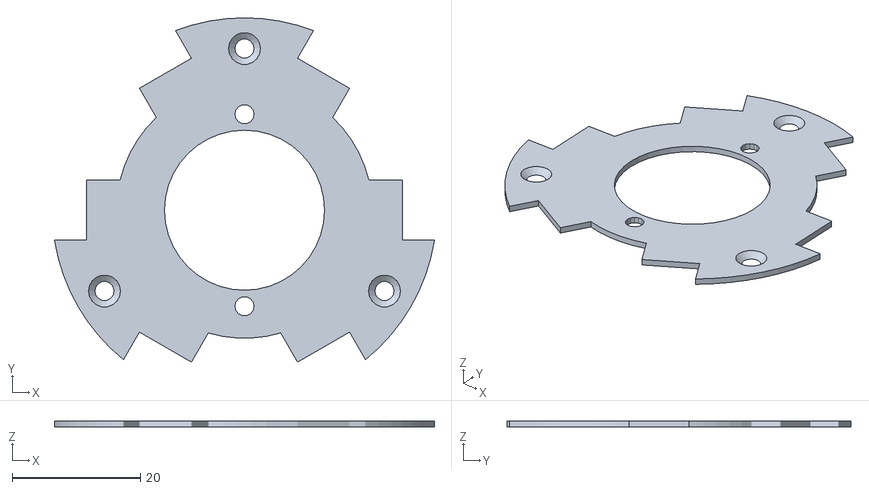
[picture p180: CAD file, 2026-09-08]
construction/version1/stl/low_part_wheel.stl
59.4 x 53.8 x 1.00
