GarinLev/Theseus_Maze/construction/version1/stl/end_cap.stl

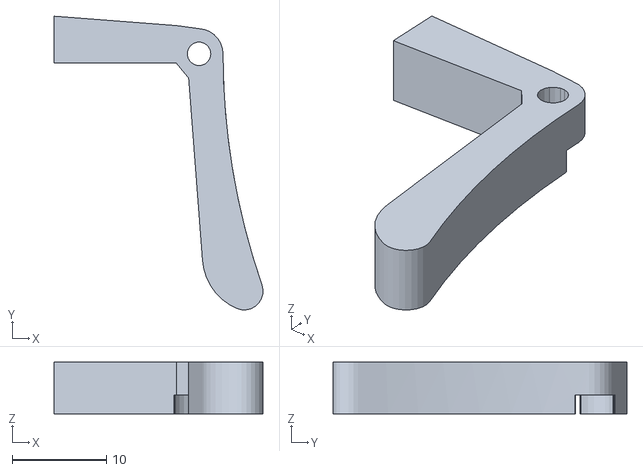
[picture p181: CAD file, 2026-09-08]
construction/version1/stl/end_cap.stl
22.2 x 31.2 x 5.50
