GarinLev/Theseus_Maze/construction/version1/stl/fast_camera.stl

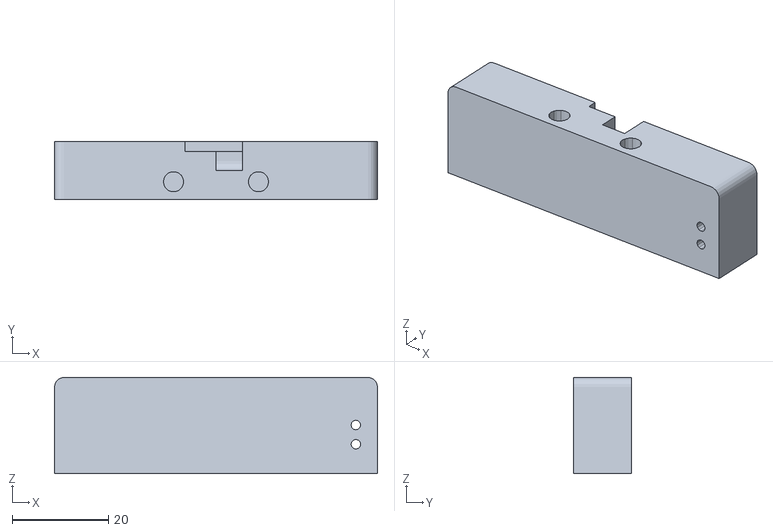
[picture p182: CAD file, 2026-09-08]
construction/version1/stl/fast_camera.stl
67.2 x 12.0 x 20.0
