GarinLev/Theseus_Maze/construction/version1/stl/akkum_wall_l.stl

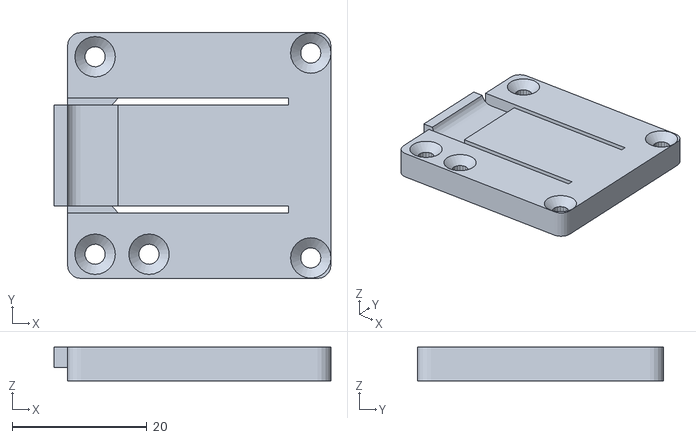
[picture p183: CAD file, 2026-09-08]
construction/version1/stl/akkum_wall_l.stl
41.1 x 36.5 x 5.00
