GarinLev/Theseus_Maze/construction/version1/stl/фтулка_1_8.stl

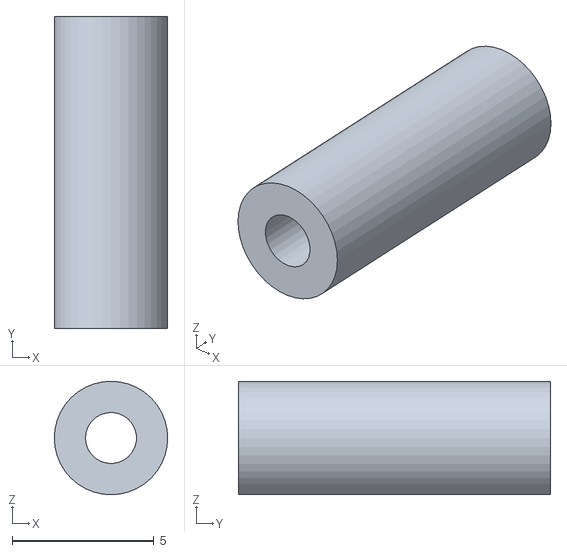
[picture p184: CAD file, 2026-09-08]
construction/version1/stl/фтулка_1_8.stl
4.00 x 11.0 x 4.00
