GarinLev/Theseus_Maze/construction/version1/stl/front_part_1.stl

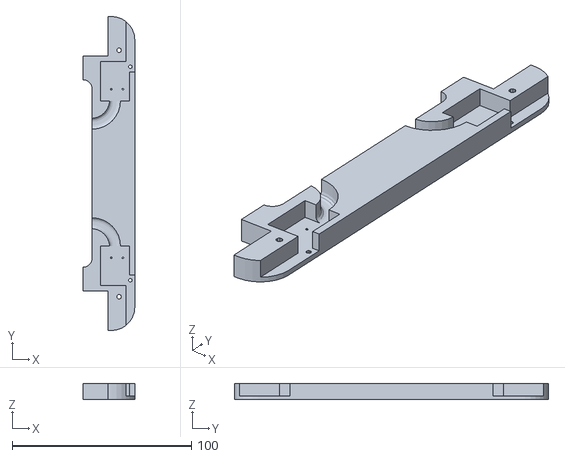
[picture p185: CAD file, 2026-09-08]
construction/version1/stl/front_part_1.stl
28.8 x 175.0 x 9.00
