GarinLev/Theseus_Maze/construction/version1/stl/wire_fixs.stl

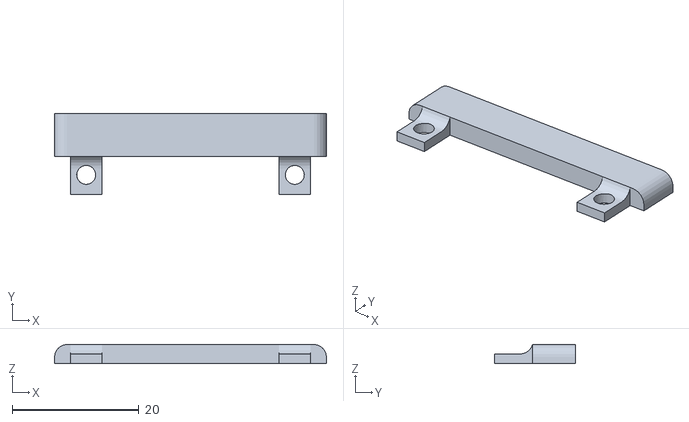
[picture p186: CAD file, 2026-09-08]
construction/version1/stl/wire_fixs.stl
42.9 x 12.8 x 3.00
