GarinLev/Theseus_Maze/construction/version1/stl/back_part.stl

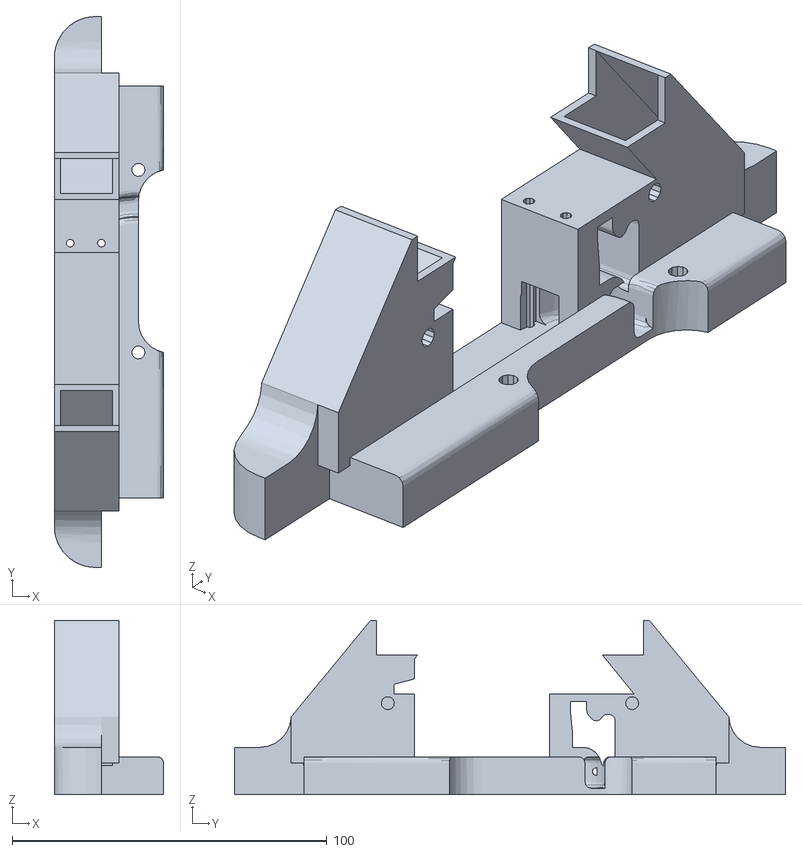
[picture p187: CAD file, 2026-09-08]
construction/version1/stl/back_part.stl
34.7 x 175.0 x 55.3
