GarinLev/Theseus_Maze/construction/version1/stl/wheel_mold.stl

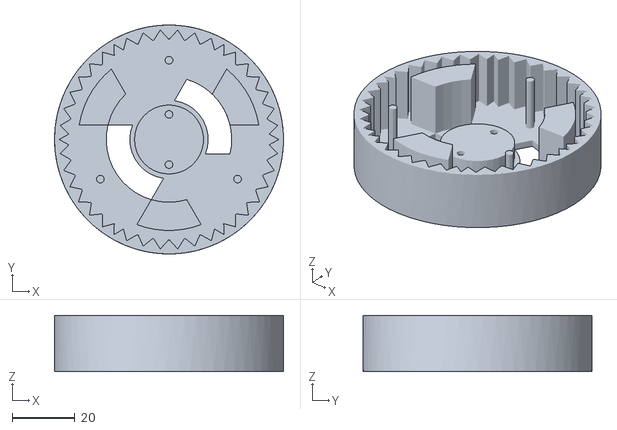
[picture p188: CAD file, 2026-09-08]
construction/version1/stl/wheel_mold.stl
73.0 x 73.0 x 18.0
