GarinLev/Theseus_Maze/construction/version1/stl/cap_of _exstrad.stl

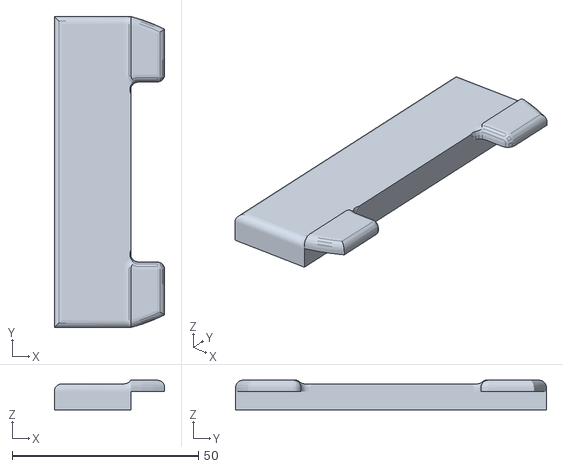
[picture p189: CAD file, 2026-09-08]
construction/version1/stl/cap_of _exstrad.stl
29.6 x 83.4 x 8.00
