GarinLev/Theseus_Maze/construction/version1/stl/inside_part_wheel.stl

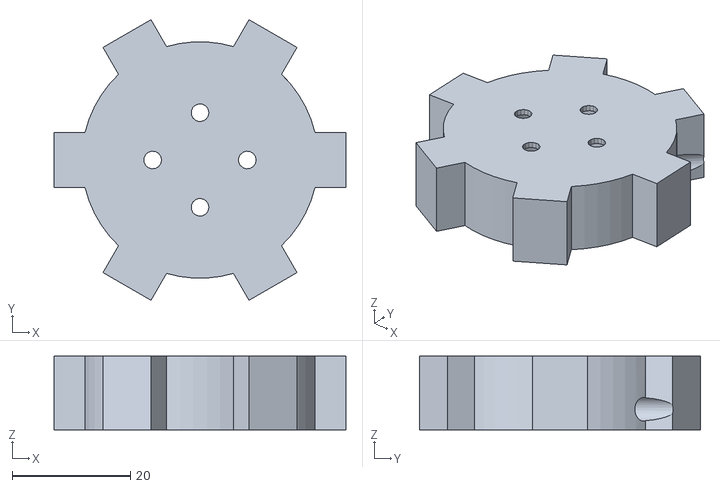
[picture p190: CAD file, 2026-09-08]
construction/version1/stl/inside_part_wheel.stl
49.4 x 47.5 x 12.5
