GarinLev/Theseus_Maze/construction/version1/stl/circle.stl

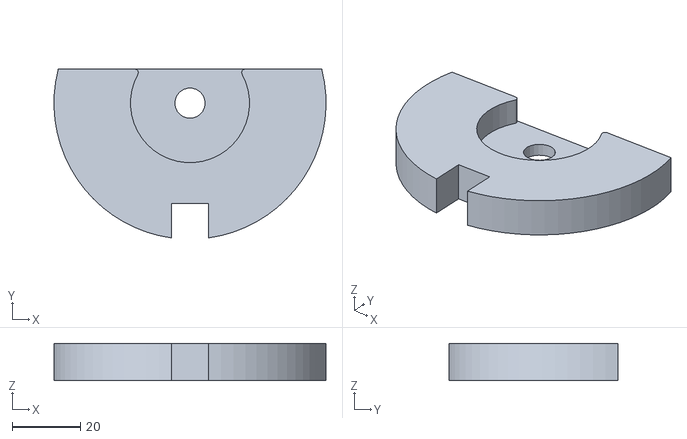
[picture p191: CAD file, 2026-09-08]
construction/version1/stl/circle.stl
80.0 x 49.6 x 11.0
