GarinLev/Theseus_Maze/construction/version1/stl/фтулка.stl

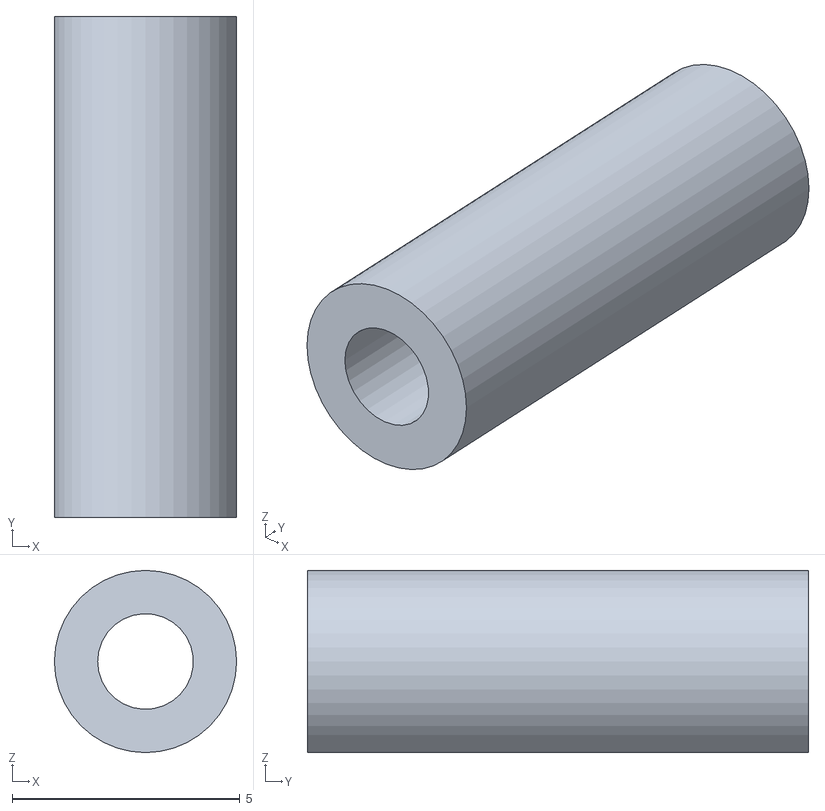
[picture p192: CAD file, 2026-09-08]
construction/version1/stl/фтулка.stl
4.00 x 11.0 x 4.00
