GarinLev/Theseus_Maze/(list of files, cad)

Other CAD files:
construction/prototip/крепёж_для_мотора_f.stl
construction/prototip/крепёж_для_мотора_fin.stl
construction/prototip/крепёж_для_мотора_3.stl
construction/version1/3D/GY-530 VL53L0X ToF.igs
construction/version1/stl/system_extrad_1.3mf
construction/prototip/колеса прототип 1.stl
construction/version1/stl/exstrad_TOMSK.3mf
construction/version1/stl/end_cap_right.stl
construction/version1/stl/back_part_Gy.stl
construction/version1/stl/fast_motors_right.stl
construction/version1/stl/akkum_wall_r.3mf
construction/version1/stl/front_part_2.stl
construction/prototip/OldVersions/maze_prototip.0008.iam
construction/prototip/OldVersions/крепёж_для_мотора.0007.ipt
construction/prototip/OldVersions/основа.0011.ipt
construction/prototip/maze_prototip.iam
construction/prototip/колеса прототип 1.ipt
construction/prototip/колеса прототип.ipt
construction/prototip/крепл_ЛД.ipt
construction/prototip/крепл_ЛЗД.ipt
construction/prototip/крепление_RGB.ipt
construction/prototip/крепление_ЛД.ipt
construction/prototip/крепёж_для_мотора.ipt
construction/prototip/крепёж_для_мотора.stl
construction/prototip/крепёж_мотора.ipt
construction/prototip/крепёж_мотора_3.ipt
construction/prototip/крепёж_мотора_f.ipt
construction/prototip/крепёж_мотора_прототип.ipt
construction/prototip/макетная плата.ipt
construction/prototip/основа.ipt
construction/prototip/основа_прототип.ipt
construction/prototip/стойки для драйверов.ipt
construction/prototip/шины.ipt
construction/version1/3D/Arducam USB Camera module B0431.ipt
construction/version1/3D/COUPLE FLANGE.ipt
construction/version1/3D/GY-530 VL53L0X ToF.ipt
construction/version1/3D/Generic Li Ion 1850 cell.ipt
construction/version1/3D/MG996R.ipt
construction/version1/3D/OldVersions/akkum.0003.iam
construction/version1/3D/OldVersions/back_part.0015.ipt
construction/version1/3D/OldVersions/base.0004.ipt
construction/version1/3D/OldVersions/base.0009.ipt
construction/version1/3D/OldVersions/circle.0005.ipt
construction/version1/3D/OldVersions/fast_RGB.0001.ipt
construction/version1/3D/OldVersions/fast_akkum.0002.ipt
construction/version1/3D/OldVersions/fast_camera.0007.ipt
construction/version1/3D/OldVersions/fast_motors.0005.ipt
construction/version1/3D/OldVersions/fast_motors_left.0001.ipt
construction/version1/3D/OldVersions/fast_motors_left.0002.ipt
construction/version1/3D/OldVersions/fast_motors_right.0004.ipt
construction/version1/3D/OldVersions/fast_motors_right.0005.ipt
construction/version1/3D/OldVersions/fasteners_motors.0002.ipt
construction/version1/3D/OldVersions/front_part_1.0003.ipt
construction/version1/3D/OldVersions/front_part_2.0005.ipt
construction/version1/3D/OldVersions/front_part_2.0010.ipt
construction/version1/3D/OldVersions/left_akkum.0002.ipt
construction/version1/3D/OldVersions/maze_version1.0073.iam
construction/version1/3D/OldVersions/motor.0001.ipt
construction/version1/3D/OldVersions/motor_25_110RPM.0002.ipt
construction/version1/3D/OldVersions/new_back_part.0004.ipt
construction/version1/3D/OldVersions/new_extrad_system.0003.ipt
construction/version1/3D/OldVersions/system_extrad.0004.ipt
construction/version1/3D/OldVersions/system_extrad.0016.ipt
construction/version1/3D/OldVersions/system_extrad.0017.ipt
construction/version1/3D/OldVersions/system_extrad.0018.ipt
construction/version1/3D/OldVersions/system_extrad.0019.ipt
construction/version1/3D/OldVersions/system_extrad.0020.ipt
construction/version1/3D/OldVersions/system_extrad_new.0001.ipt
construction/version1/3D/OldVersions/system_extrad_new.0002.ipt
construction/version1/3D/OldVersions/wheel.0018.iam
construction/version1/3D/OldVersions/колёса.0001.ipt
construction/version1/3D/SSD1327.ipt
construction/version1/3D/TCS34725 RGB sensor.STEP
construction/version1/3D/TCS34725 RGB sensor.ipt
construction/version1/3D/TOF VL53L0X.ipt
construction/version1/3D/Tumbler MT1.ipt
construction/version1/3D/VL53L0X_TOF.ipt
construction/version1/3D/akkum.iam
construction/version1/3D/akkum_wall.ipt
construction/version1/3D/akkum_wall_l.ipt
construction/version1/3D/akkum_wall_r.ipt
construction/version1/3D/akum_base.ipt
construction/version1/3D/akum_new.iam
construction/version1/3D/back_part.ipt
construction/version1/3D/back_part_Gy.ipt
construction/version1/3D/back_part_old_servo.ipt
construction/version1/3D/base.ipt
construction/version1/3D/base_ls.ipt
construction/version1/3D/board.ipt
construction/version1/3D/camera.ipt
construction/version1/3D/circle.ipt
construction/version1/3D/cube.ipt
construction/version1/3D/end_cap.ipt
construction/version1/3D/end_cap_left.ipt
construction/version1/3D/end_cap_right.ipt
construction/version1/3D/fast_RGB.ipt
construction/version1/3D/fast_akkum.ipt
construction/version1/3D/fast_akkum2.ipt
construction/version1/3D/fast_battery.ipt
construction/version1/3D/fast_camera.ipt
construction/version1/3D/fast_motors.ipt
construction/version1/3D/fast_motors_left.ipt
construction/version1/3D/fast_motors_right.ipt
construction/version1/3D/fast_switch.ipt
construction/version1/3D/front_part_1.ipt
construction/version1/3D/front_part_2.ipt
construction/version1/3D/handle.ipt
construction/version1/3D/inside_part_wheel.ipt
construction/version1/3D/left_akkum.ipt
construction/version1/3D/low_part_of_extrad_system.ipt
construction/version1/3D/low_part_wheel.ipt
construction/version1/3D/maze_version1.iam
construction/version1/3D/maze_version1.ipn
construction/version1/3D/motor.ipt
construction/version1/3D/motor_25_110RPM.ipt
construction/version1/3D/new_back_part.ipt
construction/version1/3D/new_extrad_system.ipt
construction/version1/3D/pusher.ipt
construction/version1/3D/raspberry_pi_5.ipt
construction/version1/3D/servo.ipt
construction/version1/3D/system_extrad.ipt
construction/version1/3D/system_extrad_new.ipt
construction/version1/3D/tcs34725_rgb_sensor.ipt
construction/version1/3D/tire.ipt
construction/version1/3D/top_part_wheel.ipt
construction/version1/3D/wheel.iam
construction/version1/3D/wheel_mold.ipt
construction/version1/3D/Винты M3 4 - 30 мм DIN965A 3D-модель.ipt
construction/version1/3D/Деталь14.ipt
construction/version1/3D/колёса.ipt
construction/version1/3D/фтулка.ipt
construction/version1/3D/фтулка_1_8.ipt
construction/version1/stl/OldVersions/pusher.xxxx.stl
construction/version1/stl/OldVersions/фтулка.0002.ipt
construction/version1/stl/akkum_wall_r.stl
construction/version1/stl/akkum_wall_r.stl.ipt
construction/version1/stl/back_part_new.ipt
construction/version1/stl/cap_of _exstrad.ipt
construction/version1/stl/cup.ipt
construction/version1/stl/fast_akkum.stl
construction/version1/stl/fast_camera_new.ipt
construction/version1/stl/front_part_2_new.ipt
construction/version1/stl/system_extrad_1.stl
construction/version1/stl/system_extrad_new_cap.stl
construction/version1/stl/wire_fixs.ipt
construction/version1/stl/фтулка.ipt
