GarinLev/Theseus_Maze/construction/version1/3D/maze.docx

Датчики расстояния(XSHUT) – 1 передний и по часовой стрелке

1 – D11

2 – D12

3 – D13

4 – D14

5 – D15

6 – D16

Моторы(драйвера)

1(левый верхний) in1 – D31 in2 – D32

2(правый верхний) in1 – D33 in2 – D34

3(левый нижний) in1 – D35 in2 – D36

4(правый нижний) in1 – D37 in2 – D38

Моторы(энкодеры)

1(левый верхний) D2, D22

2(правый верхний) D3, D23

3(левый нижний) D18, D24

4(правый нижний) D19, D25

Серва D5

Кнопка D42
