GarinLev/Theseus_Maze/construction/version1/contrac_maze_view.png

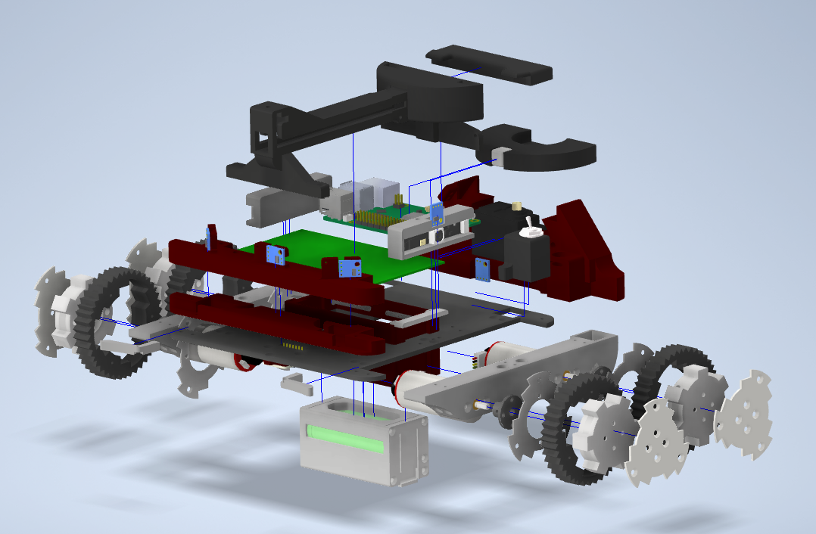
construction/version1/contrac_maze_view.png
