GarinLev/Theseus_Maze/Firmware-rpi/YOLOmazeMINSK/runs/detect/train/results.csv

epoch | time | train/box_loss | train/cls_loss | train/dfl_loss | metrics/precision(B) | metrics/recall(B) | metrics/mAP50(B) | metrics/mAP50-95(B) | val/box_loss | val/cls_loss | val/dfl_loss | lr/pg0 | lr/pg1 | lr/pg2
1 | 4.18732 | 1.02641 | 2.84801 | 1.15534 | 0.30362 | 1 | 0.64131 | 0.51553 | 0.67623 | 2.72047 | 0.90572 | 0.000375 | 0.000375 | 0.000375
2 | 7.47954 | 1.00514 | 1.77547 | 1.12116 | 0.87977 | 0.5931 | 0.81885 | 0.66002 | 0.78573 | 2.10085 | 0.96903 | 0.000749919 | 0.000749919 | 0.000749919
3 | 10.8428 | 1.03536 | 1.69244 | 1.16941 | 0.8 | 0.73726 | 0.87803 | 0.60772 | 1.0937 | 1.90028 | 1.14713 | 0.00111205 | 0.00111205 | 0.00111205
4 | 14.1313 | 0.98813 | 1.54438 | 1.10736 | 0.74575 | 0.87917 | 0.89431 | 0.64737 | 1.11865 | 1.71696 | 1.10827 | 0.00118812 | 0.00118812 | 0.00118812
5 | 17.3339 | 0.91641 | 1.31808 | 1.08359 | 0.9735 | 0.91667 | 0.93111 | 0.73955 | 0.79361 | 1.14532 | 0.96489 | 0.0011675 | 0.0011675 | 0.0011675
6 | 20.6798 | 0.90314 | 1.23015 | 1.08551 | 0.91405 | 0.97722 | 0.98867 | 0.85263 | 0.64554 | 0.90509 | 0.91135 | 0.00114688 | 0.00114688 | 0.00114688
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
