GarinLev/Theseus_Maze/Firmware-rpi/YOLOmazeMINSK/runs/detect/train2/results.csv

epoch | time | train/box_loss | train/cls_loss | train/dfl_loss | metrics/precision(B) | metrics/recall(B) | metrics/mAP50(B) | metrics/mAP50-95(B) | val/box_loss | val/cls_loss | val/dfl_loss | lr/pg0 | lr/pg1 | lr/pg2
1 | 5.68563 | 1.04431 | 2.64843 | 1.05748 | 0.00514 | 1 | 0.47092 | 0.33019 | 0.83215 | 3.09346 | 0.83025 | 0.000404412 | 0.000404412 | 0.000404412
2 | 11.8604 | 1.07146 | 1.41956 | 1.07155 | 0.89533 | 0.31232 | 0.69273 | 0.48076 | 0.99478 | 2.49687 | 0.96116 | 0.00081295 | 0.00081295 | 0.00081295
3 | 17.0274 | 1.01708 | 1.2358 | 1.06558 | 0.92933 | 0.65941 | 0.89635 | 0.73268 | 0.69654 | 2.14757 | 0.92656 | 0.00121324 | 0.00121324 | 0.00121324
4 | 21.9659 | 1.0119 | 1.13051 | 1.10257 | 0.95008 | 0.88676 | 0.96868 | 0.7283 | 0.83713 | 1.18752 | 0.97443 | 0.00121287 | 0.00121287 | 0.00121287
5 | 27.58 | 0.93063 | 0.99717 | 1.07027 | 0.90597 | 0.90628 | 0.96833 | 0.80315 | 0.72384 | 1.18066 | 1.03423 | 0.0012005 | 0.0012005 | 0.0012005
6 | 32.2876 | 0.91573 | 0.94658 | 1.07437 | 0.94018 | 0.90717 | 0.95466 | 0.61658 | 1.27008 | 1.27786 | 1.25494 | 0.00118812 | 0.00118812 | 0.00118812
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
