GarinLev/Theseus_Maze/Firmware-rpi/main_1/captured_images/test_h.jpg

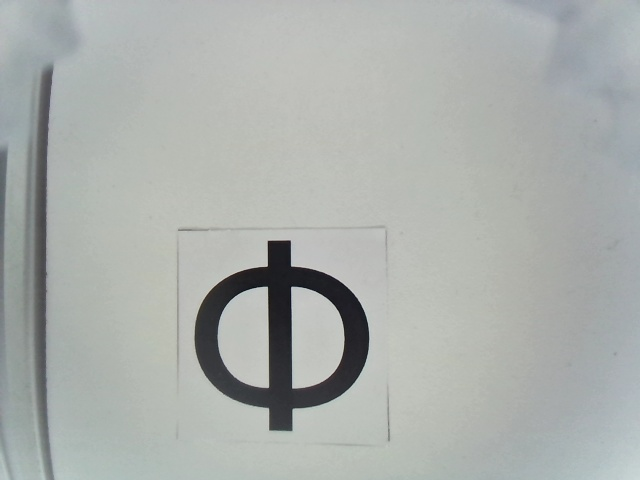
Firmware-rpi/main_1/captured_images/test_h.jpg
