GarinLev/Theseus_Maze/Firmware-rpi/test_target.jpg

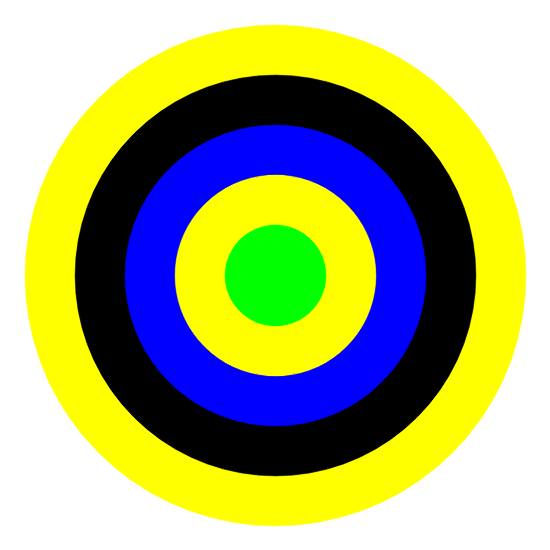
Firmware-rpi/test_target.jpg
