GarinLev/Theseus_Maze/Firmware-rpi/YOLOmazeMINSK/runs/detect/train2/results.png

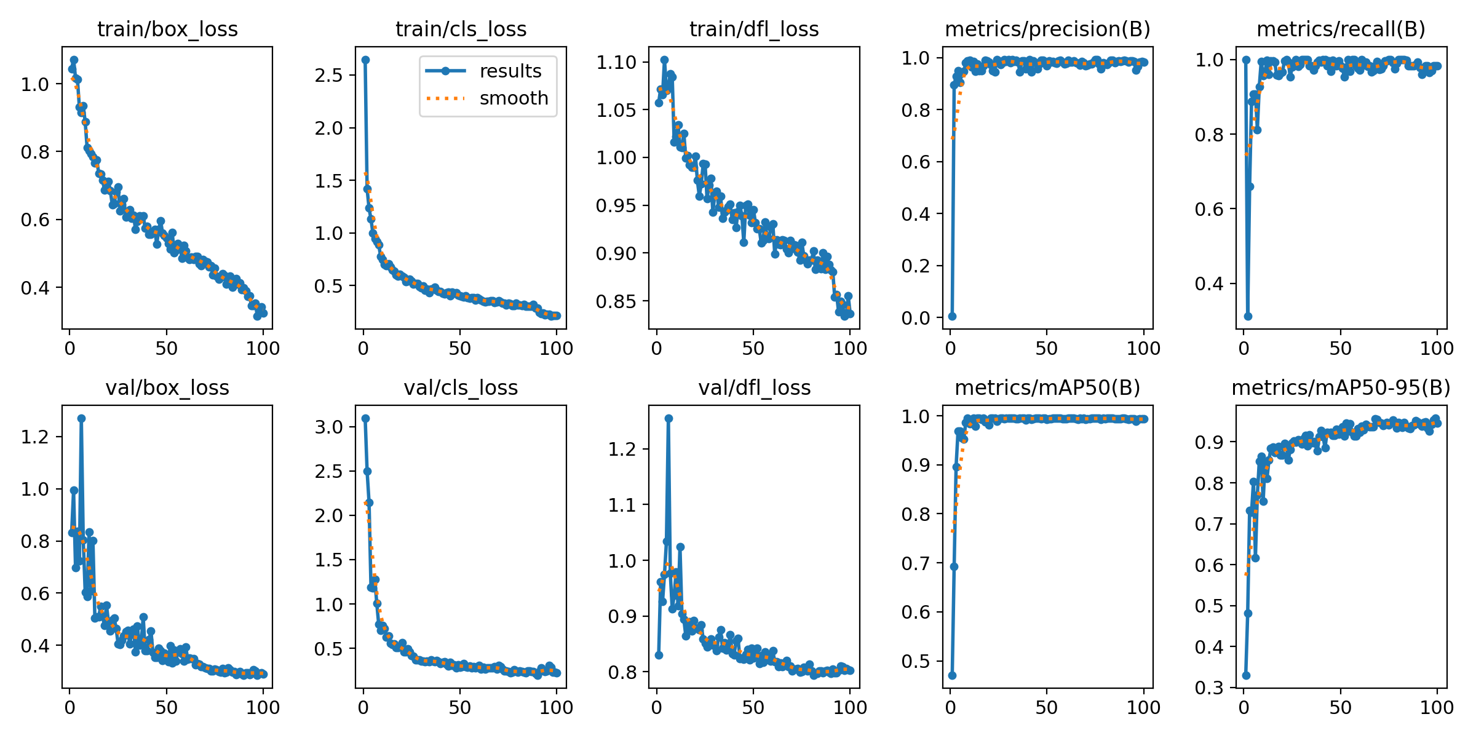
Firmware-rpi/YOLOmazeMINSK/runs/detect/train2/results.png
