GarinLev/Theseus_Maze/Firmware-rpi/YOLOmazeMINSK/runs/detect/train/results.png

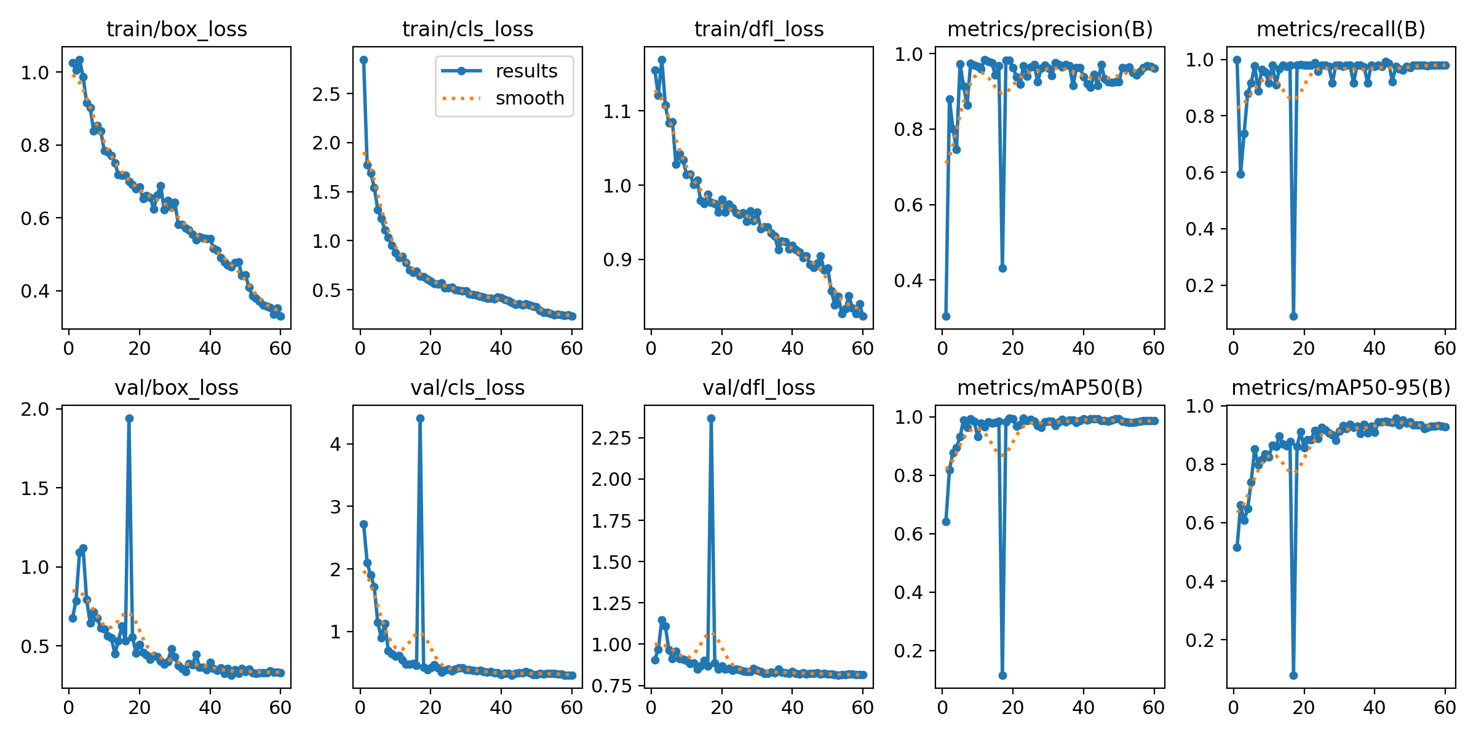
Firmware-rpi/YOLOmazeMINSK/runs/detect/train/results.png
