GarinLev/Theseus_Maze/Firmware-rpi/YOLOmazeMINSK/test/images/photo_4_jpg.rf.70c1c575a2f0bac55492bcc2608cb944.jpg

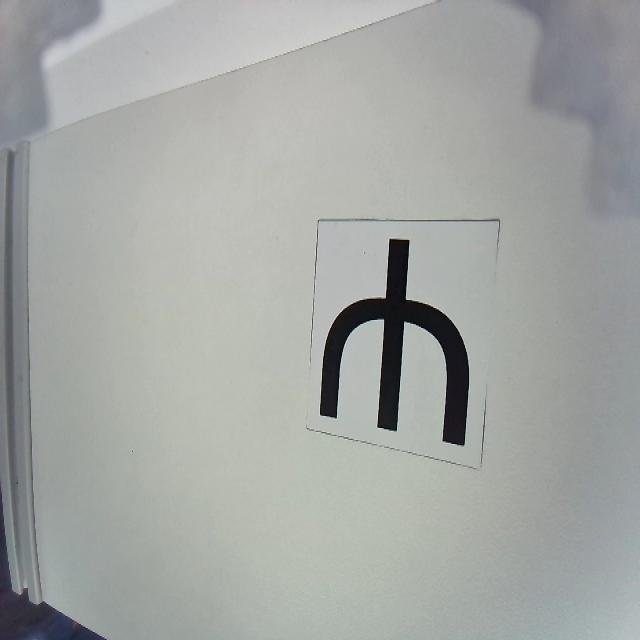
Firmware-rpi/YOLOmazeMINSK/test/images/photo_4_jpg.rf.70c1c575a2f0bac55492bcc2608cb944.jpg
