GarinLev/Theseus_Maze/Firmware-rpi/YOLOmazeMINSK/test/images/photo_7_jpg.rf.1e667436837270b83e36e0497dcef31e.jpg

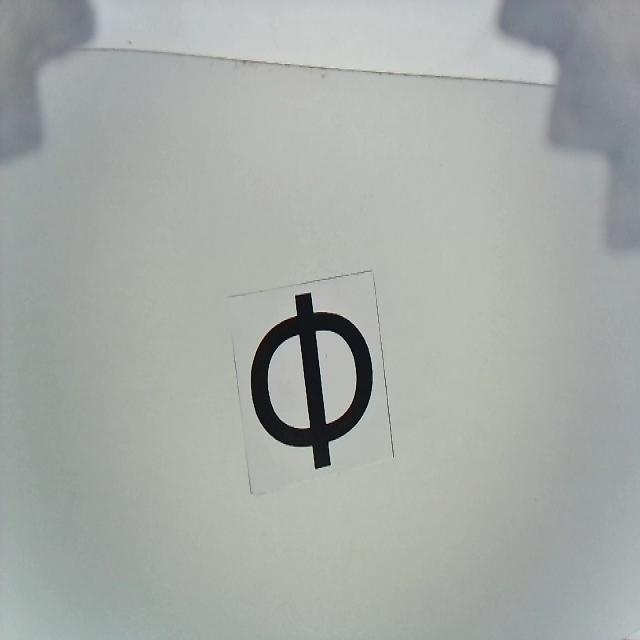
Firmware-rpi/YOLOmazeMINSK/test/images/photo_7_jpg.rf.1e667436837270b83e36e0497dcef31e.jpg
