GarinLev/Theseus_Maze/Firmware-rpi/YOLOmazeMINSK/test/images/photo_11_jpg.rf.ad8f3b176e676a28c61e62d4e2a1fb15.jpg

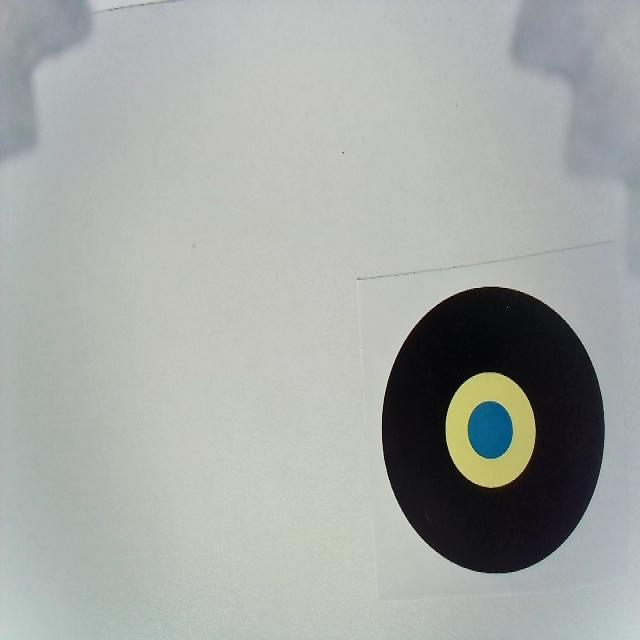
Firmware-rpi/YOLOmazeMINSK/test/images/photo_11_jpg.rf.ad8f3b176e676a28c61e62d4e2a1fb15.jpg
