GarinLev/Theseus_Maze/Firmware-rpi/YOLOmazeMINSK/test/images/photo_20_jpg.rf.6f7c2616387ed41768254d127ec75d4e.jpg

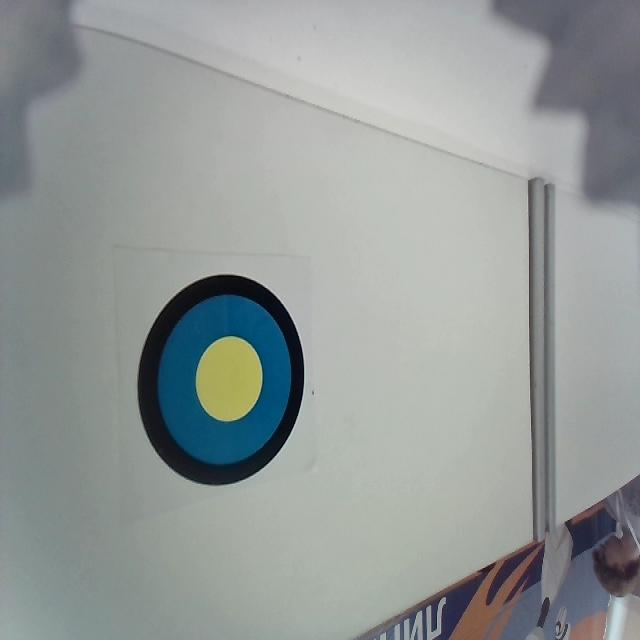
Firmware-rpi/YOLOmazeMINSK/test/images/photo_20_jpg.rf.6f7c2616387ed41768254d127ec75d4e.jpg
