GarinLev/Theseus_Maze/Firmware-rpi/YOLOmazeMINSK/test/images/photo_24_jpg.rf.6a63f09ca154ff882360f19f39df7c20.jpg

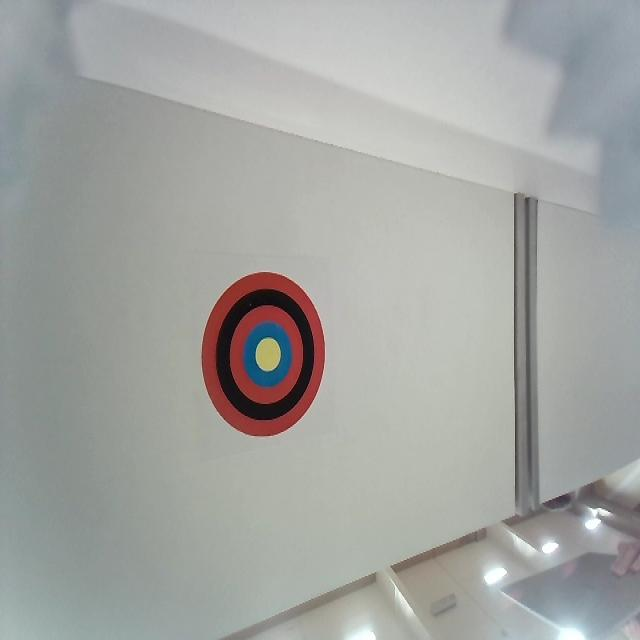
Firmware-rpi/YOLOmazeMINSK/test/images/photo_24_jpg.rf.6a63f09ca154ff882360f19f39df7c20.jpg
