GarinLev/Theseus_Maze/Firmware-rpi/YOLOmazeMINSK/test/images/photo_26_jpg.rf.36ad4e7f3ed19bda102be8323567c241.jpg

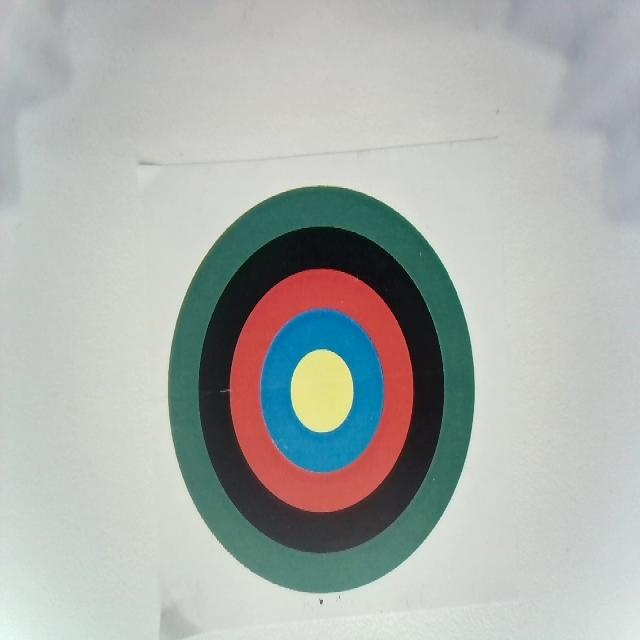
Firmware-rpi/YOLOmazeMINSK/test/images/photo_26_jpg.rf.36ad4e7f3ed19bda102be8323567c241.jpg
