GarinLev/Theseus_Maze/Firmware-rpi/YOLOmazeMINSK/test/images/photo_36_jpg.rf.6b0e2cd0e8734018fded45f11c78d9a0.jpg

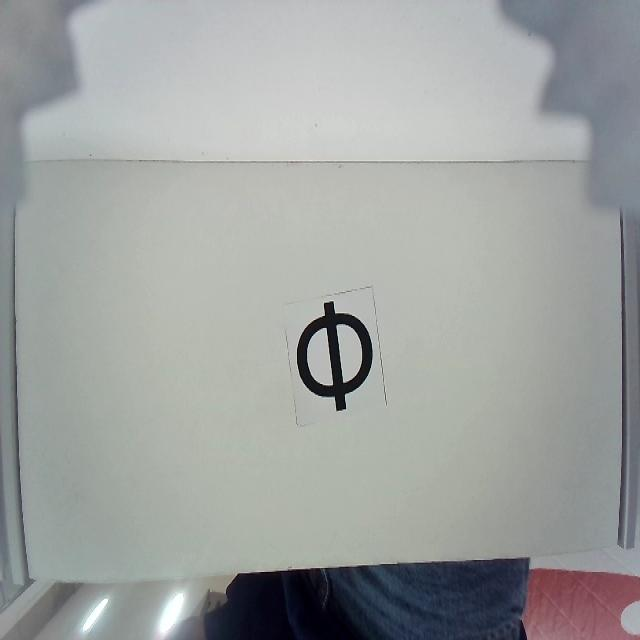
Firmware-rpi/YOLOmazeMINSK/test/images/photo_36_jpg.rf.6b0e2cd0e8734018fded45f11c78d9a0.jpg
