GarinLev/Theseus_Maze/Firmware-rpi/YOLOmazeMINSK/test/images/photo_42_jpg.rf.0a30d15f6e65ec69a15e6a185cb43de3.jpg

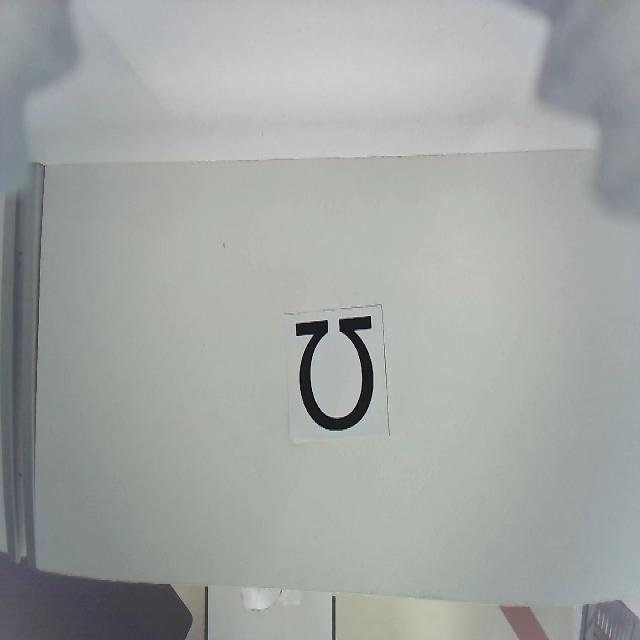
Firmware-rpi/YOLOmazeMINSK/test/images/photo_42_jpg.rf.0a30d15f6e65ec69a15e6a185cb43de3.jpg
