GarinLev/Theseus_Maze/Firmware-rpi/YOLOmazeMINSK/test/images/photo_43_jpg.rf.a2ad25b66076dd43cea75a3b191d435f.jpg

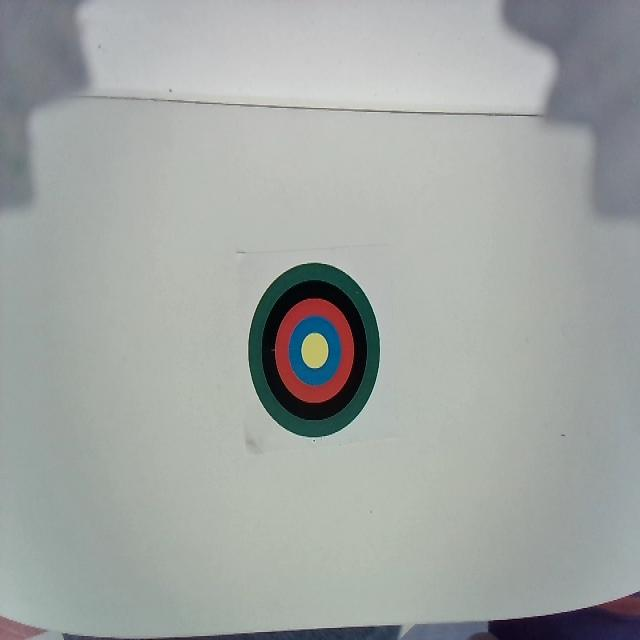
Firmware-rpi/YOLOmazeMINSK/test/images/photo_43_jpg.rf.a2ad25b66076dd43cea75a3b191d435f.jpg
