GarinLev/Theseus_Maze/Firmware-rpi/YOLOmazeMINSK/test/images/photo_55_jpg.rf.fd1af3a250dcc903c6424132ae6198ed.jpg

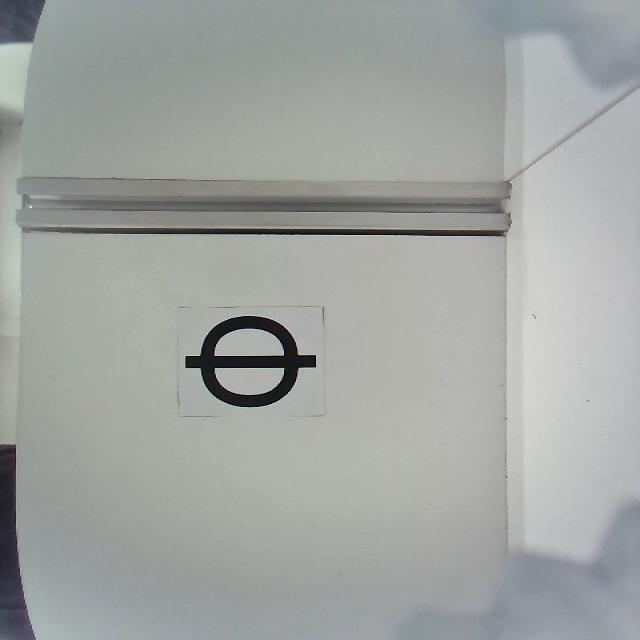
Firmware-rpi/YOLOmazeMINSK/test/images/photo_55_jpg.rf.fd1af3a250dcc903c6424132ae6198ed.jpg
