GarinLev/Theseus_Maze/Firmware-rpi/YOLOmazeMINSK/test/images/photo_87_jpg.rf.27331a744622e584fe1b518966cf1381.jpg

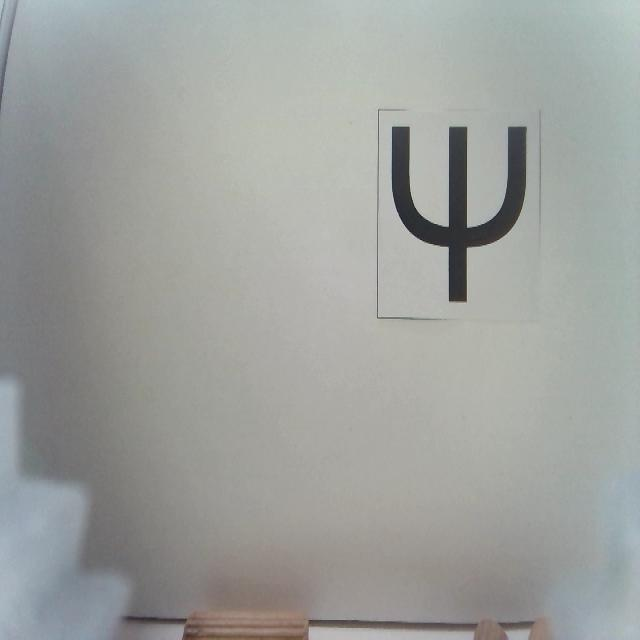
Firmware-rpi/YOLOmazeMINSK/test/images/photo_87_jpg.rf.27331a744622e584fe1b518966cf1381.jpg
