GarinLev/Theseus_Maze/Firmware-rpi/YOLOmazeMINSK/test/images/photoMINSK2_11_jpg.rf.06d54681bec86cdfd58ad9f9b44f0df5.jpg

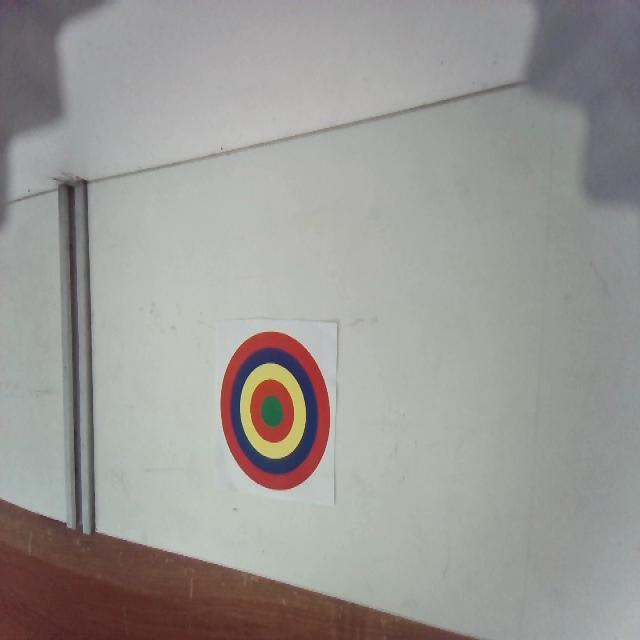
Firmware-rpi/YOLOmazeMINSK/test/images/photoMINSK2_11_jpg.rf.06d54681bec86cdfd58ad9f9b44f0df5.jpg
