GarinLev/Theseus_Maze/Firmware-rpi/YOLOmazeMINSK/test/images/photoMINSK2_14_jpg.rf.e89d821d4a6c07398e2f108b2446ba1e.jpg

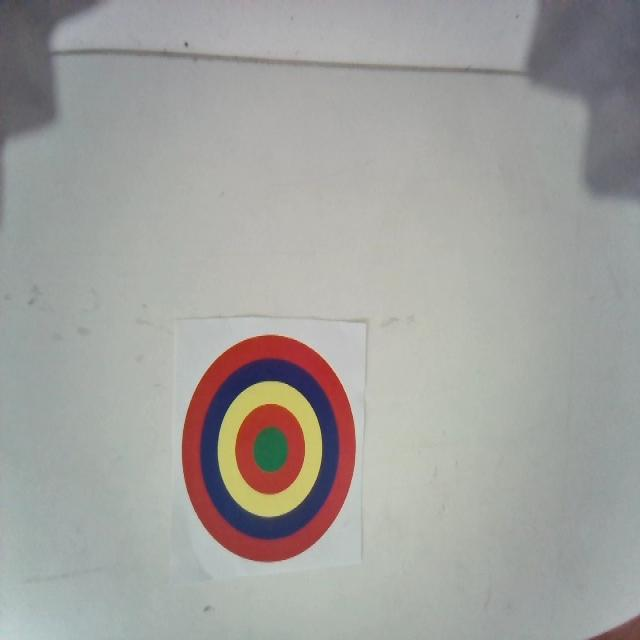
Firmware-rpi/YOLOmazeMINSK/test/images/photoMINSK2_14_jpg.rf.e89d821d4a6c07398e2f108b2446ba1e.jpg
