GarinLev/Theseus_Maze/Firmware-rpi/YOLOmazeMINSK/test/images/photoMINSK2_18_jpg.rf.0fc04c32ff42f22af31e23c4b6d87646.jpg

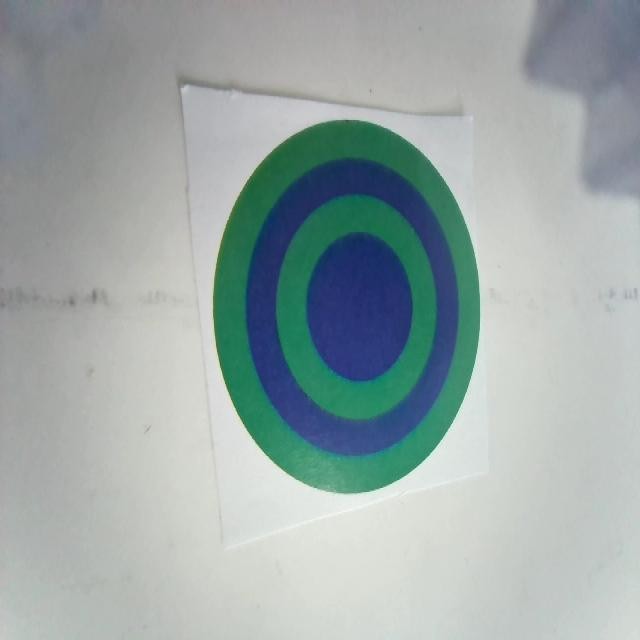
Firmware-rpi/YOLOmazeMINSK/test/images/photoMINSK2_18_jpg.rf.0fc04c32ff42f22af31e23c4b6d87646.jpg
