GarinLev/Theseus_Maze/Firmware-rpi/YOLOmazeMINSK/test/images/photoMINSK2_25_jpg.rf.8330e31c0e0f075a453145e13da022a3.jpg

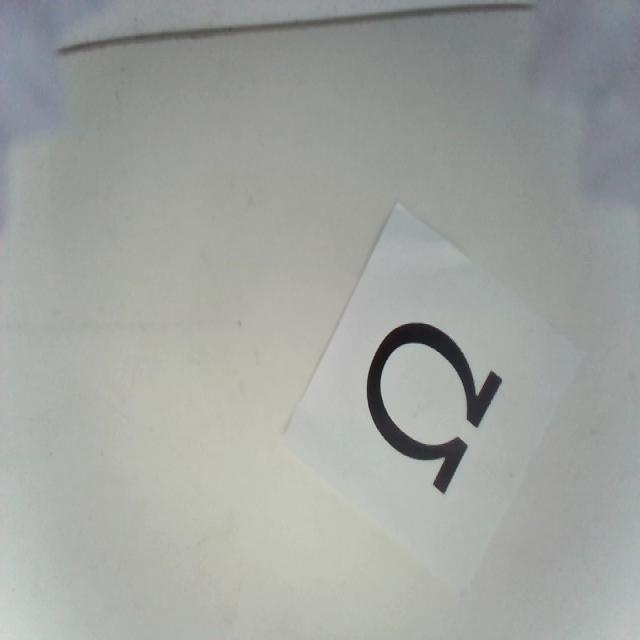
Firmware-rpi/YOLOmazeMINSK/test/images/photoMINSK2_25_jpg.rf.8330e31c0e0f075a453145e13da022a3.jpg
