GarinLev/Theseus_Maze/Firmware-rpi/YOLOmazeMINSK/test/images/photoMINSK2_36_jpg.rf.08ed4d823e86efae2b6aa2a94f223edc.jpg

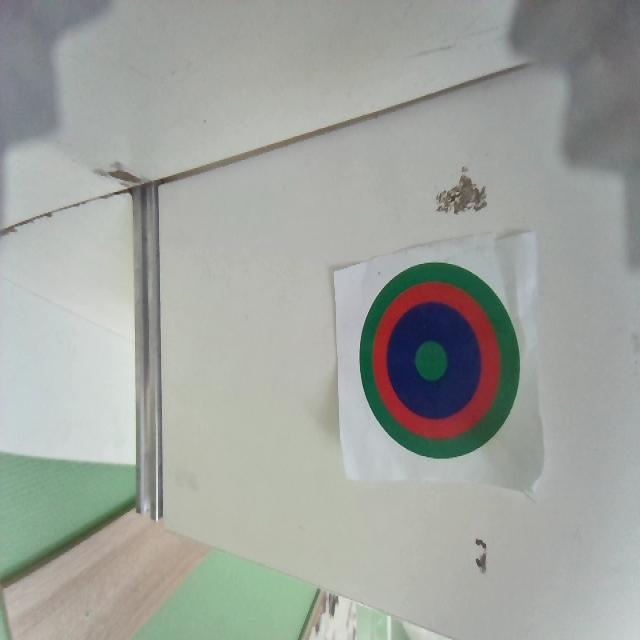
Firmware-rpi/YOLOmazeMINSK/test/images/photoMINSK2_36_jpg.rf.08ed4d823e86efae2b6aa2a94f223edc.jpg
