GarinLev/Theseus_Maze/Firmware-rpi/YOLOmazeMINSK/test/images/photoMINSK2_44_jpg.rf.079a15d2062cebb5c5919a60529f4832.jpg

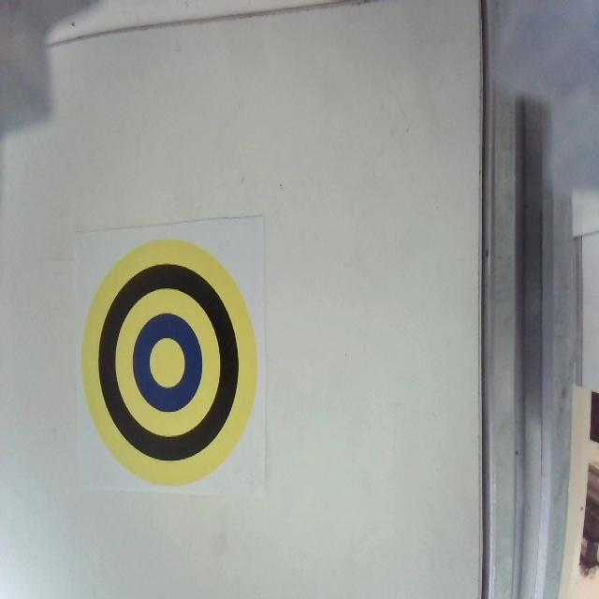
Firmware-rpi/YOLOmazeMINSK/test/images/photoMINSK2_44_jpg.rf.079a15d2062cebb5c5919a60529f4832.jpg
