GarinLev/Theseus_Maze/Firmware-rpi/YOLOmazeMINSK/test/images/photoMINSK2_48_jpg.rf.102a407e92b873b70cff7a7332fde845.jpg

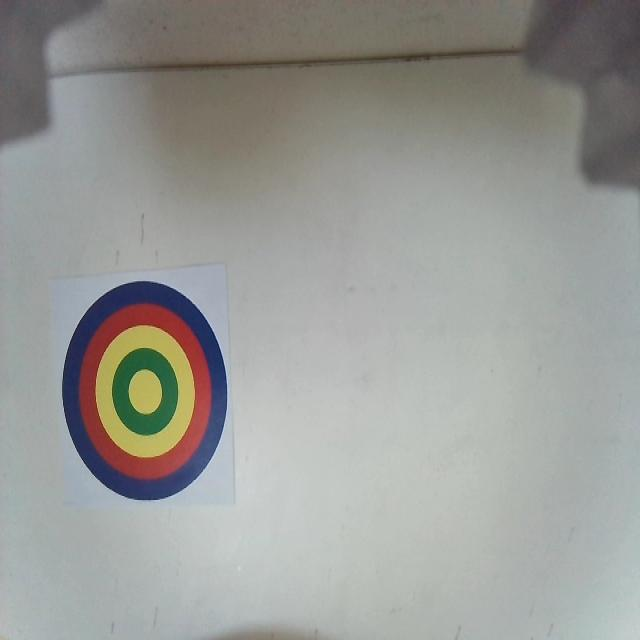
Firmware-rpi/YOLOmazeMINSK/test/images/photoMINSK2_48_jpg.rf.102a407e92b873b70cff7a7332fde845.jpg
