GarinLev/Theseus_Maze/Firmware-rpi/YOLOmazeMINSK/test/images/photoMINSK2_69_jpg.rf.12a37676176b8b26a2b4a3fbb09efbac.jpg

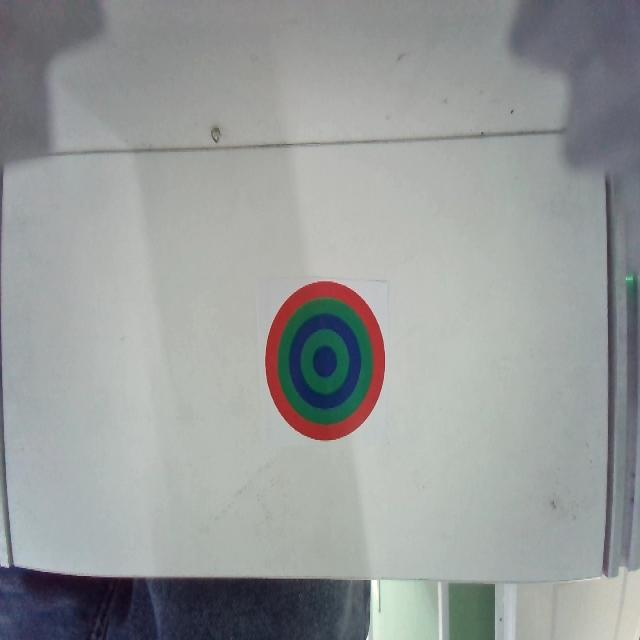
Firmware-rpi/YOLOmazeMINSK/test/images/photoMINSK2_69_jpg.rf.12a37676176b8b26a2b4a3fbb09efbac.jpg
