GarinLev/Theseus_Maze/Firmware-rpi/YOLOmazeMINSK/test/images/photoMINSK2_79_jpg.rf.54a48659e4699398fb6133b89d6b31f1.jpg

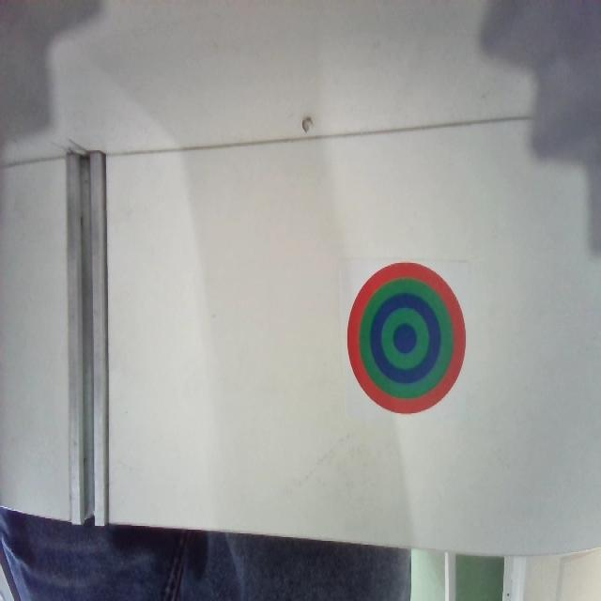
Firmware-rpi/YOLOmazeMINSK/test/images/photoMINSK2_79_jpg.rf.54a48659e4699398fb6133b89d6b31f1.jpg
