GarinLev/Theseus_Maze/Firmware-rpi/YOLOmazeMINSK/test/images/photoMINSK2_83_jpg.rf.f32c8837dde6b493e294a1355e426d2a.jpg

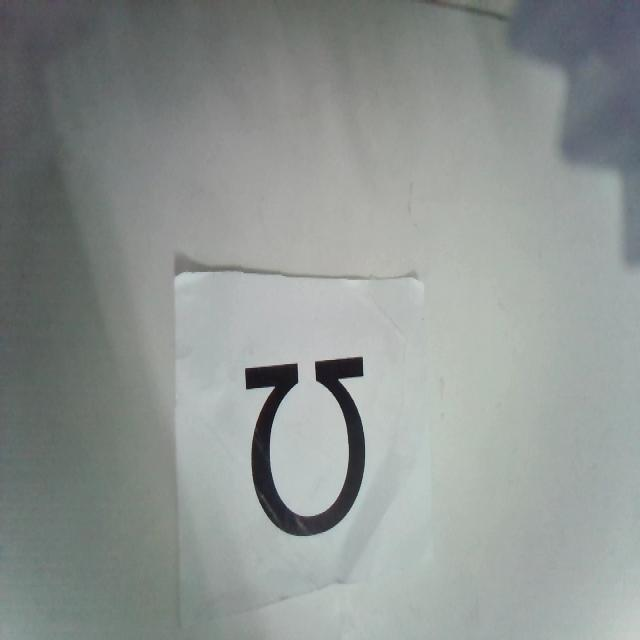
Firmware-rpi/YOLOmazeMINSK/test/images/photoMINSK2_83_jpg.rf.f32c8837dde6b493e294a1355e426d2a.jpg
