GarinLev/Theseus_Maze/Firmware-rpi/YOLOmazeMINSK/test/images/photoMINSK2_91_jpg.rf.5acb589d82e4d2afc2db0ec23a232165.jpg

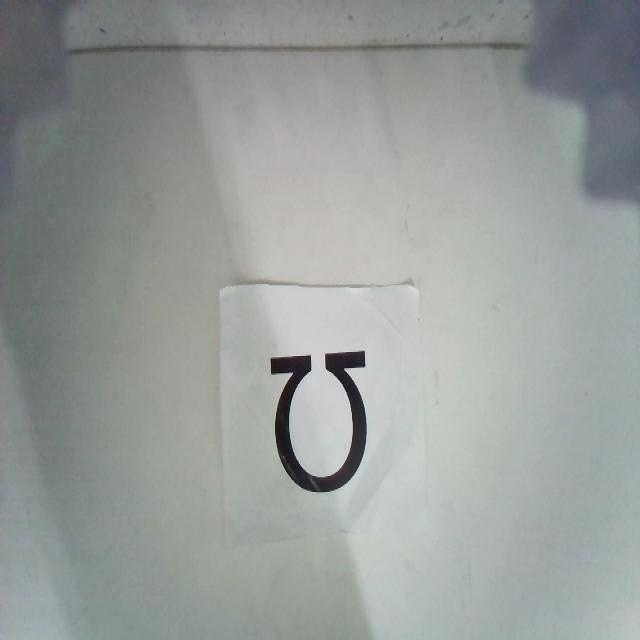
Firmware-rpi/YOLOmazeMINSK/test/images/photoMINSK2_91_jpg.rf.5acb589d82e4d2afc2db0ec23a232165.jpg
