GarinLev/Theseus_Maze/Firmware-rpi/YOLOmazeMINSK/test/images/photoMINSK2_92_jpg.rf.a33f16fc8160950c5306092b7ce0e0f6.jpg

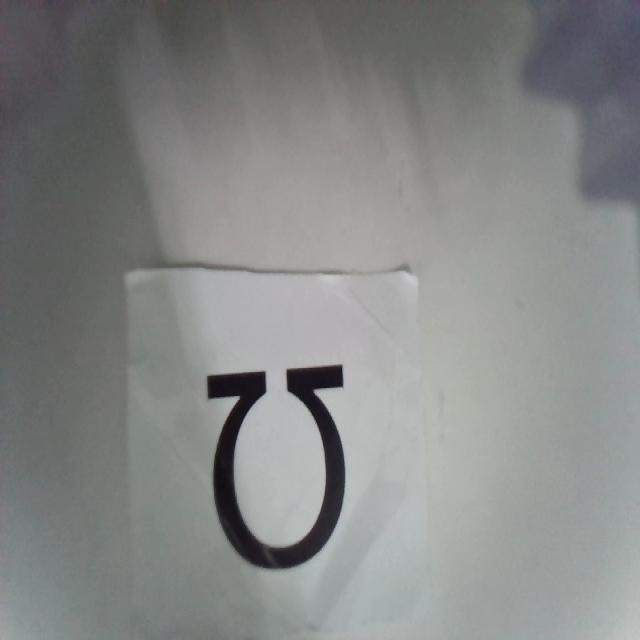
Firmware-rpi/YOLOmazeMINSK/test/images/photoMINSK2_92_jpg.rf.a33f16fc8160950c5306092b7ce0e0f6.jpg
