GarinLev/Theseus_Maze/Firmware-rpi/YOLOmazeMINSK/test/images/photoMINSK3_0_jpg.rf.f07594223c571f7ff54d62afe6bf1d9d.jpg

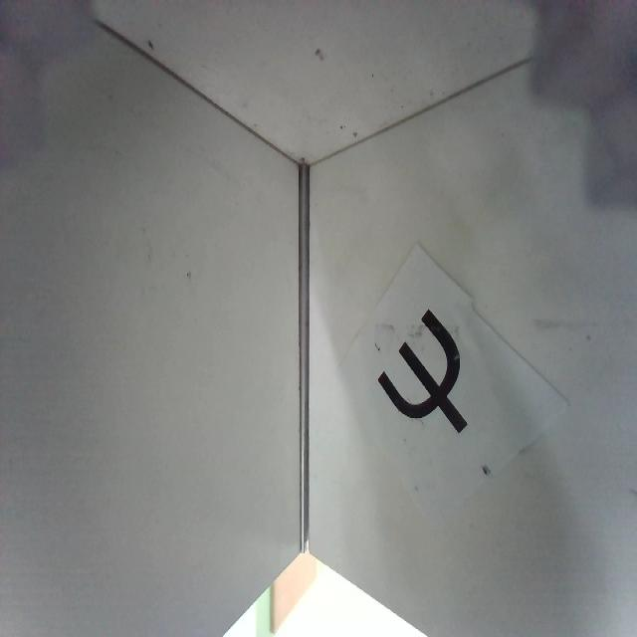
Firmware-rpi/YOLOmazeMINSK/test/images/photoMINSK3_0_jpg.rf.f07594223c571f7ff54d62afe6bf1d9d.jpg
