GarinLev/Theseus_Maze/Firmware-rpi/YOLOmazeMINSK/test/images/photoMINSK3_2_jpg.rf.8b3268ad2767338d5e315b7a3cda1a0f.jpg

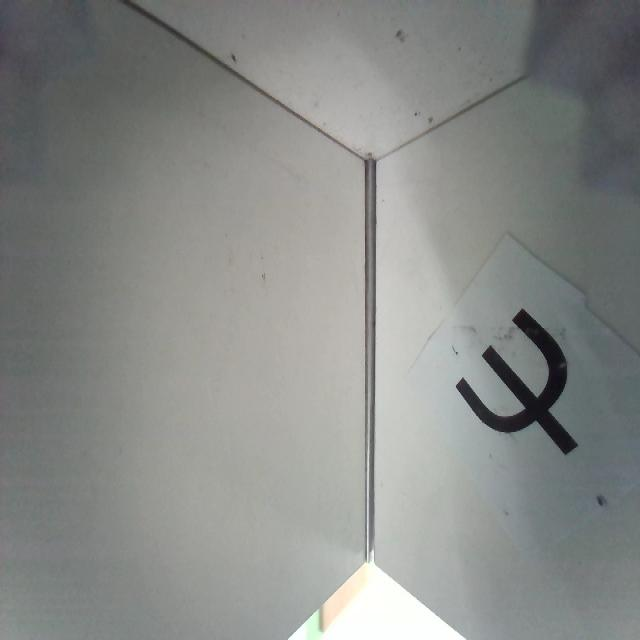
Firmware-rpi/YOLOmazeMINSK/test/images/photoMINSK3_2_jpg.rf.8b3268ad2767338d5e315b7a3cda1a0f.jpg
