GarinLev/Theseus_Maze/Firmware-rpi/YOLOmazeMINSK/test/images/photoMINSK3_24_jpg.rf.2f95f2097bff606b7e7916ee26a6cfe7.jpg

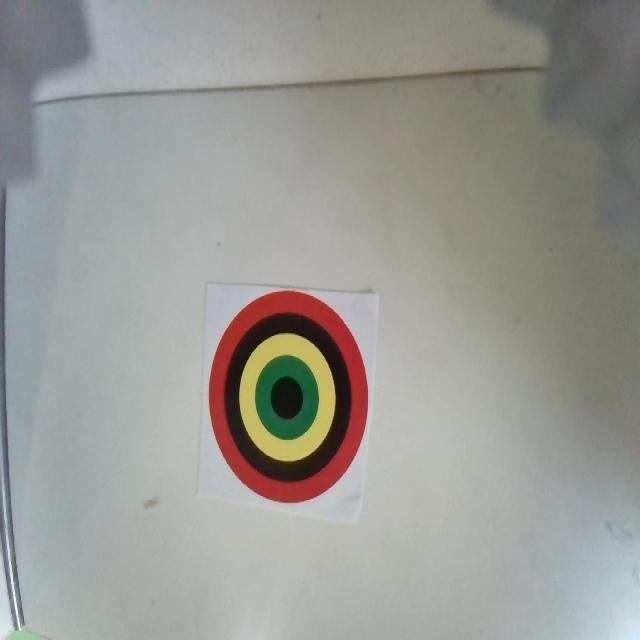
Firmware-rpi/YOLOmazeMINSK/test/images/photoMINSK3_24_jpg.rf.2f95f2097bff606b7e7916ee26a6cfe7.jpg
