GarinLev/Theseus_Maze/Firmware-rpi/YOLOmazeMINSK/test/images/photoMINSK3_32_jpg.rf.c54a55291edcb617769a83361a84539a.jpg

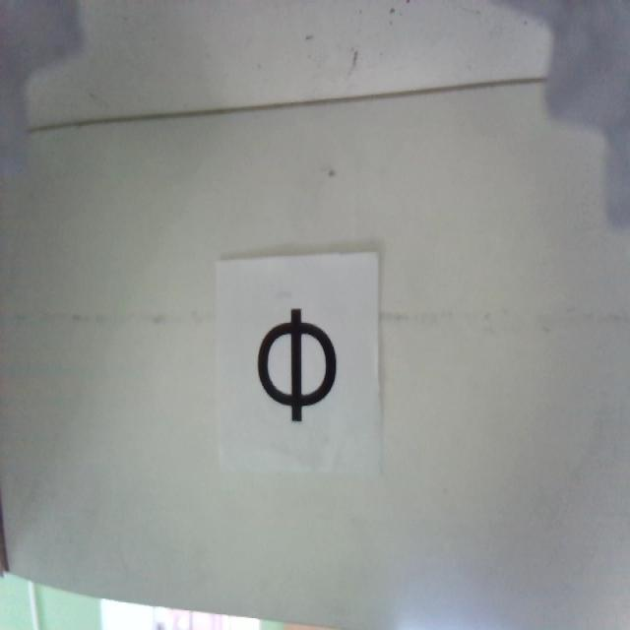
Firmware-rpi/YOLOmazeMINSK/test/images/photoMINSK3_32_jpg.rf.c54a55291edcb617769a83361a84539a.jpg
