GarinLev/Theseus_Maze/Firmware-rpi/YOLOmazeMINSK/test/images/photoMINSK3_34_jpg.rf.0aeeca1f6fd42f7704e4a206db526593.jpg

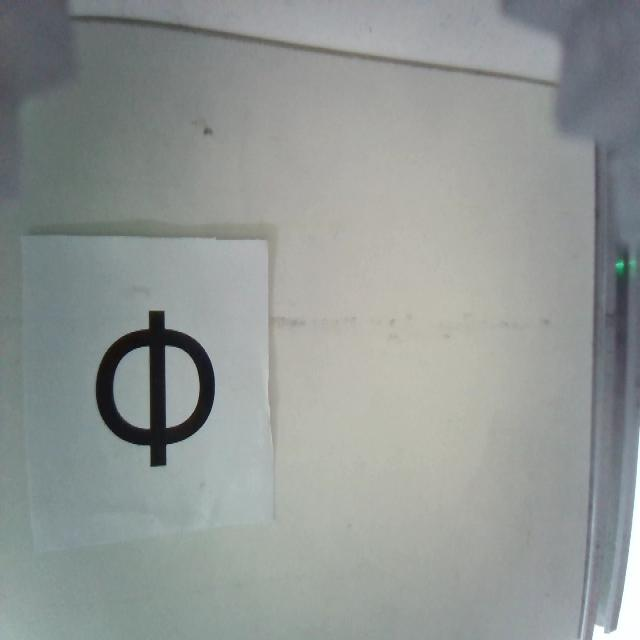
Firmware-rpi/YOLOmazeMINSK/test/images/photoMINSK3_34_jpg.rf.0aeeca1f6fd42f7704e4a206db526593.jpg
