GarinLev/Theseus_Maze/Firmware-rpi/YOLOmazeMINSK/test/images/photoMINSK3_40_jpg.rf.cc025593b2e0d78876c7dac38802d7dd.jpg

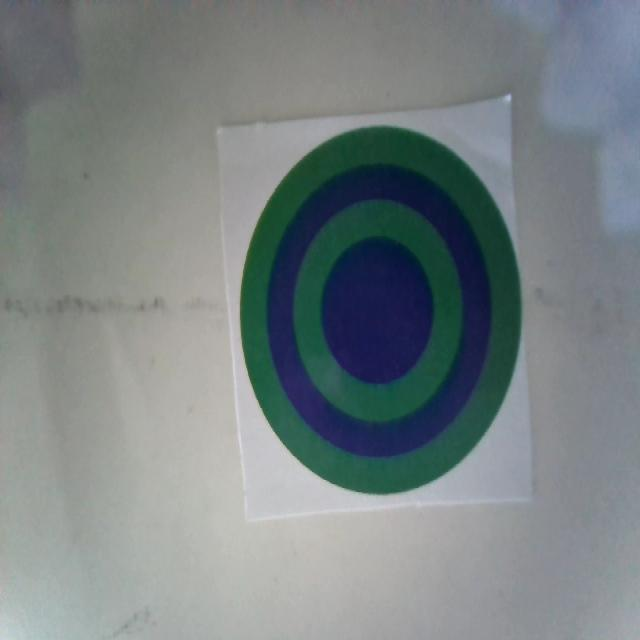
Firmware-rpi/YOLOmazeMINSK/test/images/photoMINSK3_40_jpg.rf.cc025593b2e0d78876c7dac38802d7dd.jpg
