GarinLev/Theseus_Maze/Firmware-rpi/YOLOmazeMINSK/test/images/photoMINSK3_55_jpg.rf.1a69a8422a79ffef06eba4f6047b9297.jpg

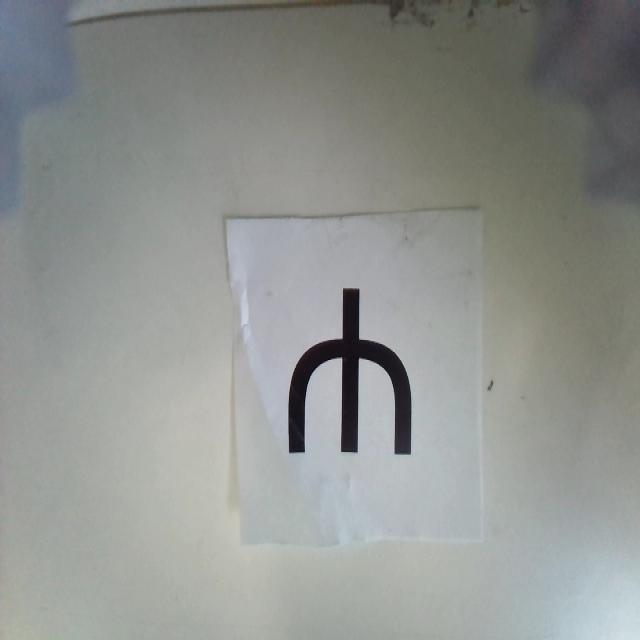
Firmware-rpi/YOLOmazeMINSK/test/images/photoMINSK3_55_jpg.rf.1a69a8422a79ffef06eba4f6047b9297.jpg
