GarinLev/Theseus_Maze/Firmware-rpi/YOLOmazeMINSK/test/images/photoMINSK3_60_jpg.rf.21e344875dd9cbb0c5b0e60a692d9e4e.jpg

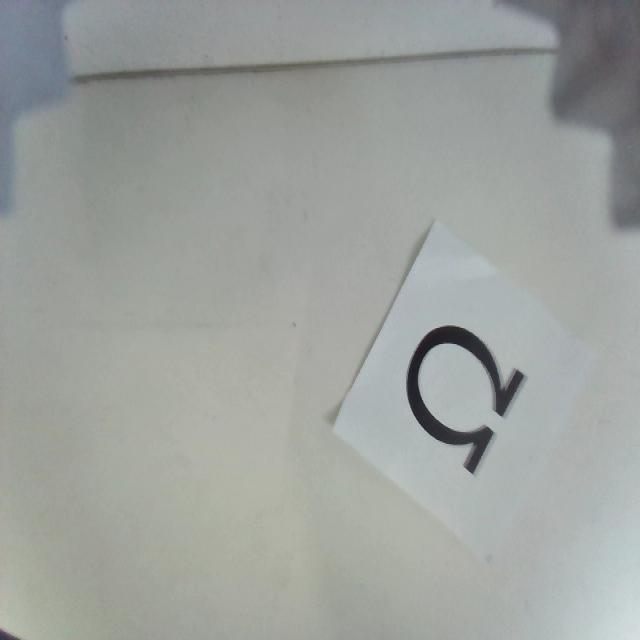
Firmware-rpi/YOLOmazeMINSK/test/images/photoMINSK3_60_jpg.rf.21e344875dd9cbb0c5b0e60a692d9e4e.jpg
