GarinLev/Theseus_Maze/Firmware-rpi/YOLOmazeMINSK/test/images/photoMINSK3_65_jpg.rf.d6255b9171310e183f597ffb04437081.jpg

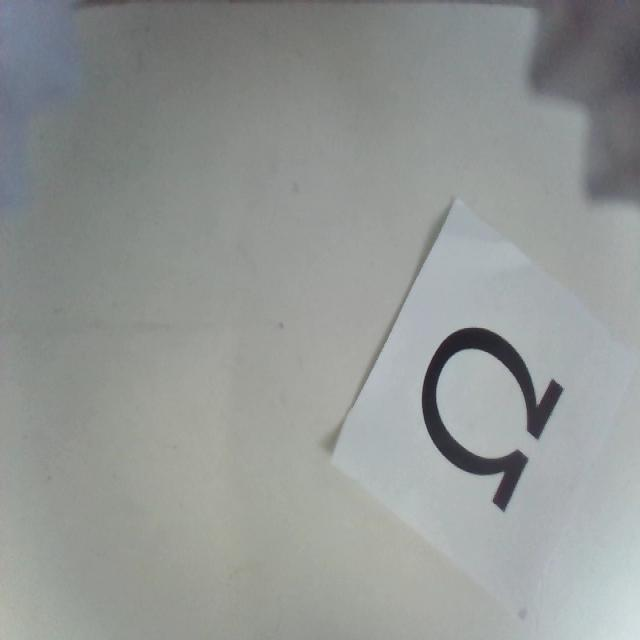
Firmware-rpi/YOLOmazeMINSK/test/images/photoMINSK3_65_jpg.rf.d6255b9171310e183f597ffb04437081.jpg
