GarinLev/Theseus_Maze/Firmware-rpi/YOLOmazeMINSK/test/images/photoMINSK_1_jpg.rf.c1cb9af20a306b2907af9a705dde5bf3.jpg

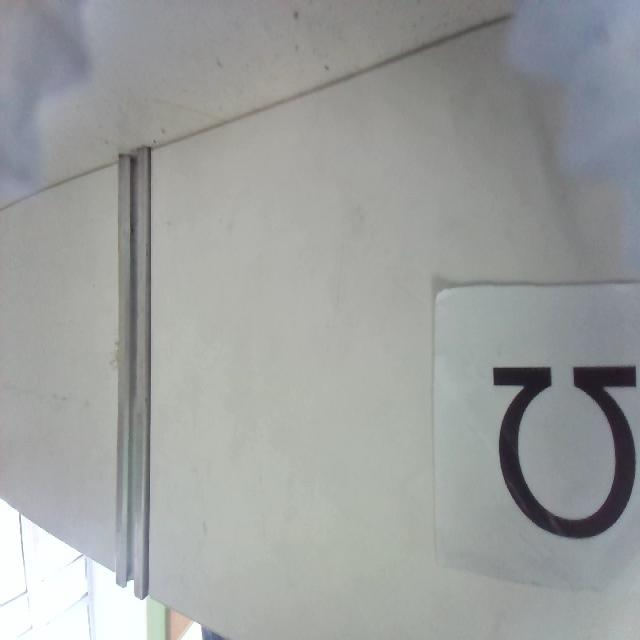
Firmware-rpi/YOLOmazeMINSK/test/images/photoMINSK_1_jpg.rf.c1cb9af20a306b2907af9a705dde5bf3.jpg
