GarinLev/Theseus_Maze/Schematic/maze_Э3_1.pdf

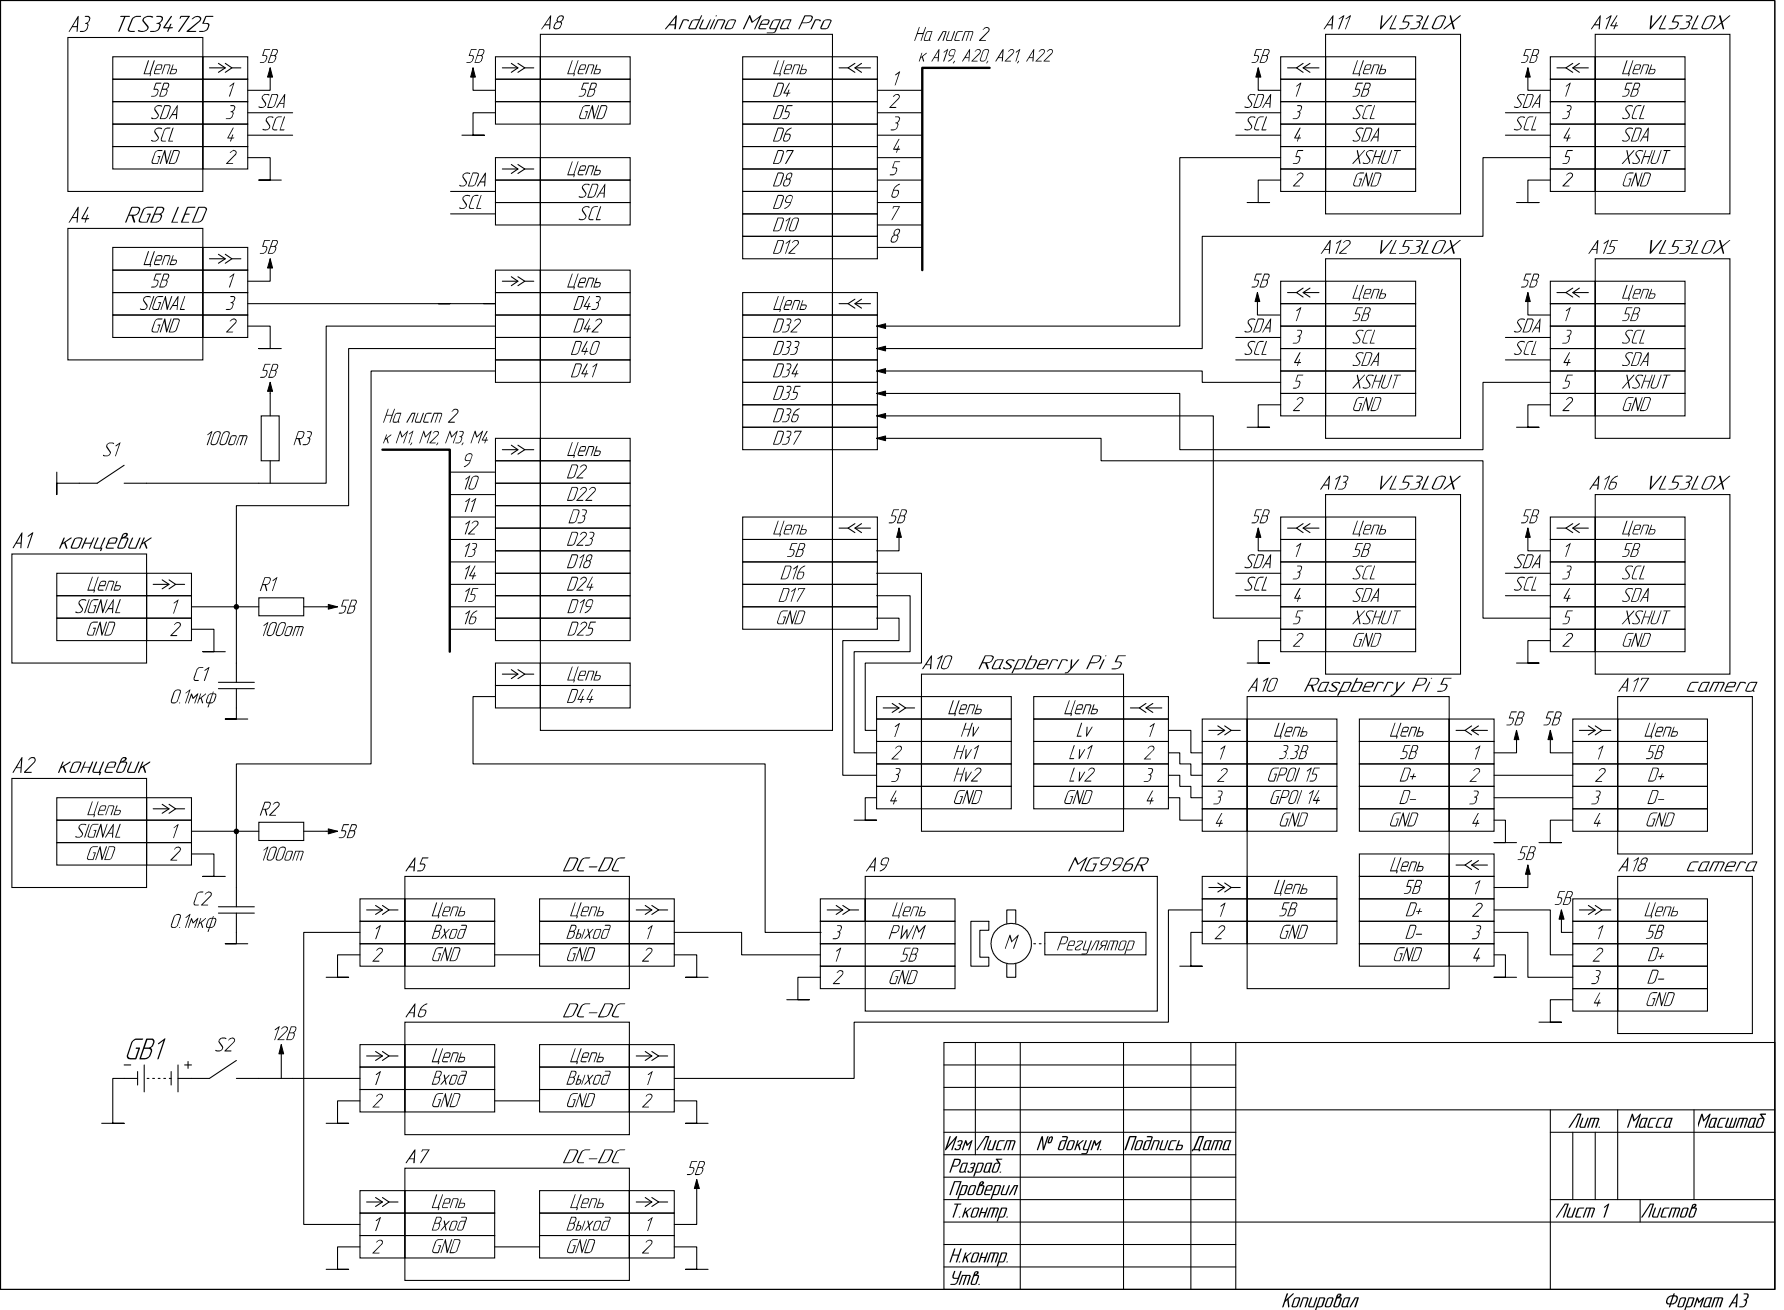
[picture p233: page 1]
