GarinLev/Theseus_Maze/Schematic/maze_Э3_2.pdf

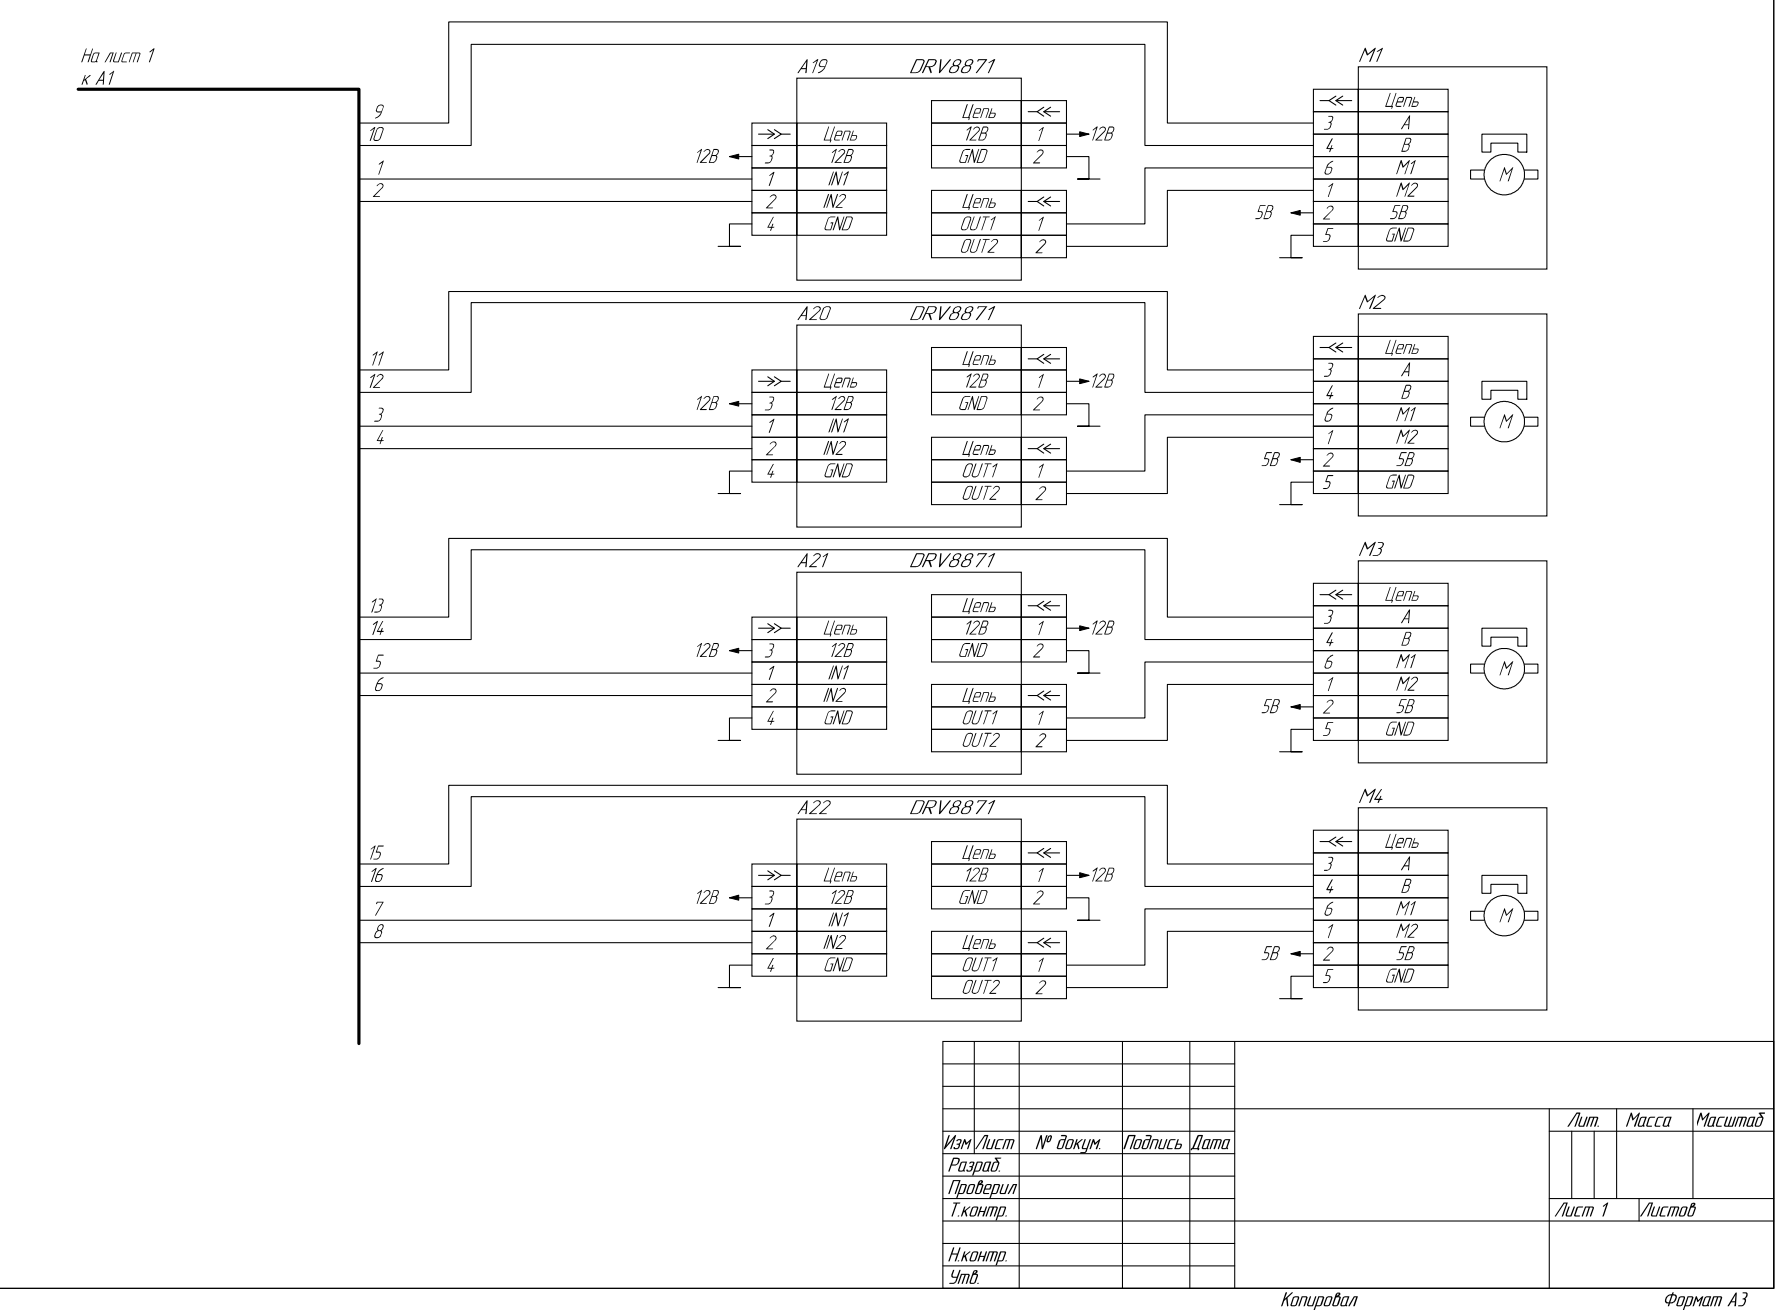
[picture p234: page 1]
