GarinLev/Theseus_Maze/Schematic/mazeE1.pdf

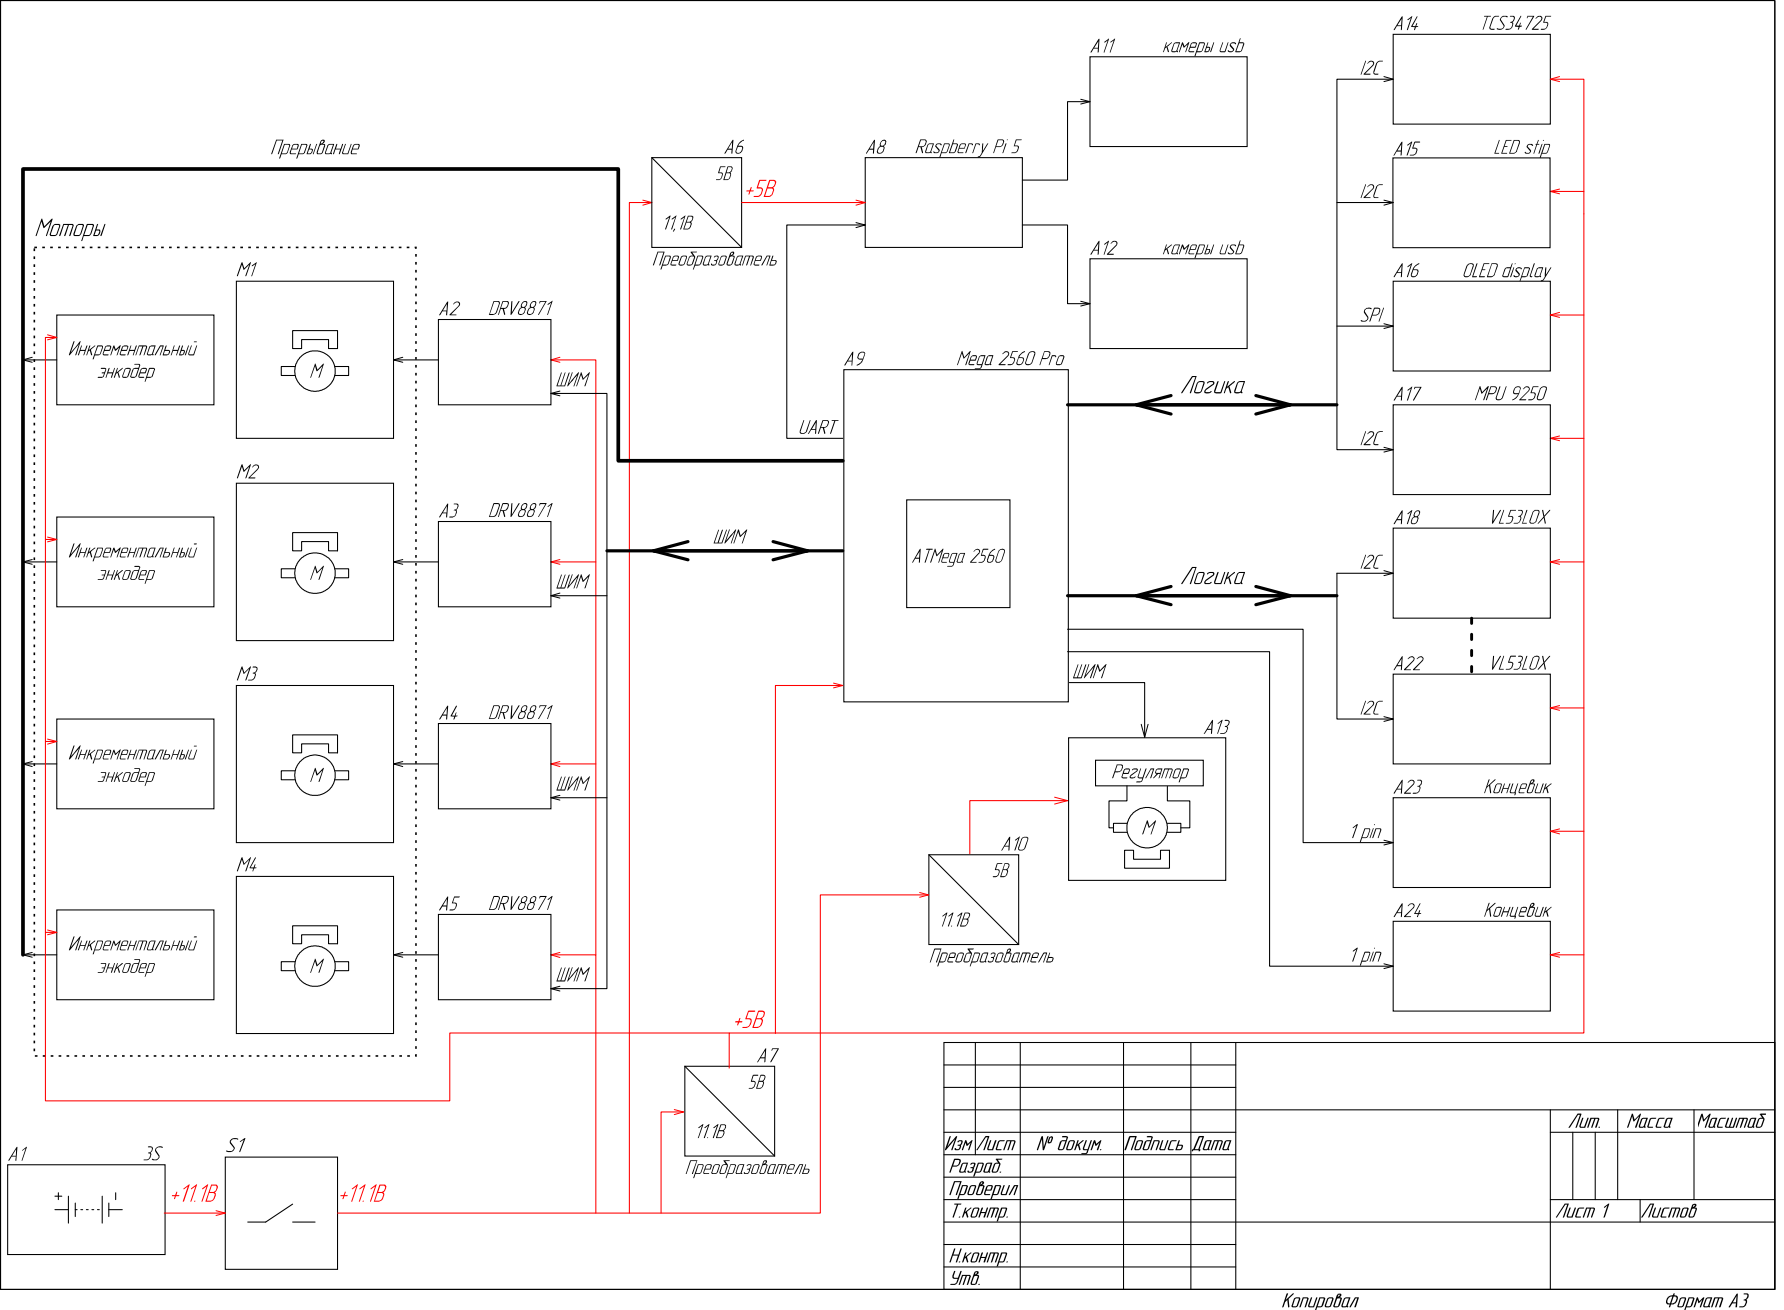
[picture p235: page 1]
