GarinLev/Theseus_Maze/(list of files, drawings)

Other design files:
construction/prototip/maze_prototip.spl8
Schematic/maze_prototip.spl8
Schematic/mazeE1.spl8
