GarinLev/Theseus_Maze/firmware2/src/node/protocol_defs.h

#pragma once

#define PD_START 0b10101011

#define PD_COMMAND_LEN 2
#define PD_COMMAND_START		0b0001
#define PD_COMMAND_STEP			0b0010
#define PD_COMMAND_STEP_UP		'w'
#define PD_COMMAND_STEP_DOWN	'b'
#define PD_COMMAND_STEP_LEFT	0b0100
#define PD_COMMAND_STEP_RIGHT	0b1000
#define PD_COMMAND_PACK			0b0100
#define PD_COMMAND_PACK_L1		0b0001
#define PD_COMMAND_PACK_R1		0b0010
#define PD_COMMAND_PACK_L2		0b0100
#define PD_COMMAND_PACK_R2		0b1000
#define PD_COMMAND_PACK_R2		0b0100
#define PD_COMMAND_END			0b1000


#define PD_RESPONSE_LEN 3
#define PD_RESPONSE_LEN_DDATA 2
#define PD_RESPONSE_OK			0b10000001
#define PD_RESPONSE_SENS		0b10000010
#define PD_RESPONSE_ERR_COMMAND	0b11111111
#define PD_USE_START 0b10000001
#define PD_USE_BTN_P 0b10000010	
#define PD_USE_BTN_C 0b10000100
