GarinLev/Theseus_Maze/firmware/src/module/Wheel.cpp

#include "Wheel.h"

#include <Arduino.h>
#include "Robot.h"

constexpr int SPEED_MIN = -255;
constexpr int SPEED_MAX = 255;
constexpr int ENC_TICK_REV = 500;

void Wheel::init() {
    pinMode(pin_a, OUTPUT);
    pinMode(pin_b, OUTPUT);

    pinMode(pin_encD, INPUT);
    pinMode(pin_encI, INPUT);

    sign = 1;
    enc_timer = micros();

    attachInterrupt(digitalPinToInterrupt(pin_encI),
        enc_func, RISING);
}

void Wheel::set(float speed) {
    float constrained_speed = constrain(speed, SPEED_MIN, SPEED_MAX);
    last_pwm = speed;

    if (receive) {
        constrained_speed = -constrained_speed;
    }

    if (constrained_speed == 0) {
        digitalWrite(pin_a, HIGH);
        digitalWrite(pin_b, HIGH);
    }
    else if (constrained_speed > 0) {
        digitalWrite(pin_a, LOW);
        analogWrite(pin_b, (int16_t)constrained_speed);
    }
    else {
        digitalWrite(pin_a, HIGH);
        analogWrite(pin_b, 255 - (int16_t)abs(constrained_speed));
    }
}

void Wheel::update_sensors() {
    uint32_t local_period = enc_period;
    uint32_t local_timer = enc_timer;
    int8_t local_sign = sign;

    if (micros() - local_timer > 10000) {
        last_rpm = 0.0f;
        return;
    }
    if (local_period < 500) {
        last_rpm = 0.0f;
        return;
    }

    float abs_rpm = (1000000.0f / (float)local_period) / ENC_TICK_REV * 60.0f;
    last_rpm = abs_rpm * local_sign;
}

float Wheel::real() const {
    return last_rpm;
}

void Wheel::update(float pwm) {
    float speed_now = real();
    if (pwm == 0) {
        set(0);
        _pid.reset();
    } else {
        float speed_need = _pid.compute(pwm, speed_now);
        set(-speed_need);
    }
}

void Wheel::set_pid_gains(float kp, float ki) {
    _pid.set_gains(kp, ki);
}

void Wheel::update_pi(float target) {
    if (target < 20.0f) target = 20.0f;
    float kp = _a + _b * target;
    float ki = _c + _d * target;
    set_pid_gains(kp, ki);
}

void Wheel::set_pi_coeffs(float a, float b, float c, float d) {
    _a = a; _b = b; _c = c; _d = d;
}

void Wheel::handle_encoder_interrupt() {
    uint32_t now = micros();

    enc_period = now - enc_timer;
    enc_timer = now;

    if (digitalRead(pin_encD) ^ receive) {
        enc_value--;
        sign = -1;
    } else {
        enc_value++;
        sign = 1;
    }
}

void enc_fr() { Robot::instance().w_fr.handle_encoder_interrupt(); }
void enc_fl() { Robot::instance().w_fl.handle_encoder_interrupt(); }
void enc_br() { Robot::instance().w_br.handle_encoder_interrupt(); }
void enc_bl() { Robot::instance().w_bl.handle_encoder_interrupt(); }
