GarinLev/Theseus_Maze/firmware2/src/node/node_dist.h

#pragma once

#include "../../lib/pt/pt.h"
#include "../macro.h"
#include "../../lib/VL53L0X/VL53L0X_mod.h"
#include "../../lib/Optional/Optional.h"

#define DIST_ARRAY_LEN 5

struct DistNode {
    struct pt pt;
    VL53L0X_mod lox;
    uint8_t addr;
    uint8_t pin_sht;
    TwoWire* wire;
    uint32_t last_read = 0;

    uint16_t dist = 0;
    bool dist_valid = false;

    uint8_t dist_arr_idx = 0;
    uint16_t dist_arr_buff[DIST_ARRAY_LEN] = {};
};

void node_dist_init(DistNode&ctx);
int  node_dist_run(DistNode&ctx);
void node_dist_unreset(DistNode& ctx);
void node_dist_reset(DistNode& ctx);
