GarinLev/Theseus_Maze/firmware2/src/node/nodes.h

#pragma once

#include "node_motor.h"
#include "topic_motor.h"

#include "node_encoder.h"
#include "topic_encoder.h"

#include "node_pi.h"
#include "topic_pi.h"

#include "node_dist.h"
#include "node_angel.h"
