GarinLev/Theseus_Maze/(commit log)

2025-12-22 добавила код для дальномеров
2026-01-05 добавила моторы
2026-01-06 Добавил схему первой версии
    [maze_1.spl8]
2026-01-06 Добавил 3D модель прототипа
    [maze_prototip.iam, крепл_ЛЗД.ipt, крепление_RGB.ipt, крепёж_для_мотора.ipt, основа.ipt]
2026-01-20 взяла из интернета программу для проверки I2C, видимо он не работает также написала базовый скетч для RGB (пока не проверен)
2026-01-28 добавил колёса для прототипа
    [колеса прототип.ipt]
2026-01-28 изменил прототип: добавил моторы, датчики, калёса и муфты
    [maze_prototip.iam]
2026-01-31 переиеновал схему
2026-02-08 загрузил финальную схему и модель прототипа
    [maze.spl8, maze_prototip.iam, maze_prototip.spl8, колеса прототип.ipt, крепл_ЛЗД.ipt, крепление_RGB.ipt, крепёж_для_мотора.ipt, основа.ipt]
2026-02-14 проверены датчики расстояния (обнаружено 3 нерабочих), ргб датчик и моторы
2026-02-15 проверен робьот
2026-02-15 добавил первую версию
    [Generic Li Ion 1850 cell.ipt, MG996R.ipt, MG996R.step, TCS34725 RGB sensor.STEP, TCS34725 RGB sensor.ipt, VL53L0X_TOF.step, akkum.0002.iam, akkum.iam]
2026-02-17 обновил первую версию
    [akkum.0002.iam, akkum.0003.iam, back_part.ipt, base.0008.ipt, base.0009.ipt, base.ipt, circle.0002.ipt, circle.0004.ipt]
2026-02-18 обновил модель первой версии
    [back_part.0006.ipt, back_part.ipt, circle.0005.ipt, circle.ipt, fast_akkum.0002.ipt, fast_akkum.ipt, front_part_2.0005.ipt, front_part_2.ipt]
2026-02-18 добавил лазерный дальномер
    [VL53L0X_TOF.ipt]
2026-02-23 загрузил финальную первую версию
    [Arducam USB Camera module B0431.ipt, back_part.ipt, fast_camera.ipt, fast_motors_left.ipt, front_part_1.ipt, maze_version1.iam, system_extrad.ipt]
2026-02-24 добавил колёса
    [COUPLE FLANGE.ipt, COUPLE FLANGE.stp, camera.STEP, camera.ipt, inside_part_wheel.ipt, tire.ipt, top_part_wheel.ipt, wheel.iam]
2026-03-02 синхронизация 1
2026-03-02 синхронизация1
2026-03-16 исрпавлены моторы
2026-03-23 рабочий код правой руки для прототипа!!!
2026-03-23 проыерила робота не работает 1 мотор и все датчики не инициализируются
2026-03-26 дцбль2
2026-03-30 рабочий код
2026-03-30 добаила датчик цвета с калибровкой (пока без проверки)
2026-04-03 датчик
2026-04-04 +левая рука
2026-04-13 Добавить .gitattributes, .gitignore и LICENSE.txt.
2026-04-13 Добавьте файлы проекта.
2026-04-16 Работает регулятор скорости
2026-04-17 Работает оборот
2026-04-20 Делаю регулятор положения
2026-04-21 Предположительно рабочая езда вдоль стены
2026-04-21 Делаю поворот
2026-04-21 Объединение
2026-04-24 актуализировал Э3
2026-05-04 Вроде работает проезд простой
2026-05-08 добавил код с BFS
2026-05-08 Работает базовое премещение
2026-05-10 Работа над правой рукой
2026-05-11 В работе - прерывание по жертве
2026-05-12 Что то работает но не до конца
2026-05-13 Базовая выдача наборов + Переделаны состояния
2026-05-13 Переделана система приёма задач
2026-05-13 Работа над паузой
2026-05-13 добавил код для пая
2026-05-14 Начало Томска
2026-05-14 Работа
2026-05-14 Перед переподбором коффицентов
2026-05-15 Начало 2 дня
2026-05-15 Перед 2 попыткой
2026-05-15 После всех попыток
2026-05-15 Не работает. Добавил поворот на выравнивании
2026-05-16 добавил код для создания web
2026-05-17 добавил тестовый код для web
2026-05-17 обновил web с движением по клавишам
2026-05-17 добавил код с web(с ездой по правой руке)
2026-05-17 добавил передвижения в версию с web
2026-05-22 добавил +-bfs в web
2026-05-23 добавил в monitor_starter разделение на две части
2026-05-23 частично исправил связку bfs
    [hand.py, monitor_starter.py]
2026-05-23 в bfs добавлена проверка посещённых клеток
2026-05-23 готовый код для езды с web на терминале
2026-05-27 рабочая версия прохождения лаберинта с web
2026-05-27 добавил ser в web
2026-05-28 добавил распознование yolo в версию с web
2026-05-28 Базовый новый код
2026-05-31 исправил логику в camera.py, main.py, hand.py
    [hand.py, main.py]
2026-06-01 Базово с проблемами едет между клетками вперед
2026-06-01 Работает проезд по горкам
2026-06-01 добавил цвет клетки, паузу и yolov8n.pt
2026-06-02 Не рабочий датчик цвета
2026-06-02 Работает отличие цветов
2026-06-02 Проехал по углу лабиринта
2026-06-03 В работе - передача данных
2026-06-05 Едет лучше + концевики
2026-06-06 Улучшения
2026-06-06 Разбираюсь с гироскопом
2026-06-06 Предположительно исправлен гироскоп
2026-06-08 Поправлена выдача
2026-06-08 Работает лучше
2026-06-10 В Минске
2026-06-13 добавил плату оптопары
    [optopar.PcbDoc, optoparaE3.SchDoc, optopara_maze.PrjPcb, optopara_rro.PcbDoc, optopara_rro.PrjPcb, optopara_rroE3.SchDoc]
2026-06-27 обновил репозиторий
    [Arducam USB Camera module B0431.STEP, Arducam USB Camera module B0431.ipt, COUPLE FLANGE.ipt, COUPLE FLANGE.stp, GY-530 VL53L0X ToF.igs, GY-530 VL53L0X ToF.ipt, Generic Li Ion 1850 cell.ipt, MG996R.ipt]
2026-06-27 загрузил все финальные версии модели
    [maze_prototip.iam, колеса прототип.ipt, крепёж_для_мотора.ipt, основа.ipt]
2026-09-04 обновил
    [Arducam USB Camera module B0431.STEP, Arducam USB Camera module B0431.ipt, COUPLE FLANGE.ipt, COUPLE FLANGE.stp, GY-530 VL53L0X ToF.igs, GY-530 VL53L0X ToF.ipt, Generic Li Ion 1850 cell.ipt, MG996R.ipt]
2026-09-06 добавил новую заднюю часть
    [new_back_part.ipt]
2026-09-06 добавил новую систему выдачи
    [maze_version1.0071.iam, maze_version1.0072.iam, maze_version1.iam, new_back_part.0003.ipt, new_back_part.ipt, new_extrad_system.0001.ipt, new_extrad_system.ipt]
2026-09-08 Откат до версии Минска
2026-09-11 Оптимизация памяти
2026-09-11 Предположительно сделан регулятор стенки (в работе) + улучшен PI моторов
2026-09-17 Улучшил проезды и повороты
2026-09-18 Улучшил проезды 2
2026-09-22 В работе цвета
2026-09-26 Переделаны PID-ы
2026-09-30 Улучшил проезды
2026-10-03 Финист
2026-10-03 1 день
